pythonnoob9903/MA-project/documentation.md

# Documentation
## 30.12-5.1
1. autonomous takeoff and flying to point
2. crashing due to high HDOP value
3. crashing due to wire that came of from the previous crash
4. reviewed by multiple people and edited accordingly
5. writing in section dronekit
6. writing literature review, results, dicussion and outlook, and conclusion
7. adding title page
8. problems with takeoff even though it worked before, one parameter was changed... changing it back
9. finalising the written part
10. printing the matura paper
## 23.12-29.12
1. first autonomous takeoff
2. editing all to page 20
3. adding a flyto function, distance to target function
2. writing
3. preamble.tex instead of having it in the beginning of document.tex
## Week 16.12-22.12
1. trying different kinds of taking off methods did not work
2. programming new ideas to take off
3. writing parts of the introduction
## Week 9.12-15.12
1. writing MavProxy and parts of dronekit
2. trying different ideas for the vehicle.simple_takeoff--> did not work
3. sophisticating the log file
## Week 2.12-8.12
1. writing RaspPi and parts of MavProxy
2. some code failsafes and messages to see what failed
3. adding a log file
4. trying to get the drone to fly autonomously, but the simple_takeoff function failed?
## Week 25.11-1.12
1. meters to coordinates convertion
2. getting the VNC to work with my hotspot(I have no idea why it took so long)
3. my code needs more fault proofing before I can testfly
## Week 18.11-24.11
1. getting glossary and tcolorbox to work
2. beginning to program drone
3. getting github to work on RaspberryPi
4. adding the dronekittest.py document to github
5. adding flowchart comments to dronekittest.py

## Week 11.11-17.11
1. getting the channel value to be able to use in the dronekit script
2. beginning to write RaspberryPi Setup
## Week 4.11-10.11
1. designing RasperryPi holder(all three parts)
2. printing the parts and redesign one
3. soldering longer wires to Fc for the Pi
4. arming the motors via python script
5. connecting via serial ports

## Week 28.10-11-3
1. VNC connection
2. getting MAvProxy to work
3. getting Dronekit to work

## Week 21.10-27.10
1. small mostly grammatical changes
2. setting up raspberry pi with ssh connection
3. trying to get VNC connection
## Week 14.10-20.10
1. adding the command \comment[1]{} to latex(deleting it again and using %TODO)
2. starting software considerations chapter
3. soldering motor wire that fell off to esc again
4. getting drone to spin(not to fly because motors are wrongly configured)
5. getting drone to fly, really wobbly
6. drone flies without wobblying
7. writing at software considerations, Fc, ESC,Motor, Battery, Problems, GCS, Firmware installation, GPS connection
8. flying drone and filming it
9. writing GNSS, Radio/Transmitter, Smoke stopper, props/battery charger, reciever/transmitter, battery, motor test, compass callibration, road to first flight
10. adding the pictures

### Questions
- How to cite a picture/the source of the picture?
- What should be in the caption of the picture?
- How should the links be sorted? Because I don't think having them sorted from their dates is a good option.
## Week 7.10-13-10
1. solving the GPS issue(was really easy when I finally found the issue(took 3 hours))
2. trying to get the transmitter connection to the receiver works but not to mission planner or the Fc
3. receiver transmitter works
4. connecting battery to esc via smoke stopper works fine
5. changing parameters to see voltage and amperage on MP
6. compass calibration fail due to no GPS lock
7. compass calibration works(no idea why, probably large vehicle mag cal)
8. soldering one of the Motor cables, because it fell off
9. magfield problems
10. arming on my table after disabling arming_check

### Open Questions
- I will write a message per teams tomorrow.(14.10) with them

## Week 30.9-6.10
1. Flashing Ardupilot onto the Fc with STM32 CubeProgrammer
2. First connection Fc wih MP(Mission Planner)
3. problems with trying to get a GPS signal

### Open Questions
- no new ones
## Week 22.9-29.9

1. Adding to Ground Station and Mission Planner
2. short adding of information about preexisting flightsoftware of Kakute H7 in parts
3. downloading of STM32 CubeProgrammer and latest stable version of Ardupilot for the Kakute H7
### Open Questions
-  If there is no date when the Website was created and no author can I leave them out or should I write something like "unknown"?
[STM32CubeProgrammer](www.st.com/en/development-tools/stm32cubeprog.html)
