pythonnoob9903/MA-project/Random/tempmaturaarbeit.odt

2 Literature Review

After extensive internet research it becomes clear that only one kind of a comparable published

autonomous drone project exists, one with a flight controller (Fc) from the Pixhawk family of Fcs

in connection to a Raspberry Pi [11, 21, 59]. However, it is clear that there are many underground

drone laboratories in the Ukraine war, which do not publish their advances in drone technologies

due to the risk of being bombed by their own inventions. Additionally, there are many large firms,

like Amazon, that are trying to deliver their packages by drones [26].

4 Results

The various test flights showed promising results. The drone followed the path from the coordinates.txt file, which was the main goal of this Matura paper. The different trials showed also, how much one or two parameters already influence the capability of the drone to fly.

Another challenge was integrating the different software components, which are not transparent and sometimes outdated. The software components often conflicted during drone takeoff, with one allowing flight while another prevented it. This also shows the difficulty of software integration, which is a tedious and time expensive task.

This Matura paper also shows how important a log file is for an autonomous system, because once the system takes control, it is impossible to know what is happening and without the data provided by a log file one can also not improve the system.

5 Discussion and Outlook

It should be noted that the built drone is only a proof of concept and requires further testing and tuning to reach full maturity. Additionally, a (infrared) camera can be added to the Raspberry Pi. Due to the nature of the Raspberry Pi being a fully functioning computer, unlike an Arduino, the pictures taken by the camera could be processed directly onboard for tasks such as image recognition. This would be straight-forward, because it is already integrated into the in Raspberry Pi.

6 Conclusion

A general problem in the development process was that the development location at home lacked both a GPS connection and space to test the drone. At home, there was enough space for a soldering/work station to assemble the drone and my 3D printer was also nearby. This came in handy when I misplaced the screw holes in the first iteration of the LowerPiMount and needed to print the revised part again. However, the trips to another location for testing were time-consuming because every time the drone needed to be tested the entire setup -including the laptop- was packed into a bag, moved to the location, and reassembled.

The entire project was interesting, and I learned a lot -from sourcing parts to soldering to codingbut it was also exhausting and sometimes even nerve-racking. It was not entirely sure if the drone would even fly at some point. However, I was quite relieved when it finally did.
