pythonnoob9903/MA-project/Random/main.pdf

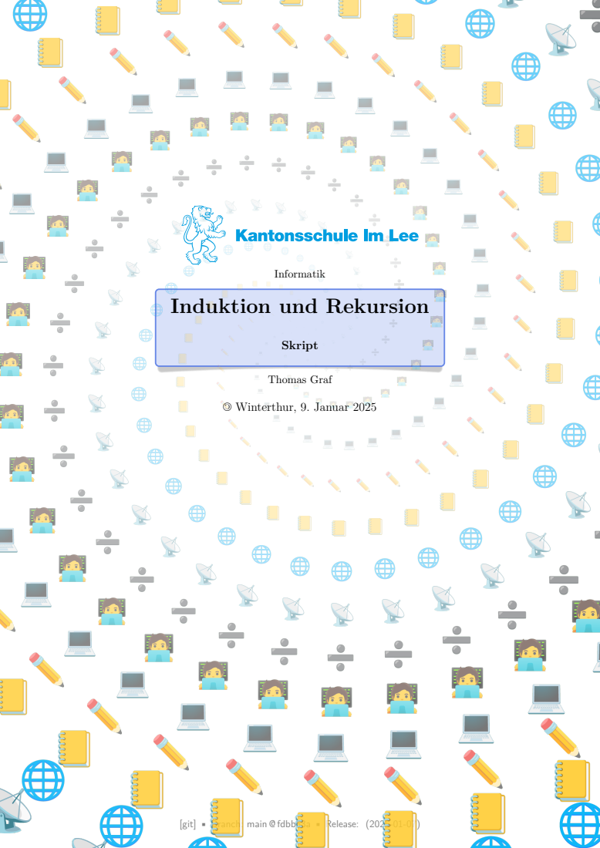
[picture p30: page 1]
Informatik; Skript; Thomas Graf; « Winterthur, 9. Januar 2025

Induktion und Rekursion

[git] • Branch: main @ fdbb53a • Release: (2025-01-07)

# Inhaltsverzeichnis

1 Vorwissen | 1
2 Die natürlichen Zahlen | 6
3 Das Induktionsprinzip | 17
4 Rekursion | 42
5 Binäre Strings ohne aufeinanderfolgende Einsen | 61

Induktion und Rekursion | « Thomas Graf, Informatik, 2025
6 Sortieren (*) | 69
7 Sudoku und Backtracking (*) | 76
Literatur | 94

# Kapitel 1

# Vorwissen

Diese Unterlagen behandeln anspruchsvolle Inhalte der Informatik und Mathematik. Um ihnen gerecht zu werden, bedarf es einer mathematisch präzisen Ausdrucksweise. Den überwiegenden Teil der benötigten mathematischen Werkzeuge werden die Lesenden typischerweise in den ersten Jahren des Gymnasiums kennengelernt haben. Einige der von uns benötigten Konzepte werden den meisten Lesenden jedoch vermutlich noch nicht bekannt sein. Diese Konzepte wollen wir in diesem Kapitel einführen. Wir werden dies in kompakter Form tun und an verschiedenen Stellen auf artifiziell wirkende (forcierte) Beispiele bewusst verzichten.

## 1.1 Mathematik

### 1.1.1 Direkter und indirekter Beweis

Seien A und C mathematische Aussagen. Wir möchten beweisen, dass die Aussage

A ⇒ C
(A impliziert C) gilt. Solch ein Beweis kann im Wesentlichen auf zwei Arten erbracht werden: entweder durch einen direkten Beweis oder einen indirekten Beweis.

### 1.1.1.1 Direkter Beweis

Der direkte Beweis macht von folgender logischen Tatsache Gebrauch: Impliziert A eine weitere Aussage B

A ⇒ B
und B impliziert wiederum C:

B ⇒ C,
dann impliziert A auch C. Zusammengefasst gilt also:
((A ⇒ B) und (B ⇒ C)) ⇒ (A ⇒ C). | (1.1)
Um die Richtigkeit der Implikation A ⇒ C zu beweisen, zerlegt man die Implikation in bereits als für richtig befundene „Teilaussagen“ A ⇒ B und B ⇒ C, also

(A ⇒ B) und (B ⇒ C).

Danach folgt die Implikation A ⇒ C aus Ausdruck 1.1. Diese Strategie kann wiederholt angewendet werden und man erhält eine „Kette“ logischer Implikationen (Schlüsse):

((A ⇒ B1) und (B1 ⇒ B2) und (B2 ⇒ B3) und . . . und (Bn ⇒ C)) ⇒ (A ⇒ C).
Dabei können die Begründungen der Implikationen A ⇒ B1, Bn ⇒ C sowie Bk ⇒ Bk+1 für jedes k ∈ {1, 2, . . . , n − 1} als logische „Zwischenschritte“ verstanden werden.

### 1.1.1.2 Indirekter Beweis

Ein indirekter Beweis (Beweis durch Widerspruch) beginnt mit der Annahme, dass die Aussage C falsch sei, dass also ¬C (nicht C) richtig ist. Nun wird einzig, unter Verwendung der Richtigkeit von A und ¬C sowie bereits als wahr erkannter mathematischer Aussagen, die Richtigkeit einer Aussage B abgeleitet, von der bereits bekannt ist, dass sie falsch ist. Dadurch haben wir einen „Widerspruch“ erhalten und können folgern, dass ¬C nicht richtig sein kann und somit C wahr sein muss. Damit ist, wie gewünscht, die Implikation A ⇒ C nachgewiesen.

### 1.1.2 Kontraposition

Seien A und B mathematische Aussagen. Logisch äquivalent zur Behauptung A ⇒ B ist die Aussage ¬B ⇒ ¬A, welche Kontraposition der Implikation A ⇒ B genannt wird. Der Beweis für A ⇒ B ist demnach auch erbracht, falls man zeigen kann, dass aus der Annahme, die Folgerungen seien nicht erfüllt, folgt, dass auch die Voraussetzungen nicht erfüllt sein können. Gelegentlich fällt es einem leichter, die Kontraposition ¬B ⇒ ¬A einer Implikation A ⇒ B zu zeigen.
Beispiel 1.1:
Sei A die Aussage „Es hat geregnet.“ und B die Aussage „Die Strasse ist nass.“. Die Implikation A ⇒ B bedeutet: „Falls es geregnet hat, ist die Strasse nass.“
Falls die Strasse nass ist, muss das umgekehrt nicht bedeuten, dass es geregnet hat. Beispielsweise könnte die Strasse auch von der Strassenreinigung nass gemacht worden sein. Was wir aber sicherlich sagen können, ist, dass falls die Strasse nicht nass ist, es auch nicht geregnet haben kann, was genau ¬B ⇒ ¬A bedeutet.

### 1.1.3 Funktionen

### 1.1.3.1 Definition einer Funktion

Definition 1.1 (Funktion als Vorschrift):
Seien X und Y Mengen. Wir sagen, dass eine Funktion auf X mit Werten in Y definiert ist, wenn aufgrund einer Vorschrift (Regel) f jedem Element x ∈ X genau ein Element y ∈ Y zugehörig ist.

Wir sagen dann, dass die Menge X die Definitionsmenge der Funktion ist.
Das Symbol x, das benutzt wird, um ein allgemeines Element dieser Menge zu beschreiben, wird Argument oder unabhängige Variable der Funktion genannt.
Das Element y0 ∈ Y , das einem Argument x0 ∈ X zugeordnet wird, wird Wert der Funktion in x0 genannt oder auch Wert der Funktion an der Stelle x = x0 und f(x0) geschrieben. Die Menge Y wird Zielmenge der Funktion genannt.
Bei Änderung der Argumente x ∈ X verändern sich im Allgemeinen die Resultate y = f(x) ∈ Y in Abhängigkeit von den Werten x. Aus diesem Grund wird die Grösse y = f(x) oft auch abhängige Variable genannt.

Definition 1.2 (Bild einer Funktion):
Die Menge
im (f) := { y ∈ Y ; es existiert ein x ∈ X mit y = f(x) } von Werten, die von einer Funktion f für alle Elemente in der Menge X angenommen werden, wird Bild (englisch: image) oder Wertemenge der Funktion f : X → Y genannt. Häufig wird im (f) alternativ als f(X) geschrieben, wobei X die Definitionsmenge von f ist.

### 1.1.3.2 Surjektion, Injektion, Bijektion

In diesen Unterlagen werden wir häufig über Funktionen sprechen. Insbesondere werden wir die folgenden drei Eigenschaften von Funktionen mehrmals verwenden.

Definition 1.3 (surjektiv, injektiv, bijektiv):
Seien X und Y Mengen und f : X → Y eine Funktion.
- f heisst surjektiv (eine Surjektion), falls im (f) = Y .
Intuitiv gesprochen, nimmt eine surjektive Funktion jeden Wert in der Zielmenge an. Zu beliebigem y ∈ Y existiert (mindestens) ein x ∈ X, sodass y = f(x).
- f heisst injektiv (eine Injektion), falls für x1, x2 ∈ X aus x1 6= x2 stets f(x1) 6= f(x2) folgt.
Zwei verschiedene Eingaben erzeugen stets verschiedene Ausgaben.
- f heisst bijektiv (eine Bijektion), falls f sowohl surjektiv als auch injektiv ist.
Da f surjektiv ist, existiert zu jedem y ∈ Y ein x ∈ X mit f(x) = y. Da f injektiv ist, kann es kein anderes x˜ ∈ X mit x˜ 6= x geben, sodass f(˜x) = y. Dadurch stellt eine Bijektion eine „Eins-zu-eins-Zuweisung“ zwischen den Elementen aus X und Y dar.

X

Y

(a) surjektiv, nicht injektiv

X

Y

(b) injektiv, nicht surjektiv

X

Y

(c) bijektiv
Abbildung 1.1: schematische Darstellung der Eigenschaften in Definition 1.3

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
(a) surjektiv, nicht injektiv

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
(b) injektiv, nicht surjektiv
X | Y
10
3
15
1 | 1
| 5
| 8
| 15
(c) bijektiv
Abbildung 1.2: Diagramm-Darstellung der Eigenschaften in Definition 1.3

Betrachten Sie Abbildung 1.1. Diese stellt die in Definition 1.3 beschriebenen Eigenschaften für eine Funktion f : X → Y schematisch dar. Abbildung 1.1a zeigt eine Funktion, die surjektiv, aber nicht injektiv ist, Abbildung 1.1b eine Funktion, die injektiv, aber nicht surjektiv ist. Schliesslich wird in Abbildung 1.1c eine bijektive Funktion dargestellt. Abbildung 1.2 illustriert Surjektivität, Injektivität und Bijektivität für einfache Funktionen auf konkreten endlichen Mengen. Surjektivität, Injektivität und Bijektivität sind Eigenschaften, welche eine gegebene Funktion entweder haben kann oder nicht.

### 1.1.3.3 Folgen

Definition 1.4 (Folge):
Ist X eine beliebige Menge und f : N → X eine Funktion, welche auf N definiert ist und Werte in X annimmt, dann wird f eine Folge (in X) genannt. Ist g : D → X eine Funktion und D ( N eine endliche Teilmenge der natürlichen Zahlen, so wird g endliche Folge in X genannt.

Häufig schreibt man (xn)n∈N,(xn) oder auch (x0, x1, x2, . . .) für die Folge f. Dabei bezeichnet xn := f(n) das n-te Glied der Folge f = (x0, x1, x2, . . .) für jedes n ∈ N.

Beispiel 1.2:
Die Funktion f : N → Z mit n 7→ 2n ist die Folge der geraden natürlichen Zahlen.

## 1.2 Programmieren in Python

Wir werden hier keine Einführung in die Python-Programmiersprache geben. Wir führen im Folgenden einige Details der Python-Sprache auf, welche wir in den Übungsaufgaben der nächsten Kapitel verwenden werden.
- Der Modulo-Operator % (Prozent-Symbol) kann in der Form a % b verwendet werden und liefert den ganzzahligen Rest bei der Division von a mit b. Beispielsweise sind die folgenden Ausdrücke wahr:
7 % 3 == 1, 5 % 8 == 5, 22 % 4 == 2, 42 % 6 == 0. Wir werden den Modulo-Operator zur Überprüfung auf Teilbarkeit verwenden. Denn b ist offensichtlich genau dann ein Teiler von a, falls a % b == 0 gilt.
- Eine Liste in Python wird durch eckige Klammern gekennzeichnet. Beispielsweise ist [3,2,2,7] eine Liste mit 4 Einträgen. Eine leere Liste (Liste ohne Einträge) wird durch „leere eckige Klammern“ [] bezeichnet. Mit dem Aufruf L.append(x) wird ein Eintrag x hinten (von rechts) in eine bereits bestehende Liste L eingefügt (angehängt). Mit L[-1] wird der letzte (am weitesten rechts stehende) Eintrag der Liste L bezeichnet. Der Ausdruck L[:-1] bezeichnet alle Einträge der Liste mit Ausnahme des letzten.
- In Python existiert die Möglichkeit, Argumenten einer Funktion ein Default-Argument zu geben.
# Default-Argument in Python

def eineFunktion(a, b = 5):
print(a + b)

eineFunktion(3,6) # gibt den Wert 9 aus
eineFunktion(3) # Aufruf mit Default-Argument b = 5: gibt den Wert 8 aus Programm 1.1: Default-Argument

Dieses Default-Argument wird genau dann verwendet, falls kein Wert für dieses Argument (explizit) angegeben wird.
- Die Operation math.ceil(x) wird Aufrundungs-Operation genannt und gibt die kleinste ganze Zahl, die grösser oder gleich x ist. Beispielsweise gelten math.ceil(3.2) = 4 und math.ceil(3) = 3. Um diese Operation verwenden zu können, muss die Bibliothek math durch den Befehl import math vor dem Gebrauch dieser Operation ins Programm eingefügt werden.
In Listing 1.2 haben wir die obigen Punkte noch einmal zusammengefasst.
1 # gibt die durch 19 teilbaren Zahlen in {0,1,2,...,99} aus:
2 for k in range(100):
3 | if (k % 19) == 0:
4 | print(k) # gibt aus: 0 19 38 57 76 95

5
6 # Listen
7 L = [3, 7, 2, 3]
8 L.append(99) # L ist nun [3, 7, 2, 3, 99]. 9 print(L[-1]) # gibt aus: 99
10 print(L[:-2]) # gibt aus: 3, 7, 2

11
12 # Default-Argument
13 def person(vorname, nachname = 'Nachname unbekannt', alter = '-'):
14 | print('Vorname: ', vorname, ', ' , 'Nachname: ', nachname, ', ', 'Alter: ',
| alter, sep='')

15
16 person('Sandra') # gibt aus: Vorname: Sandra, Nachname: Nachname unbekannt,
| Alter: -

17
18 person('Toni', 'Wildeisen') # gibt aus: Vorname: Toni, Nachname: Wildeisen,
| Alter: -

19
20 # Importieren einer Bibliothek und Verwendung der Aufrundungs-Funktion
21 import math # Einfügen der Bibliothek 'math'
22 print(math.ceil(3.00002)) # gibt aus: 4
| Programm 1.2: Vorwissen Python

# Kapitel 2

# Die natürlichen Zahlen

## 2.1 Historische Betrachtung der natürlichen Zahlen

Die natürlichen Zahlen werden so genannt, da sie auf „natürliche Weise“ beim Zählen verwendet werden. Auf dem Gebiet der heutigen Demokratischen Republik Kongo wurde im 20. Jahrhundert ein Knochen, der sogenannte Ishango-Knochen, gefunden. Dieser Knochen wird auf die Zeit vor etwa 18’000 bis 20’000 Jahren vor unserer Zeitrechnung datiert. In dem Knochen sind ganz offensichtlich von Menschen einige Kerben eingeritzt worden. Die Bedeutung dieser Kerben ist nicht klar. Es wird jedoch angenommen, dass diese Kerben eine bestimmte Anzahl festhalten.
Stellen wir uns vor, dass die Kerben die Anzahl der gefangenen Fische ( ) an einem bestimmten Tag darstellen. Gefangene Fische durch Kerben in einem Knochen zu repräsentieren, verlangt bereits einen recht hohen Grad an Abstraktion! Schliesslich haben gefangene Fische und Kerben in einem Knochen auf den ersten Blick keinen offensichtlichen Zusammenhang. Anstelle von Kerben in einem Knochen könnte die Fangmenge eines Tages auch durch die entsprechende Anzahl von Kieselsteinen oder durch (abstraktere) römische Numerale repräsentiert werden. Wichtig für uns ist, dass die konkrete Wahl der Darstellung, zumindest rein mathematisch betrachtet, unwichtig ist. Schliesslich stellen die verschiedenen Darstellungen alle dieselbe Anzahl von Fischen dar. Betrachten Sie Tabelle 2.1. Mit dem Symbol meinen wir nicht ein Fisch-Emoji, sondern den eigentlich gefangenen Fisch. Die direkte Darstellung der Anzahl der gefangenen Fische durch sich selbst ist offensichtlich am wenigsten abstrakt. Die Darstellung durch Kerben oder Kieselsteine bedarf bereits einer nicht unerheblichen Abstraktion. Dhttps://www.youtube.com/watch?v=c8l7K67idZcie Darstellungen durch das römische, dezimale und binäre Zahlensysteme sind noch eine Stufe abstrakter.
Fische | Kieselsteine | römisch binär dezimal
(keine) | (keine) nichts (nihil) | 0 | 0
- | I | 1 | 1
•• | II | 10 | 2
••• | III | 11 | 3
•••• | IV | 100 | 4
••••• | V | 101 | 5
•••••• | VI | 110 | 6
••••••• | VII | 111 | 7
•••••••• | VIII | 1000 | 8
••••••••• | IX | 1001 | 9
Tabelle 2.1: mögliche Darstellungen der Anzahl gefangener Fische

Die Zahl Null hat eine lange und kontroverse Geschichte hinter sich. Vermutlich hatten die Römer kein explizites eigenes Symbol für die Null. Wir werden jedoch die Null als die erste (kleinste) natürliche Zahl auffassen.

## 2.2 Unendlichkeit der natürlichen Zahlen und konstruktive Induktion

Bereits aufgrund der kurzen Anekdote über die gefangenen Fische und Kieselsteine in Abschnitt 2.1 kann man sich denken, dass es unendlich viele natürliche Zahlen geben muss. Wieder denken wir uns eine natürliche Zahl als genau das Symbol, welches eine bestimme Anzahl an Kieselsteinen darstellt. Dann ist klar, dass es keine grösste natürliche Zahl geben kann, denn schliesslich kann stets ein weiterer Kieselstein hinzugefügt werden, was uns eine noch grössere Zahl liefert. Zu jeder natürlichen Zahl n, angefangen mit der 0, erhalten wir (durch Hinzufügen eines Kieselsteins) eine weitere natürliche Zahl. Diese neue Zahl werden wir den Nachfolger von n nennen. Die folgenden Überlegungen dieses Kapitels formalisieren diese Vorstellungen und stellen diese mathematisch präzise dar. Doch auch ohne mathematische Formeln können wir das folgende Gedankenexperiment durchführen. Angenommen Sie sind in der Lage Folgendes zu tun:
- Sie können eine Treppe mit 0 Stufen (ohne Stufen) bauen.
- Falls Sie bereits eine Treppe mit einer beliebigen (natürlichen) Anzahl von Stufen gebaut haben, dann können Sie diese Treppe um eine Stufe erweitern (siehe Abbildung 2.1).
Dann werden Sie es für glaubhaft halten, dass Sie eine Treppe mit beliebig vielen Stufen bauen können. Wie dieses Gedankenexperiment mit der mathematischen Definition der natürlichen Zahlen zusammenhängt, werden Sie im nächsten Abschnitt sehen.

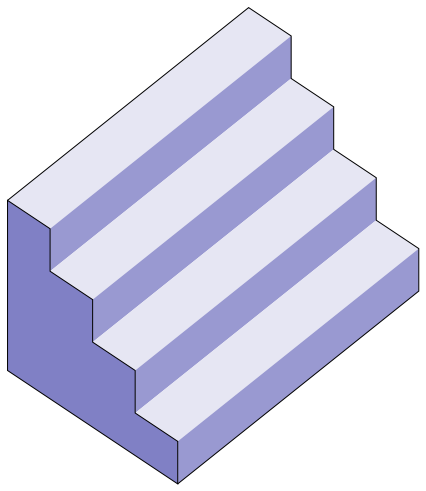
[picture p31: figure]
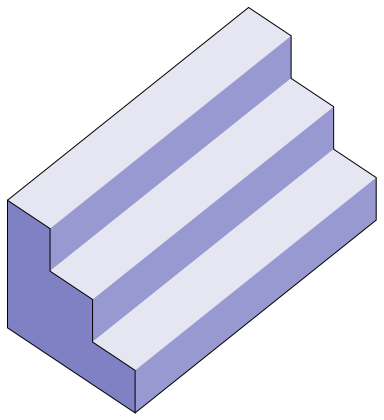
[picture p32: figure]

Abbildung 2.1: Erweiterung einer Treppe um eine weitere Stufe.

## 2.3 Die Peano-Axiome

Uns ist vollkommen bewusst, dass Sie bereits seit Ihrer Kindheit mit dem Konzept der natürlichen Zahlen vertraut sind. Sie konnten vermutlich schon als Kleinkind Gegenstände zählen und lernten spätestens in der Grundschule die Addition und Multiplikation natürlicher Zahlen kennen. Für diese einfachen Anwendungen reicht eine rein intuitive Beschreibung der natürlichen Zahlen vollkommen aus.

Sie werden jedoch festgestellt haben, dass mit fortschreitender schulischer Reife eine präzise Definition von Begriffen und Konzepten zunehmend an Bedeutung gewinnt. Auf der Stufe des Gymnasiums wird der bis dorthin rein intuitiv geprägte Begriff der natürlichen Zahlen durch das Konzept der Mengen formalisiert. Ab dann wird von der Menge der natürlichen Zahlen, bezeichnet durch das Symbol N, gesprochen.

## 2.4 Informale Definition der natürlichen Zahlen

In Lehrbüchern des Gymnasiums (siehe zum Beispiel [1]¹
) wird die Menge der natürlichen Zahlen typischerweise wie folgt definiert:

Definition 2.1 (Informale Definition der natürlichen Zahlen): Die Menge

N := {0, 1, 2, 3, 4, . . .}
wird als die Menge der natürlichen Zahlen bezeichnet.

Man beginnt also bei 0 und zählt dann unbegrenzt weit nach vorne. In einem gewissen Sinne beantwortet Definition 2.1 die Frage, was natürliche Zahlen sind: Eine natürliche Zahl ist ein Element der Menge N. Dennoch ist die Definition nicht sehr befriedigend, denn sie beantwortet nicht die Frage, was N selbst ist. [2] Wir werden nicht von dieser Definition Gebrauch machen, sondern eine nützlichere Definition entwickeln.
Der folgende Abschnitt ist teilweise inspiriert durch die entsprechenden Teile in den hervorragenden Büchern [2] und [3].
Bei näherer Betrachtung wirft die informale Definition 2.1 insbesondere die folgenden drei Fragen auf:
1. Woher wissen wir, dass wir beliebig lange weiter vorwärts zählen können, ohne schliesslich (wie bei einer Uhr) wieder bei der 0 anzukommen?
2. Wie sollen nun Operationen wie die Addition, Multiplikation und die Potenz definiert werden? Die zweite Frage wollen wir zuerst besprechen. Komplizierte Operationen können durch einfachere Operationen ausgedrückt werden. So ist Potenzieren lediglich wiederholtes Multiplizieren und Multiplizieren wiederum wiederholtes Addieren. Zum Beispiel sind 5

3 nichts weiter als drei Fünfer miteinander multipliziert und 6 · 3 lediglich sechs Dreien miteinander addiert. Wie sieht es mit der Addition aus? Die Addition kann durch wiederholtes Inkrementieren oder Vorwärtszählen realisiert werden. Bei der Addition 4 + 3 wird die Vier dreimal inkrementiert (wir zählen von der Vier aus dreimal vorwärts). Inkrementieren scheint eine fundamentale Operation zu sein, welche sich nicht auf eine noch einfachere Operation reduzieren lässt.
Eine sinnvolle Definition der natürlichen Zahlen scheint also das Inkrementieren als fundamentales Konzept zu verwenden. Für eine natürliche Zahl n werden wir im Folgenden mit ν(n) das Inkrement von n bezeichnen. Wir werden ν(n) auch den Nachfolger von n nennen. Zum Beispiel gilt 3 = ν(2), 4 = ν(3) = ν(ν(2)) und so weiter. Das Inkrementieren liefert uns also einen „Zählvorgang“, der bei 0 beginnt. Die bisherigen Überlegungen lassen vermuten, dass wir N als die Menge mit den Elementen

0, ν(0), ν(ν(0)), ν(ν(ν(0))), ν(ν(ν(ν(0)))), ν(ν(ν(ν(ν(0))))), . . .
1Dieses Buch bietet allerdings auch eine alternative Definition der natürlichen Zahlen an.

ansehen wollen. Diese Menge enthält 0 und alle Objekte, welche aus 0 durch Inkrementieren erhalten werden können. Sie wissen bereits, dass fundamentale (nicht beweisbare) Annahmen in der Mathematik als Axiome bezeichnet werden. Bislang haben wir zwei fundamentale Annahmen bezüglich der Menge N der natürlichen Zahlen getroffen. Diese fassen wir in zwei Axiomen zusammen:

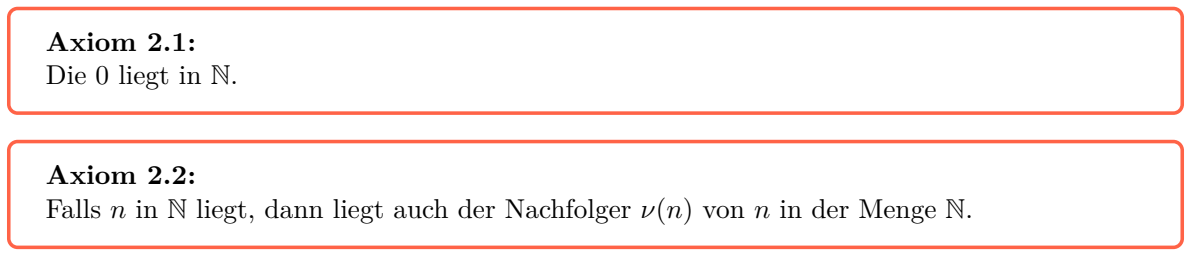
[picture p33: figure]
Axiom 2.1: Die 0 liegt in N.; Axiom 2.2:

Falls n in N liegt, dann liegt auch der Nachfolger ν(n) von n in der Menge N.

Dies sind die ersten zwei von insgesamt fünf Axiomen, welche zusammen bekannt sind als die Peano-Axiome der natürlichen Zahlen. Die Peano-Axiome sind benannt nach dem italienischen Mathematiker Giuseppe Peano, welcher diese Axiome im Jahr 1889 formulierte.

Bemerkung 2.1:

- Beachten Sie, dass Axiom 2.2 lediglich aussagt, dass der Nachfolger ν(n) einer natürlichen Zahl n wieder eine natürliche Zahl ist. Das Axiom sagt nichts darüber aus, wie dieser Nachfolger lautet.
- Manche Autorinnen und Autoren ziehen es vor, den „Zählvorgang“ nicht bei 0, sondern bei 1 zu beginnen. Dies ist mathematisch ohne Bedeutung. [3]
- Wir definieren 1 := ν(0), 2 := ν(1) = ν(ν(0)), 3 := ν(2) = ν(ν(ν(0))) und so weiter. Anstelle von

0, ν(0), ν(ν(0)), ν(ν(ν(0))), ν(ν(ν(ν(0)))), ν(ν(ν(ν(ν(0))))), . . .
schreiben wir üblicherweise 0, 1, 2, 3, 4, 5, . . .

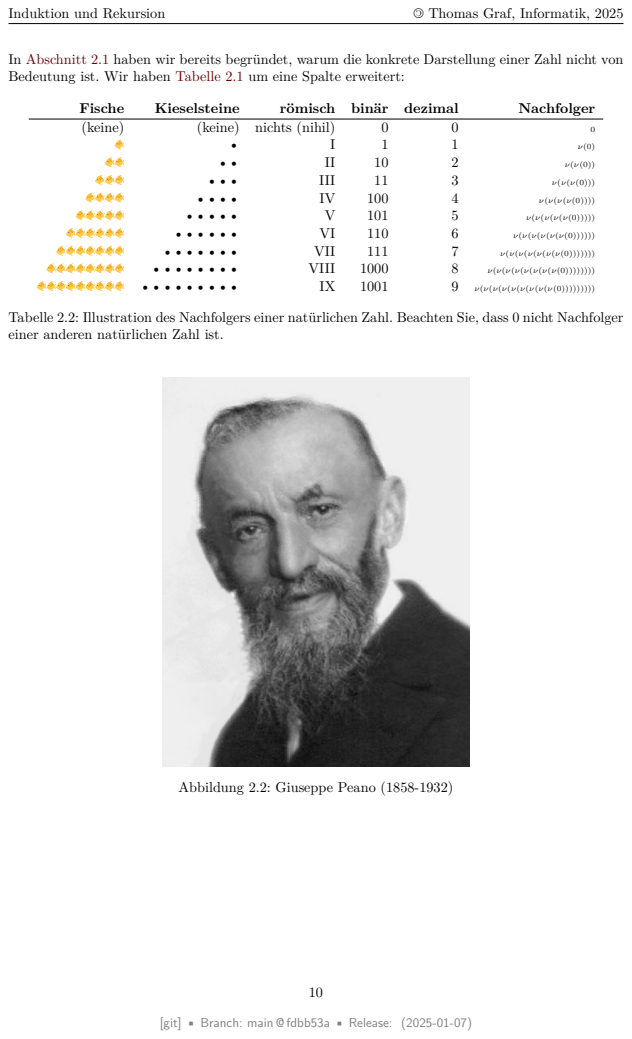
[picture p34: page 13]
Fische; Kieselsteine; römisch binär dezimal; Nachfolger; (keine); (keine) nichts (nihil); III; VII; VIII

In Abschnitt 2.1 haben wir bereits begründet, warum die konkrete Darstellung einer Zahl nicht von
Bedeutung ist. Wir haben Tabelle 2.1 um eine Spalte erweitert:

Tabelle 2.2: Illustration des Nachfolgers einer natürlichen Zahl. Beachten Sie, dass 0 nicht Nachfolger
einer anderen natürlichen Zahl ist.

Abbildung 2.2: Giuseppe Peano (1858-1932)

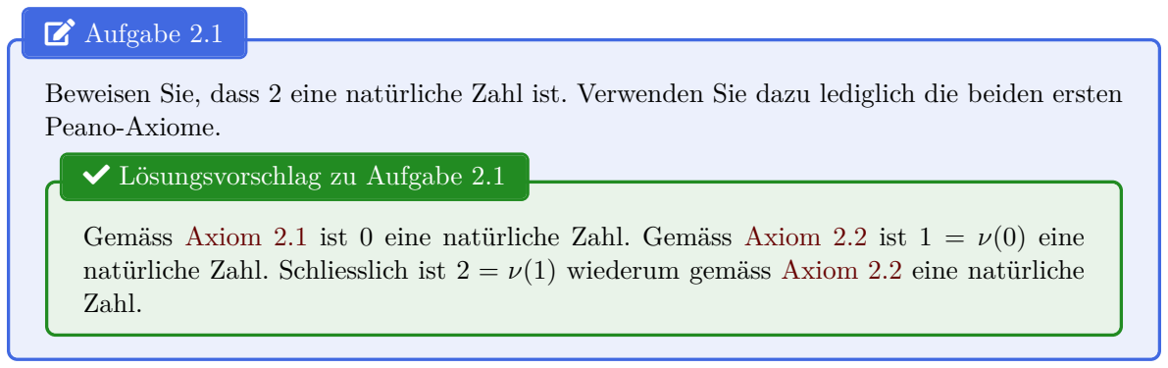
[picture p35: figure]
EDIT Aufgabe 2.1; Peano-Axiome. Check Lösungsvorschlag zu Aufgabe 2.1; Zahl.

Beweisen Sie, dass 2 eine natürliche Zahl ist. Verwenden Sie dazu lediglich die beiden ersten

Gemäss Axiom 2.1 ist 0 eine natürliche Zahl. Gemäss Axiom 2.2 ist 1 = ν(0) eine natürliche Zahl. Schliesslich ist 2 = ν(1) wiederum gemäss Axiom 2.2 eine natürliche

Bereits Giuseppe Peano stellte fest, dass diese ersten beiden Axiome nicht ausreichend sind, um unsere intuitive Vorstellung der natürlichen Zahlen einzufangen. Es könnte sein, dass wir bei dem Vorwärtszählen schliesslich wieder bei 0 ankommen. Betrachten wir dazu ein Modell der natürlichen Zahlen, welches von 3 zurück zur 0 zählt, genauer: ν(0) ist 1, ν(1) ist 2, ν(2) ist 3, aber ν(3) ist wieder 0 (und gemäss der Definition von 4 auch gleich der 4). So erfüllt also auch die Menge {0, 1, 2, 3} die ersten zwei Peano-Axiome und könnte als Menge der natürlichen Zahlen angesehen werden.

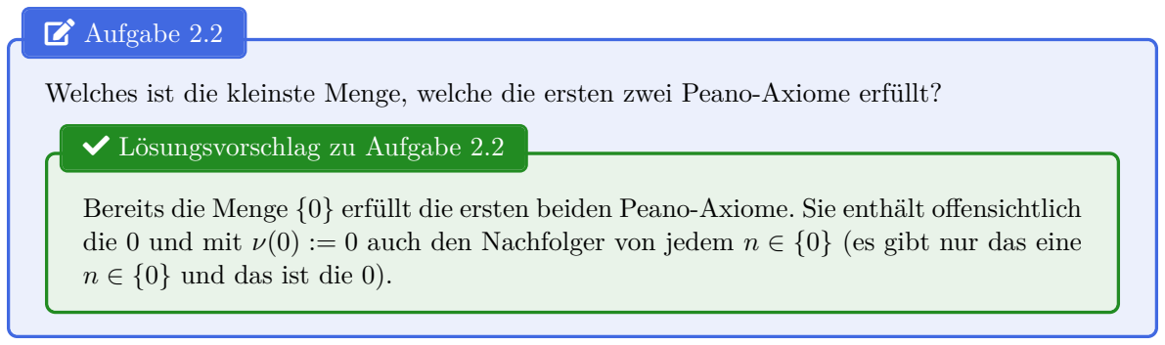
[picture p36: figure]
EDIT Aufgabe 2.2; Check Lösungsvorschlag zu Aufgabe 2.2; n ∈ {0} und das ist die 0).

Welches ist die kleinste Menge, welche die ersten zwei Peano-Axiome erfüllt?

Bereits die Menge {0} erfüllt die ersten beiden Peano-Axiome. Sie enthält offensichtlich
die 0 und mit ν(0) := 0 auch den Nachfolger von jedem n ∈ {0} (es gibt nur das eine

Die Axiome 2.1 und 2.2 erlauben also auch Mengen, welche wir sicherlich nicht als Modelle der natürlichen Zahlen anschauen möchten. Wir müssen die erlaubten Nachfolger der Elemente der Mengen weiter einschränken. Auf jeden Fall stellen wir fest, dass die 0 nicht Nachfolger einer natürlichen Zahl sein soll und fordern deshalb:

Axiom 2.3:
Die 0 selbst ist nicht Nachfolger einer natürlichen Zahl. Es gilt also ν(n) 6= 0 für jede natürliche Zahl n.

Bemerkung 2.2:
Wir bezeichnen mit N

× die Menge der natürlichen Zahlen ohne die 0. Für jede natürliche Zahl n soll der Nachfolger ν(n) von n wieder eine natürliche Zahl sein. Da gemäss Axiom 2.3 die 0 nicht Nachfolger einer natürlichen Zahl ist, können wir uns ν als Funktion

ν : N → N

×,

n 7→ ν(n)
denken. Diese erhält eine natürliche Zahl n als Eingabe und liefert die natürliche Zahl ν(n), welche nicht die 0 ist, als Ausgabe.

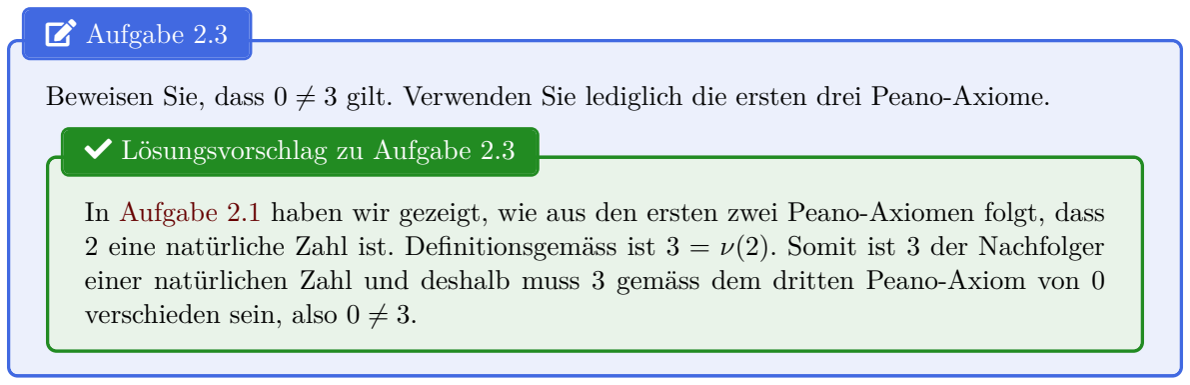
[picture p37: figure]
EDIT Aufgabe 2.3; Check Lösungsvorschlag zu Aufgabe 2.3; verschieden sein, also 0 6= 3.

Beweisen Sie, dass 0 6= 3 gilt. Verwenden Sie lediglich die ersten drei Peano-Axiome.

In Aufgabe 2.1 haben wir gezeigt, wie aus den ersten zwei Peano-Axiomen folgt, dass 2 eine natürliche Zahl ist. Definitionsgemäss ist 3 = ν(2). Somit ist 3 der Nachfolger einer natürlichen Zahl und deshalb muss 3 gemäss dem dritten Peano-Axiom von 0

Betrachten Sie ein Zahlensystem, welches 0 enthält und für das gilt: ν(0) ist 1, ν(1) ist 2, ν(2) ist 3, aber ν(3) bleibt 3 (also 4 = 3, 5 = 3, 6 = 3 und so weiter). Es ist auch ein Zahlensystem vorstellbar, welches von 3 zurück zu 1 geht, also ν(3) = 1, ν(1) = 2, ν(2) = 3, ν(3) = 1 und so weiter. Die beiden Beispiele erfüllen alle drei ersten Peano-Axiome. Das Problem ist, dass die ersten drei Peano-Axiome erlauben, dass verschiedene natürliche Zahlen gleiche Nachfolger haben können. Diese Möglichkeit wollen wir also ausschliessen. Dazu fügen wir das vierte Peano-Axiom hinzu:

Axiom 2.4:
Unterschiedliche natürliche Zahlen haben unterschiedliche Nachfolger. Sind also n, m natürliche Zahlen und n 6= m, dann gilt ν(n) 6= ν(m). Die Kontraposition dieser Aussage lautet: Gilt ν(n) = ν(m), dann folgt n = m.

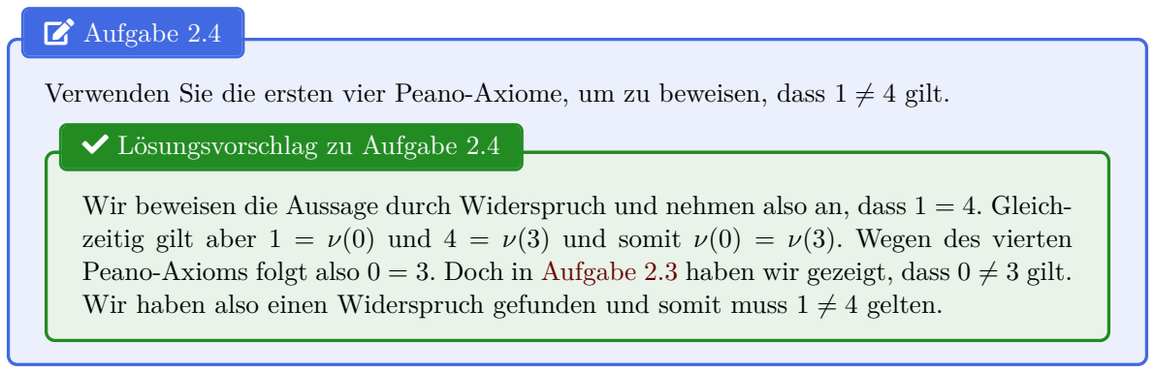
[picture p38: figure]
EDIT Aufgabe 2.4; Check Lösungsvorschlag zu Aufgabe 2.4

Verwenden Sie die ersten vier Peano-Axiome, um zu beweisen, dass 1 6= 4 gilt.

Wir beweisen die Aussage durch Widerspruch und nehmen also an, dass 1 = 4. Gleichzeitig gilt aber 1 = ν(0) und 4 = ν(3) und somit ν(0) = ν(3). Wegen des vierten Peano-Axioms folgt also 0 = 3. Doch in Aufgabe 2.3 haben wir gezeigt, dass 0 6= 3 gilt.
Wir haben also einen Widerspruch gefunden und somit muss 1 6= 4 gelten.

Wir wollen N als die Menge verstehen, welche die 0 enthält und alle Objekte, welche aus 0 durch Inkrementieren erhalten werden kann. Diese Intuition wird schliesslich auf geniale Weise durch das fünfte Peano-Axiom formalisiert. Dieses letzte Peano-Axiom formuliert auf mathematisch präzise Weise, was mit „aus 0 durch Inkrementieren erhalten werden kann“, gemeint ist:

Axiom 2.5:
Enthält eine Teilmenge N ⊆ N das Element 0 und mit jedem n ∈ N auch den Nachfolger ν(n) von n, so gilt N = N.

### 2.4.1 Kompakte Formulierung der Peano-Axiome

Unser Wissen über Funktionen und ihre Eigenschaften erlaubt uns, die fünf Axiome 2.1 bis 2.5, kompakt und sehr präzise in der folgenden Definition zusammenzufassen:

Definition 2.2 (Formale Definition der natürlichen Zahlen):
Die natürlichen Zahlen sind eine Menge N, in der ein Element 0 ∈ N ausgezeichnet ist und für die es eine Funktion ν : N → N

× (siehe Bemerkung 2.2) mit den folgenden zwei Eigenschaften gibt:
(N0) Die Funktion ν ist injektiv.
(N1) Enthält eine Teilmenge N ⊆ N das Element 0 und mit jedem n ∈ N auch den Nachfolger ν(n) von n, so gilt N = N.

Dabei bezeichnet N

× := N \ {0} die Menge der natürlichen Zahlen ohne die 0. Das Element ν(n) heisst Nachfolger von n und ν heisst Nachfolgerfunktion. Die Eigenschaft (N1) ist identisch zum Axiom 2.5 und wird auch Induktionsaxiom genannt.
EDIT Aufgabe 2.5
Weisen Sie nach, dass Definition 2.2 zu den Peano-Axiomen äquivalent ist.
Check Lösungsvorschlag zu Aufgabe 2.5
Wir zeigen zuerst, dass Definition 2.2 alle fünf Peano-Axiome „abdeckt“.
- Axiom 2.1: Dieses Axiom ist erfüllt, da in der Definition gefordert wird, dass ein Element 0 in N ausgezeichnet ist.
- Axiom 2.2: Dieses Axiom ergibt sich dadurch, dass ν : N → N

× eine Funktion
von den natürlichen Zahlen in eine Teilmenge der natürlichen Zahlen ist. Doch die Elemente einer Teilmenge der natürlichen Zahlen sind offensichtlich ebenfalls natürliche Zahlen.
- Axiom 2.3: Wegen ν : N → N

× liegt die 0 nicht im Bild der Funktion ν. Somit ist also die 0 nicht Nachfolger einer natürlichen Zahl und damit ist auch dieses Axiom erfüllt.
- Axiom 2.4: Dieses Axiom sagt genau, dass die Funktion ν injektiv ist und entspricht somit exakt der Eigenschaft (N0).
- Axiom 2.5: Dieses Axiom entspricht exakt der Eigenschaft (N1).
Da Definition 2.2 keine zusätzlichen Forderungen stellt, ist diese Definition tatsächlich äquivalent zu den Peano-Axiomen.

Erfüllt auch die Menge {0, 2, 4, 6, . . .} der geraden natürlichen Zahlen die Peano-Axiome?

Check Lösungsvorschlag zu Aufgabe 2.6
Die Frage der Aufgabenstellung geht an der eigentlichen Aussage der Peano-Axiome vorbei und ist im Grunde bedeutungslos. Die Peano-Axiome verlangen nicht, dass die natürlichen Zahlen genau die Form

{0, 1, 2, 3, 4, . . .}
haben. Die konkreten Schriftsymbole, mit denen die natürlichen Zahlen bezeichnet werden, werden von den Peano-Axiomen nicht vorgeschrieben. In der üblichen westlichen Schreibweise wird der Nachfolger der 0 mit dem Symbol 1 bezeichnet, der Nachfolger von 1 mit 2 und so weiter. Anstelle von der Konvention

1 := ν(0), 2 := ν(1) = ν(ν(0)), 3 := ν(2) = ν(ν(ν(0))), . . .
könnten wir den Nachfolger der 0 auch mit 2 bezeichnen und den Nachfolger der 2 mit 4 und so weiter. Offensichtlich ist auch das exakte Symbol der Null bedeutungslos. Anstelle von dem Symbol 0 könnten wir auch das Symbol für dieses ausgezeichnete Element verwenden. Es ist nicht einfach, sich auf diese abstrakte Ebene zu begeben. Sie müssen sich von den konkret verwendeten Schriftsymbolen lösen und sich stattdessen auf die Bedeutung der verwendeten Symbole fokussieren.

Begründen Sie, dass die Nachfolgerfunktion ν : N → N
Tipp: Verwenden Sie die beiden Eigenschaften N0 und N1 in Definition 2.2.

Check Lösungsvorschlag zu Aufgabe 2.7
Wie können wir beweisen, dass ν bijektiv ist? Wir dürfen für den Nachweis lediglich bereits bekannte Tatsachen sowie die Peano-Axiome in Definition 2.2 verwenden. Sicherlich können wir zunächst einmal feststellen, dass die Funktion ν wegen der Eigenschaft N0 als injektiv vorausgesetzt ist. Damit ist ν also injektiv. Für den Nachweis der Bijektivität von ν müssen wir nur noch seine Surjektivität zeigen.
Möchte man eine Eigenschaft nachweisen, ist es zunächst einmal sinnvoll, aufzuschreiben, was diese Eigenschaft genau bedeutet. Definitionsgemäss ist ν : N → N

× genau
dann surjektiv, wenn das Bild im (ν) der Zielmenge N

× entspricht, falls also
im (ν) = N
×
gilt. Nun haben wir Eigenschaft N0 in Definition 2.2 bereits ausgenutzt. Es ist daher naheliegend, Eigenschaft N1 zu betrachten. Da N1 eine Aussage über N und nicht etwa über N

× macht, tun wir uns selbst einen Gefallen, wenn wir anstelle von N

× die um
das Element 0 erweiterte „Hilfsmenge“

N := im (ν) ∪ {0}
betrachten. Wir zeigen nun, dass diese Hilfsmenge N eine Teilmenge von N ist, welche die Bedingungen in N1 erfüllt. Offensichtlich gelten N ⊆ N und 0 ∈ N. Für n ∈ N gilt ν(n) ∈ im (ν) ⊆ N. Somit liegt für n ∈ N auch der Nachfolger ν(n) in der Menge N und damit folgt aus N1, dass N = N gilt. Wir haben also die Gleichheit

im (ν) ∪ {0} = N
gezeigt und folgern daraus
im (ν) = N
×.

Bemerkung 2.3:

(a) Aus den grundlegenden Axiomen der Mengenlehre folgt, dass es in der Tat Systeme (N, 0, ν) gibt, welche die Peano-Axiome erfüllen. Diese Modelle der natürlichen Zahlen sind bis auf die Benennung der Elemente gleichwertig und ergeben dieselbe Mathematik. Beispielsweise könnte man anstelle der arabischen Zahlenschrift auch die römische Zahlenschrift verwenden. Die konkrete Wahl der Symbole ist mathematisch nicht von Bedeutung. Deshalb ist es sinnvoll, von den natürlichen Zahlen zu sprechen.
(b) Die aus der Schule bekannten Rechenregeln in den natürlichen Zahlen (zum Beispiel das Distributivgesetz) lassen sich allein durch logische Folgerungen aus den Peano-Axiomen beweisen. Diese Beweise werden zum Beispiel in dem Buch [4] geführt, welches im Jahr 1930 erschien. Im Vorwort dieses Buchs schreibt der Autor Edmund Landau unter anderem:
- „Ich setze nur logisches Denken und die deutsche Sprache als bekannt voraus; nichts aus der Schulmathematik oder gar der höheren Mathematik.“
- „Bitte vergiß alles, was Du auf der Schule gelernt hast; denn Du hast es nicht gelernt.“
Wir werden diese (recht umfangreichen) Beweise hier nicht führen. Besonders interessierten Lesenden empfehlen wir in diesem Zusammenhang die entsprechenden Teile in den Büchern [4, 2, 3] zu studieren.

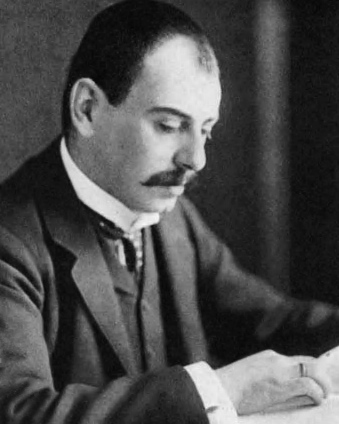
[picture p39: figure]

Abbildung 2.3: Edmund Landau (1877-1938)

# Kapitel 3

# Das Induktionsprinzip

Axiom 2.5 wird Prinzip der vollständigen Induktion genannt. Dieses Kapitel wird sich mit diesem wichtigen Prinzip befassen. Sie werden sehen, welche enorm weitreichenden Konsequenzen das Axiom 2.5 (Induktionsaxiom) der natürlichen Zahlen hat. Die Notation dieses Kapitels sowie einige Beweise stammen aus Kapitel 5 in [3].

## 3.1 Einführende Beispiele

### 3.1.1 Teilbarkeit durch 2

Ihre gute Freundin Anika behauptet, eine mathematische Entdeckung gemacht zu haben. Sie hat nämlich bemerkt, dass, wenn zu dem Quadrat n
2

einer natürlichen Zahl n die Zahl n addiert wird, die entstandene Summe stets gerade ist. Sie behauptet also, dass für jede natürliche Zahl n die Zahl

n

2 + n gerade ist.
EDIT Aufgabe 3.1
Anika hat in der Vergangenheit schon öfters mathematische Behauptungen aufgestellt. Nicht selten haben sich diese bei genauerer Untersuchung als falsch erwiesen. Bevor Sie also viel Zeit in die genauere Analyse Anikas neuer Behauptung investieren, möchten Sie eine kurze „Plausibilitätsprüfung“ durchführen. Schreiben Sie dazu ein Python-Programm, welches für die ersten 100 natürlichen Zahlen n ∈ { m ∈ N ; 0 ≤ m < 100 } überprüft, ob n

2 + n jeweils
gerade ist.

Das folgende Beispiel zeigt in aller Ausführlichkeit, wie das Prinzip der vollständigen Induktion verwendet werden kann, um eine mathematische Vermutung zu beweisen.

Beispiel 3.1:
Wir betrachten erneut die Vermutung Ihrer Freundin Anika:
Für jedes n ∈ N ist die Zahl n

2 + n gerade.
Wie lässt sich eine solche Vermutung überprüfen? Sicherlich können wir die Vermutung für einige natürliche Zahlen „von Hand“ durch simples „Nachrechnen“ überprüfen. In Aufgabe 3.1 haben Sie die Vermutung mit einem Computerprogramm für die ersten 100 natürlichen Zahlen überprüft. Das Problem ist jedoch, dass wir (selbst unter Verwendung von Supercomputern) immer nur endlich viele Zahlen überprüfen können. Wenn wir die Vermutung für 100 Milliarden Zahlen geprüft haben, bleiben immer noch unendlich viele Zahlen, die wir noch nicht betrachtet haben. Was wir benötigen, ist ein mathematisches Argument, welches grundsätzlich erklärt, warum die Vermutung stimmen muss. Ein solches mathematisches Argument liefert uns das Prinzip der vollständigen Induktion. Um dieses direkt anwenden zu können, definieren wir die „Hilfsmenge“

N :=
n ∈ N ; n

2 + n ist gerade
Die so definierte Menge N enthält genau die natürlichen Zahlen, für welche die Zahl n
2 + n
gerade ist, für welche also die Vermutung gilt. Somit ist die Vermutung bewiesen, wenn wir nachweisen können, dass alle natürlichen Zahlen in N liegen, dass also die Gleichheit N = N gilt. Es gilt somit:
(für jedes n ∈ N ist die Zahl n

2 + n gerade) ⇐⇒ (N = N).
Nun besagt das Prinzip der vollständigen Induktion (Axiom 2.5), dass für eine Teilmenge N ⊆ N tatsächlich N = N gilt, falls zwei Bedingungen erfüllt sind:
1. 0 ∈ N,
2. ist n ∈ N, dann enthält N auch den Nachfolger ν(n) = n + 1.
Wir prüfen diese beiden Bedingungen separat:
1. In der Tat gilt 0 ∈ N, denn 0

2 + 0 = 0 und 0 ist gerade. X
2. Sei n ∈ N und somit n

2 + n eine gerade Zahl. Wir müssen beweisen, dass auch ν(n) = (n+ 1) ∈ N gilt, dass also auch (n+ 1)² + (n+ 1) eine gerade Zahl ist. Dazu betrachten wir die folgende Berechnung:

(n + 1)² + (n + 1) = n

2 + 2n + 1 + (n + 1) = n | 2 + 3n + 2 =

n

2 + n + (2n + 2) = n

2 + n + 2(n + 1).
Betrachten wir den Ausdruck n

2 + n+2(n+1). Wir wissen, dass die Zahl n

2 + n gerade
ist (da n in der Menge N liegt). Die Zahl 2(n + 1) ist offensichtlich ebenfalls gerade. Somit ist (n + 1)² + (n + 1) als Summe zweier gerader Zahlen ebenfalls gerade. (Da die Zahl n

2 + n gerade ist, existiert eine natürliche Zahl k, sodass n

| 2 + n = 2k. Dann ist
die Summe (n + 1)² + (n + 1) = 2k + 2(n + 1) = 2(k + n + 1) das Doppelte der Zahl k + n + 1 und somit gerade). X
Damit sind die Bedingungen des Prinzips der vollständigen Induktion erfüllt und die Gleichheit N = N (und dadurch die ursprüngliche Vermutung Anikas) bewiesen.

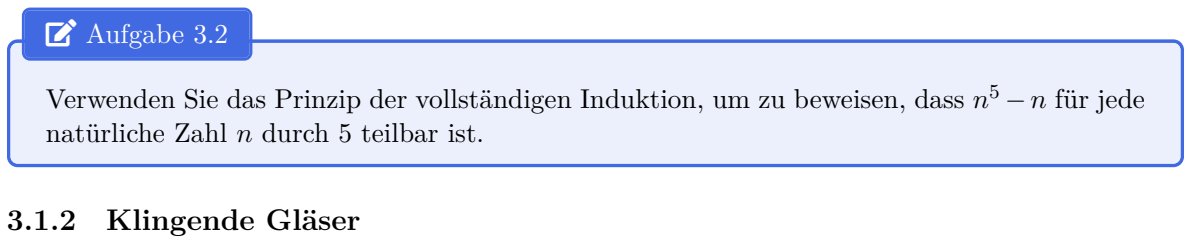
[picture p40: figure]
EDIT Aufgabe 3.2; 5 −n für jede; natürliche Zahl n durch 5 teilbar ist.; 3.1.2 Klingende Gläser

Verwenden Sie das Prinzip der vollständigen Induktion, um zu beweisen, dass n

In dem Gasthaus Inn of the Prancing Pony stossen n Gäste auf das neue Jahr an. Jede Person stösst mit jeder anderen (nicht mit sich selbst) genau einmal an. Wie viele Male klingen die Gläser (wie viele Male wird angestossen)? Die folgende elegante Überlegung gibt uns eine Formel, um die gesuchte Zahl rasch zu berechnen. Jede der n Personen stösst offensichtlich mit genau (n − 1) Personen an (mit allen anderen). Damit klingen die Gläser also n(n − 1)-mal. Die Formel ist so aber noch nicht richtig, denn wir haben jedes Klingen doppelt gezählt (anstatt nur einfach). Stösst nämlich Person A mit Person B an, dann haben wir dieses Anstossen einmal aus Sicht von A gezählt und noch einmal aus Sicht von B. Somit müssen wir die gesuchte Zahl n(n − 1) noch durch den Faktor 2 teilen. Die gesuchte Zahl ist also n(n − 1)/2.

Beispiel 3.2:
Diese Formel wollen wir nun mithilfe des Prinzips der vollständigen Induktion überprüfen. Dazu definieren wir, wie bereits in Beispiel 3.1, die Behauptung in geeigneter Form. Für jedes n ∈ N definieren wir also die Aussage A(n) als:

A(n) : ⇐⇒
Stossen n Personen (alle mit allen) an, klingen die Gläser genau n(n − 1)
2

Male.

Um das Prinzip der vollständigen Induktion direkt anwenden zu können, definieren wir erneut eine „Hilfsmenge“ N der Form

N := { n ∈ N ; A(n) ist wahr } .
Somit ist die Vermutung bewiesen, wenn wir nachweisen können, dass alle natürlichen Zahlen in N liegen, dass also die Gleichheit N = N gilt. Erneut prüfen wir die beiden Bedingungen des Induktionsaxioms separat:
1. Die behauptete Formel besagt, dass n = 0 Personen genau 0·(0−1) = 0-mal anstossen. Diese ist offensichtlich korrekt und somit haben wir 0 ∈ N begründet. X
2. Sei n ∈ N und somit A(n) wahr. Wir müssen beweisen, dass auch ν(n) = (n + 1) ∈ N gilt, dass also bei (n + 1) Personen genau (n + 1)n/2 Male die Gläser klingen.
Dazu stellen wir uns vor, dass erst n Personen im Restaurant sind und diese bereits alle miteinander angestossen haben. Da A(n) wahr ist, wissen wir also, dass die Gläser bereits genau n(n − 1)/2 Male klangen. Nun kommt eine weitere Person hinzu. Diese Person stösst mit allen n bereits Anwesenden an. Damit klingen die Gläser genau n weitere Male und insgesamt also

n(n − 1)
2

+ n =

n(n − 1) + 2n
2

=

n(n − 1 + 2)
2

=

(n + 1)n
2
Male. X
Somit ist die intuitiv gefundene Formel formal mithilfe des Prinzips der vollständigen Induktion nachgewiesen.

## 3.2 Erklimmen einer Leiter

In Beispiel 3.1 und dem Beweis von Theorem 3.1 haben wir das Prinzip der vollständigen Induktion als Beweistechnik verwendet. Dabei haben wir jeweils auf geschickte Weise eine „Hilfsmenge“ N definiert und gezeigt, dass N die Menge aller natürlichen Zahlen N ist. Nun möchten wir aber mathematische Aussagen beweisen und nicht unbedingt über Mengen sprechen. Deshalb ist es intuitiv einfacher, im Beweisverfahren der vollständigen Induktion den Begriff der Menge durch den Begriff der Aussage zu ersetzen. Um dies konkreter zu machen, betrachten wir nochmals Beispiel 3.1. In dem Beispiel kann man für jedes n ∈ N die Aussage A(n) definieren als
A(n) : ⇐⇒ Die Zahl n

2 + n ist gerade.
In der Sprache der Aussagen erhalten wir das folgende rezeptartige Beweisverfahren:

Zusammenfassung 3.1 (Beweis durch vollständige Induktion):
Für jedes n ∈ N sei A(n) eine Aussage. Wir wollen beweisen, dass A(n) für jedes n ∈ N richtig ist. Der Beweis kann mithilfe des Prinzips der vollständigen Induktion erbracht werden, indem wie folgt vorgegangen wird:
(a) Induktionsanfang: Es wird gezeigt, dass A(0) richtig ist.
(b) Induktionsschluss: Dieser besteht aus zwei Teilen:
(i) Induktionsvoraussetzung: Es sei n eine natürliche Zahl und A(n) sei richtig. (ii) Induktionsschritt (n → n + 1): Man zeigt, dass aus der Induktionsvoraussetzung (i), logischen Schlüssen und bereits als wahr erkannten Aussagen die Richtigkeit von A(n + 1) abgeleitet werden kann.
Damit ist die Richtigkeit von A(n) für alle n ∈ N gezeigt.

Beachten Sie, dass das Prinzip der vollständigen Induktion dem Axiom 2.5 entspricht und als solches nicht bewiesen werden kann. Was wir aber anbieten können, ist eine Metapher, welche das Prinzip veranschaulicht:

Bemerkung 3.1 (Metapher der Leiter):
Die vollständige Induktion beweist, dass wir auf einer Leiter beliebig weit hochsteigen können, indem sie beweist, dass wir den untersten Tritt (Induktionsanfang) erreichen können und, dass wir von jedem Tritt den nächsthöheren Tritt erreichen können (Induktionsschluss).

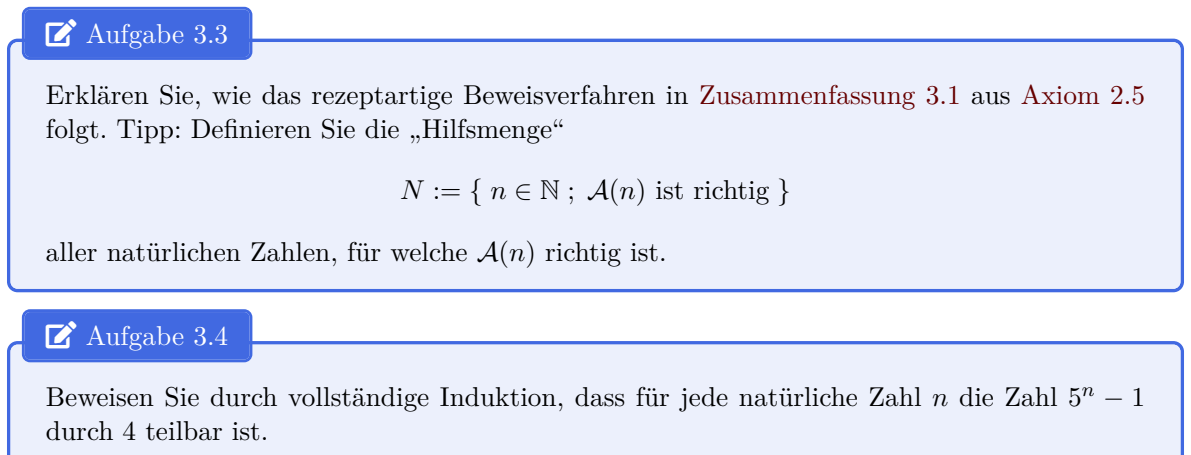
[picture p41: figure]
EDIT Aufgabe 3.3; N := { n ∈ N ; A(n) ist richtig }; EDIT Aufgabe 3.4; durch 4 teilbar ist.

Erklären Sie, wie das rezeptartige Beweisverfahren in Zusammenfassung 3.1 aus Axiom 2.5 folgt. Tipp: Definieren Sie die „Hilfsmenge“

aller natürlichen Zahlen, für welche A(n) richtig ist.

Beweisen Sie durch vollständige Induktion, dass für jede natürliche Zahl n die Zahl 5

## 3.3 Zwei bedeutende Sätze über natürliche Zahlen

Das Prinzip der vollständigen Induktion ist in der Mathematik und Informatik von enormer Bedeutung. Wir wollen in diesem anspruchsvollen Abschnitt noch mehr verdeutlichen, wie weitreichend die Beweiskraft dieses Prinzips ist. Dazu möchten wir zwei bedeutende Sätze der Mathematik besprechen und zeigen, wie diese aus dem Prinzip der vollständigen Induktion folgen.

### 3.3.1 Wohlordnungsprinzip

Beachten Sie, dass die Menge der ganzen Zahlen Z kein Minimum (kleinstes Element) besitzt. Zu jeder ganzen Zahl m ist offensichtlich m − 1 ebenfalls eine ganze Zahl, die (noch) kleiner ist als m. Die Teilmenge {−3, −1, 0, 7} von Z hingegen besitzt −3 als Minimum.

Definition 3.1 (Minimum):
Es sei A eine nichtleere Menge, in der sich Elemente durch die Relation ≤ vergleichen lassen.

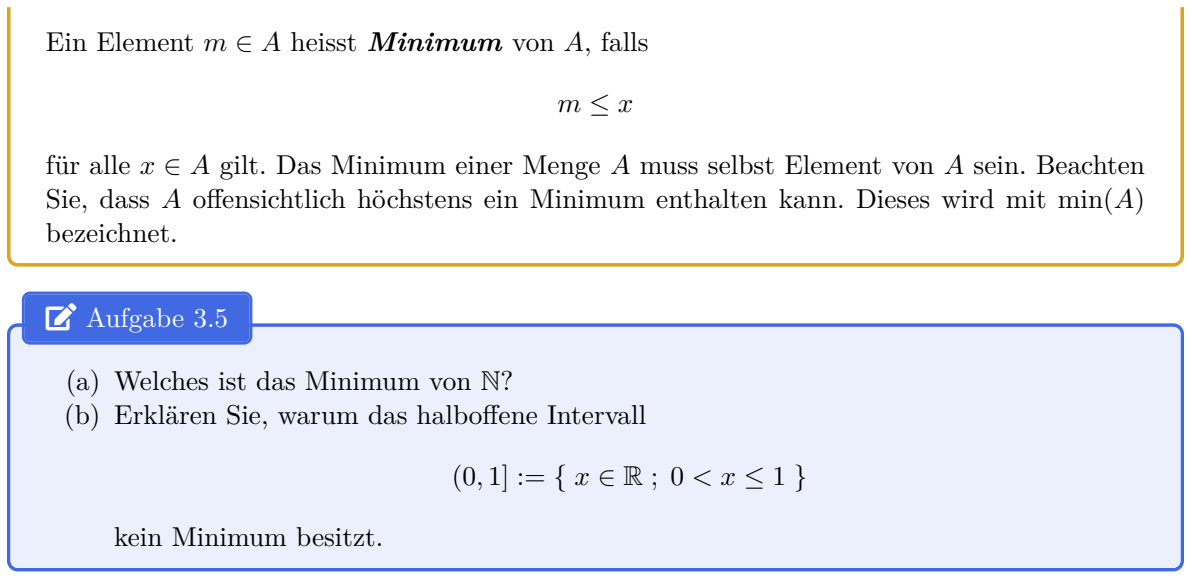
[picture p42: figure]
bezeichnet.; EDIT Aufgabe 3.5; (a) Welches ist das Minimum von N?; kein Minimum besitzt.

Ein Element m ∈ A heisst Minimum von A, falls

für alle x ∈ A gilt. Das Minimum einer Menge A muss selbst Element von A sein. Beachten Sie, dass A offensichtlich höchstens ein Minimum enthalten kann. Dieses wird mit min(A)

(b) Erklären Sie, warum das halboffene Intervall

Wir haben gesehen, dass durchaus nicht jede Menge ein Minimum besitzt. Das sogenannte Wohlordnungsprinzip der natürlichen Zahlen garantiert uns aber, dass jede Teilmenge von N, welche nicht die leere Menge ist, ein Minimum besitzt. Die leere Menge besitzt keine Elemente und somit offensichtlich auch kein minimales Element. Weshalb ist das Wohlordnungsprinzip für uns interessant? Dieses Prinzip kommt in den Beweisen einiger wichtiger mathematischer Behauptungen zum Einsatz, so zum Beispiel in unserem Beweis des berühmten Fundamentalsatzes der Arithmetik, den wir in Unterabschnitt 3.3.2 besprechen.

Definition 3.2 (untere Schranke):
Seien D eine Menge und A ⊆ D eine nichtleere Teilmenge von D. Jedes Element s ∈ D, welches s ≤ a für alle a ∈ A erfüllt, heisst untere Schranke von A. Eine untere Schranke von A muss selbst nicht ein Element von A sein.

Wir erkennen nun: Ein Element m ∈ R heisst Minimum von A ∈ R, falls m eine untere Schranke von A ist und zusätzlich m ∈ A gilt.

Beispiel 3.3: (a) Die Zahlen −5, 0, 3, 4 sind Beispiele von unteren Schranken der Menge
A := {4, 7, 9, 18}. Da 4 ∈ A und 4 eine untere Schranke von A ist, gilt
min(A) = 4.
(b) Die Menge Z der ganzen Zahlen besitzt keine untere Schranke.

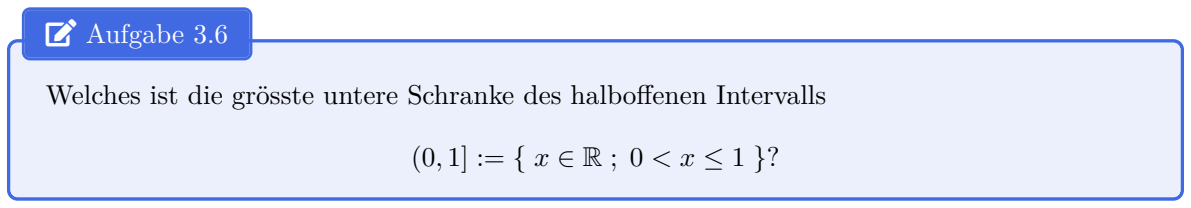
[picture p43: figure]
EDIT Aufgabe 3.6

Welches ist die grösste untere Schranke des halboffenen Intervalls

EDIT Aufgabe 3.7
(a) Sei A ⊆ N eine Teilmenge der natürlichen Zahlen. Angenommen n ∈ N sei eine untere Schranke von A, wobei aber n selbst nicht Element der Menge A ist (n ist also nicht das Minimum von A). Begründen Sie, warum auch der Nachfolger n + 1 eine untere Schranke von A ist.
(b) Sei A ⊆ N eine Teilmenge der natürlichen Zahlen mit der Eigenschaft, dass jede natürliche Zahl eine untere Schranke von A ist. Beweisen Sie, dass A die leere Menge ist. Tipp: Nehmen Sie an, A sei nichtleer. Dann enthält A also (zumindest) ein Element m ∈ A. Betrachten Sie nun die natürliche Zahl m + 1.
Wir verwenden nun das Prinzip der vollständigen Induktion, um das Wohlordnungsprinzip zu beweisen. Wir haben den Beweis dieses Satzes inzwischen recht gut vorbereitet. Dennoch ist der Beweis recht anspruchsvoll! Nehmen Sie sich Zeit, um die einzelnen Schritte zu studieren.

Theorem 3.1 (Wohlordnungsprinzip):
Jede nichtleere Teilmenge der natürlichen Zahlen besitzt ein Minimum.

Beweis 3.1:
Wir beweisen den Satz durch Widerspruch. Angenommen eine Teilmenge A ⊆ N sei nichtleer und besitze kein Minimum. Dann definieren wir zu A die „Hilfsmenge“
N := { n ∈ N ; n ist untere Schranke von A } aller unteren Schranken von A. Mit dem Prinzip der vollständigen Induktion beweisen wir, dass jede natürliche Zahl eine untere Schranke von A ist, dass also N = N gilt. In Aufgabe 3.6 haben Sie bereits bewiesen, dass dies nur möglich ist, falls A die leere Menge ist. Um N = N durch die vollständige Induktion zu beweisen, müssen wir, wie immer, zwei Bedingungen prüfen:
1. 0 ∈ N,
2. Ist n ∈ N, dann enthält N auch den Nachfolger ν(n) = n + 1 von n. (Ist n eine untere Schranke von A, dann ist auch n + 1 eine untere Schranke von A.)
Wir prüfen diese beiden Bedingungen separat:
1. 0 ist die kleinste Zahl in N und somit gilt 0 ≤ a für jedes Element a ∈ A. Damit ist 0 eine untere Schranke von A und wir haben 0 ∈ N gezeigt. X
2. Es sei n ∈ N und somit n eine untere Schranke von A. Beachten Sie, dass n nicht in A liegt, denn sonst würde die Menge A die Zahl n als ihr Minimum besitzen (doch A besitzt gemäss Annahme kein Minimum). Damit ist n ∈ N eine untere Schranke von A, wobei aber n selbst nicht Element der Menge A ist. In Aufgabe 3.7 haben Sie gezeigt, dass dann auch n + 1 eine untere Schranke von A und somit ein Element von N ist. X
Aus dem Prinzip der vollständigen Induktion folgt nun, dass N = N gilt. Also ist jede natürliche Zahl eine untere Schranke von A. Somit ist A ⊆ N eine Teilmenge der natürlichen Zahlen mit der Eigenschaft, dass jede natürliche Zahl eine untere Schranke von A ist. In Aufgabe 3.7 haben Sie gezeigt, dass A somit die leere Menge ist. Damit haben wir den gewünschten Widerspruch A 6= ∅ und A = ∅ gefunden. Somit besitzt jede nichtleere Teilmenge von N ein Minimum.

### 3.3.2 Fundamentalsatz der Arithmetik

Die Tatsache, dass jede Teilmenge der natürlichen Zahlen ein Minimum besitzt, erlaubt uns, den berühmten Fundamentalsatz der Arithmetik zu beweisen.

Theorem 3.2:
Fundamentalsatz der Arithmetik (Primfaktorzerlegung) Ausser 0 und 1 kann jede natürliche Zahl als Produkt endlich vieler Primzahlen dargestellt werden. Diese Darstellung ist bis auf die Reihenfolge der Faktoren eindeutig und wird Primfaktorzerlegung genannt. Erlaubt sind auch Produkte, die nur aus einem Faktor bestehen.

Beispiel 3.4: (a) Die Zahl 63 besitzt die Primfaktorzerlegung 63 = 3 · 3 · 7 und die Zahl 286 die Darstellung 286 = 2 · 11 · 13.
(b) Die Primfaktorzerlegung der Primzahl 19 ist 19 selbst. Sie besteht also aus dem Produkt mit nur dem einen Faktor 19. Jede Primzahl p ist also bereits in Primfaktoren zerlegt.

Beweis 3.2:
Wir wollen nun den Fundamentalsatz (Theorem 3.2) beweisen. Dies tun wir unter der Verwendung des Wohlordnungsprinzips. Allerdings zeigen wir nur, dass immer eine Zerlegung in Primfaktoren existiert. Auf den Beweis der Eindeutigkeit verzichten wir an dieser Stelle. Angenommen die Behauptung sei falsch. Dann gibt es eine natürliche Zahl ≥ 2, welche keine Primfaktorzerlegung besitzt. Mit anderen Worten: Die Menge
A := { n ∈ N ; n ≥ 2 und n besitzt keine Primfaktorzerlegung } ist nichtleer. Dann liegt in A aber gemäss Theorem 3.1 eine kleinste Zahl n0 ≥ 2, welche nicht in Primfaktoren zerlegt werden kann. Insbesondere ist n0 keine Primzahl. Da n0 keine Primzahl ist, existieren natürliche Zahlen n und m, sodass n0 = n · m und n, m > 1. Es ist klar, dass die Faktoren n und m jeweils kleiner als das Produkt n0 sind. Da aber n0 die kleinste natürliche Zahl ist, welche keine Primfaktorzerlegung besitzt, können sowohl n als auch m jeweils als Produkt endlich vieler Primzahlen geschrieben werden. Dann ist aber auch n0 als Produkt von n und m ein Produkt endlich vieler Primzahlen. Dieses Produkt wäre dann aber eine Primfaktorzerlegung von n0. Das ist ein Widerspruch.

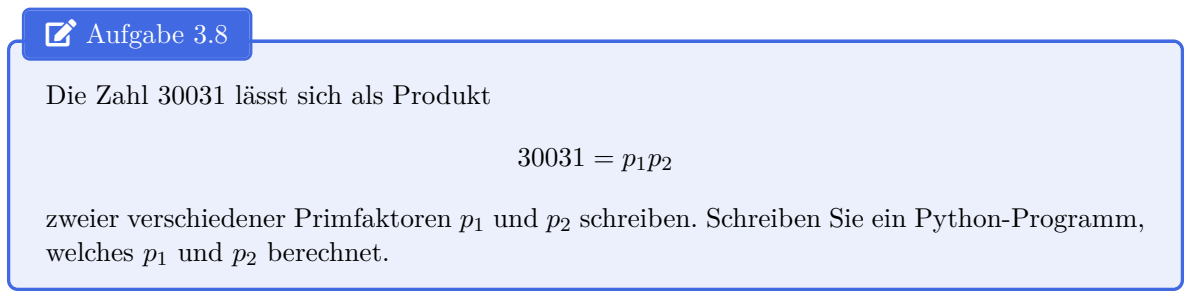
[picture p44: figure]
EDIT Aufgabe 3.8; Die Zahl 30031 lässt sich als Produkt; welches p1 und p2 berechnet.

zweier verschiedener Primfaktoren p1 und p2 schreiben. Schreiben Sie ein Python-Programm,

EDIT Aufgabe 3.9
Der griechische Mathematiker Euklid von Alexandria bewies bereits im 3. Jahrhundert v. Chr., dass unendlich viele Primzahlen existieren. Dazu nahm er (indirekter Beweis) an, die Menge P aller Primzahlen sei endlich. Wir können P also schreiben als

P = {p1, p2, p3, . . . , pn} .
Nun betrachtete Euklid das Produkt dieser n Primzahlen und addierte dazu 1:

m := p1 · p2 · p3 · . . . · pn + 1.
Betrachten Sie die so entstandene Zahl m. Welche Eigenschaften hat m gemäss unseren Annahmen? Vervollständigen Sie den Beweis.

Bemerkung 3.2:
Beachten Sie, dass das Vorgehen in Aufgabe 3.9 in keinster Weise ein Rezept zur Konstruktion von Primzahlen liefert. Beispielsweise gilt

2 · 3 · 5 · 7 · 11 · 13 + 1 = 30031,
doch Sie haben in Aufgabe 3.8 bereits gezeigt, dass 30031 keine Primzahl ist.

## 3.4 Leicht verallgemeinertes Induktionsprinzip

Wie Sie sofort nachprüfen können, ist die mathematische Aussage n

2−2n−1 > 0 für die natürlichen Zahlen n = 0, 1, 2 falsch. Nun möchten Sie aber beweisen, dass die Aussage für alle n ∈ N mit n ≥ 3 gilt. Unser Beweisverfahren in Zusammenfassung 3.1 muss also dahingehend angepasst werden, dass es uns auch erlaubt, den Induktionsanfang bei einer beliebigen Zahl n0 ∈ N anzusetzen, wobei n0 auch grösser als 0 sein darf. Diese sehr geringfügige (aber wichtige) Verallgemeinerung fassen wir in dem folgenden Satz zusammen:

Theorem 3.3 ((leicht verallgemeinertes) Induktionsprinzip):
Sei n0 ∈ N und für jedes n ∈ N mit n ≥ n0 sei A(n) eine Aussage. Zudem gelte:
(i) A (n0) ist richtig.
(ii) Für jede Zahl n ∈ N mit n ≥ n0 folgt aus der Richtigkeit von A(n) die Richtigkeit von
A(n + 1).
Dann ist A(n) für jedes n ≥ n0 richtig.

Beweis 3.3:
Der Beweis ist fast komplett analog zu der Begründung in Aufgabe 3.3. Der einzige Unterschied besteht darin, dass wir einen Index „verschieben“ müssen. Intuitiv gesprochen, möchten wir, dass wir immer noch bei 0 beginnen, anstelle von A(0) aber bereits A (n0) betrachten. Wir definieren also die Menge N der um „n0 verschobenen Aussagen“
N := { n ∈ N ; A (n + n0) ist richtig } . Beachten Sie, dass für n = 0 dadurch bereits die Aussage A (0 + n0) = A (n0) gemeint ist. Mit dem Induktionsaxiom 2.5 folgt sofort N = N und somit ist A(n) für jedes n ≥ n0 richtig.

Bemerkung 3.3:
Wir werden das leicht verallgemeinerte Induktionsprinzip von Theorem 3.3 ebenfalls einfach nur Induktionsprinzip nennen.

## 3.5 Übungsaufgaben zum Induktionsprinzip

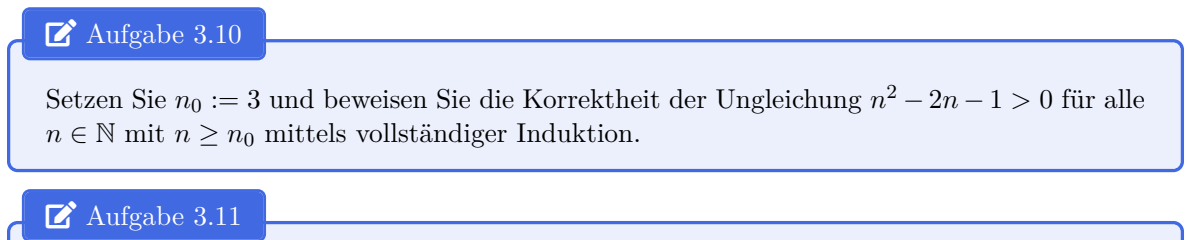
[picture p45: figure]
EDIT Aufgabe 3.10; 2 − 2n − 1 > 0 für alle; EDIT Aufgabe 3.11

Setzen Sie n0 := 3 und beweisen Sie die Korrektheit der Ungleichung n n ∈ N mit n ≥ n0 mittels vollständiger Induktion.

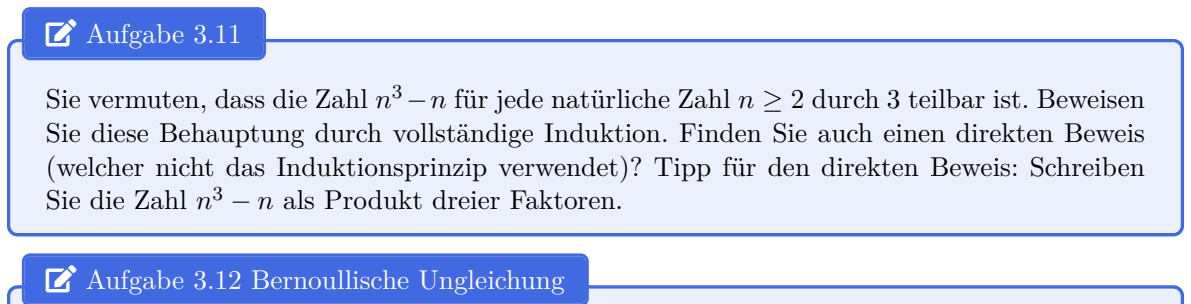
[picture p46: figure]
Sie vermuten, dass die Zahl n; Sie die Zahl n; 3 − n als Produkt dreier Faktoren.; EDIT Aufgabe 3.12 Bernoullische Ungleichung

3−n für jede natürliche Zahl n ≥ 2 durch 3 teilbar ist. Beweisen Sie diese Behauptung durch vollständige Induktion. Finden Sie auch einen direkten Beweis (welcher nicht das Induktionsprinzip verwendet)? Tipp für den direkten Beweis: Schreiben

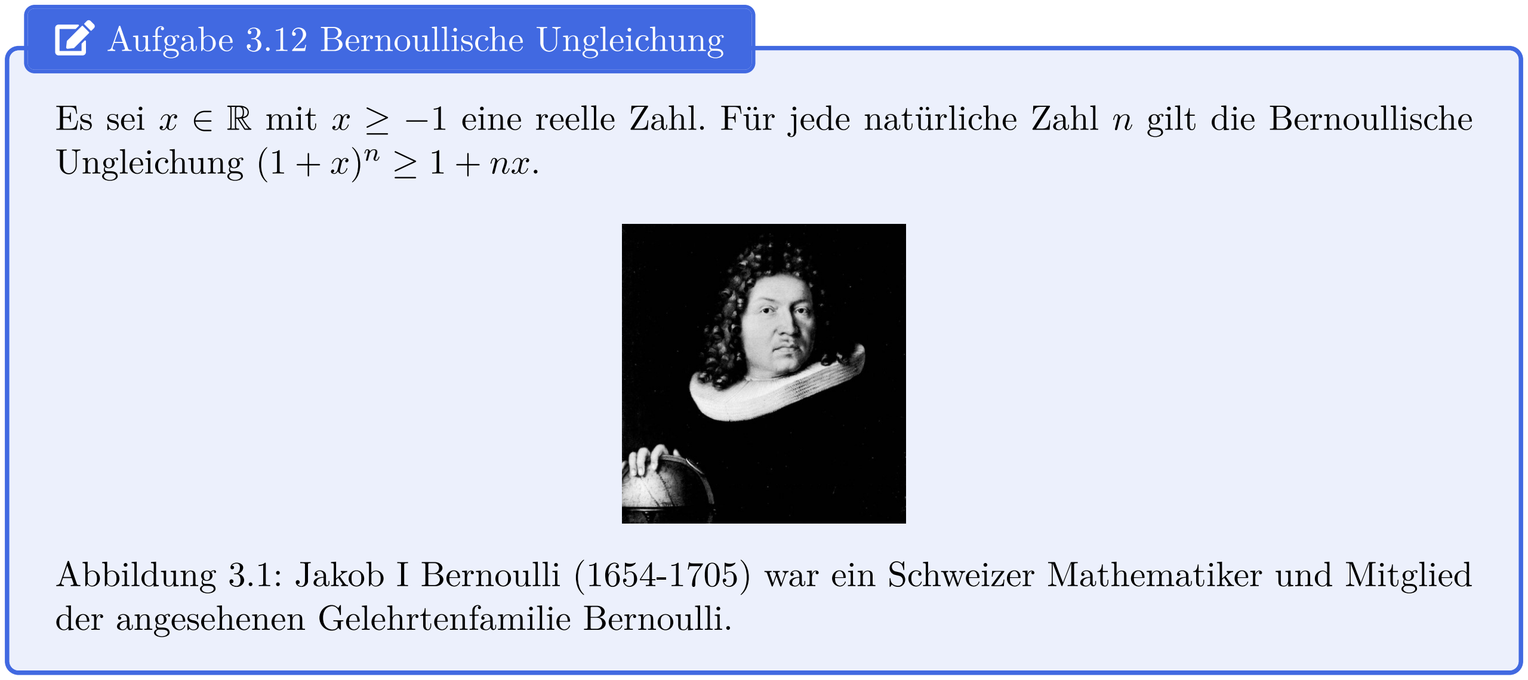
[picture p47: figure]
Ungleichung (1 + x); der angesehenen Gelehrtenfamilie Bernoulli.

Es sei x ∈ R mit x ≥ −1 eine reelle Zahl. Für jede natürliche Zahl n gilt die Bernoullische

Abbildung 3.1: Jakob I Bernoulli (1654-1705) war ein Schweizer Mathematiker und Mitglied

EDIT Aufgabe 3.13
In die Ebene wurden n ∈ N verschiedene Geraden gelegt. Die Geraden teilen die Ebene in verschiedene Bereiche. Wir sagen, dass zwei Bereiche benachbart sind, falls sie sich eine (möglicherweise unendlich lange) Grenzlinie teilen. Falls zwei Bereiche lediglich einen Grenzpunkt teilen (keine Grenzlinie), sind sie nicht benachbart.
Wir haben zwei Farben zur Verfügung und müssen jeden Bereich mit genau einer dieser Farben einfärben. Eine Färbung wird zulässig genannt, falls zusätzlich keine zwei benachbarten Bereiche mit derselben Farbe gefärbt wurden. In Abbildung 3.2 ist eine mögliche zulässige Färbung für zwei Geraden (n = 2) gezeigt.
Skizzieren Sie eine zulässige Färbung für n = 3 für den Fall, dass sich alle drei Geraden jeweils gegenseitig schneiden. Beweisen Sie anschliessend durch vollständige Induktion, dass es immer möglich ist, die verschiedenen Bereiche mit nur zwei Farben so zu färben, dass keine zwei benachbarten Bereiche von derselben Farbe sind.

g1

g2

(a) zwei sich schneidende Geraden

g1

g2

(b) zulässige Färbung für n = 2 Abbildung 3.2: Beispiel einer zulässigen Färbung für n = 2. Beachten Sie, dass die beiden goldenen Bereiche sich nur einen Grenzpunkt (keine Grenzlinie) teilen und somit nicht benachbart sind. Das Gleiche gilt für die beiden blauen Bereiche. Zwei sich schneidende Geraden teilen die Ebene in vier Bereiche ein. Zwei parallele Geraden teilen die Ebene in drei Bereiche ein.

EDIT Aufgabe 3.14
Die Idee für das folgende scheinbare Paradoxon wird häufig dem ungarischen Mathematiker George Pólya zugeschrieben. Pólya war von 1914 bis 1940 Professor der Mathematik an der ETH Zürich. Das scheinbare Paradoxon besteht darin, dass vermeintlich korrekt bewiesen wird, dass alle Pferde dieselbe Farbe haben (alle Zahlen sind gleich / alle Mädchen haben dieselbe Augenfarbe).
Erklären Sie ganz präzise, an welcher Stelle / welchen Stellen die folgende Argumentation fehlerhaft ist.
Behauptung:
Wir verwenden Theorem 3.3 um zu beweisen, dass alle Pferde dieselbe Farbe haben. Dazu definieren wir für jedes n ∈ N

× die Aussage A(n) als
A(n) : ⇐⇒ In einer Menge von n Pferden haben alle dieselbe Farbe. Wir behaupten die Richtigkeit von A(n) für alle n ∈ N

×.
Beweis 3.4: (a) Induktionsanfang: A(1) ist richtig, denn in einer Menge mit nur einem Pferd haben offensichtlich alle Pferde dieselbe Farbe. Somit stimmt die Aussage für
n = 1.
(b) Induktionsschluss:
(i) Induktionsvoraussetzung: Es sei n ≥ 1 eine natürliche Zahl und A(n) sei richtig. Das heisst, in einer Menge von n Pferden haben alle dieselbe Farbe.
(ii) Induktionsschritt (n → n+1): Durch Hinzufügen eines weiteren (neuen) Pferdes

p

0

zu einer Menge von n Pferden erhalten wir eine Menge von n + 1 Pferden. Nun nehmen wir ein Pferd p˜, welches aber nicht p
0

ist (p˜ 6= p
0

), aus der Menge
heraus und erhalten dadurch wieder eine Menge von n Pferden. In dieser neuen Menge, die p
0

enthält, haben gemäss Induktionsvoraussetzung alle Pferde dieselbe Farbe. Damit hat aber das neue Pferd p

0 dieselbe Farbe wie die n anderen. Nun fügen wir das entfernte Pferd p˜ wieder zur Menge hinzu und erhalten eine Menge mit n + 1 Pferden, welche alle dieselbe Farbe haben. Dies zeigt den Induktionsschritt.
Damit ist die Richtigkeit von A(n) für alle n ∈ N

× gezeigt. Somit sind in jeder (beliebigen) endlichen Menge von Pferden nur Pferde derselben Farbe enthalten. Das geht aber nur, wenn tatsächlich alle Pferde dieselbe Farbe haben.

## 3.6 Starke Induktion

Das Induktionsprinzip (Theorem 3.3) verlangt, dass zum Nachweis der Richtigkeit von A(n + 1), nebst bereits bekanntem Wissen, lediglich die Richtigkeit von A(n) verwendet werden darf. Manchmal wäre es aber sehr nützlich, zum Nachweis von A(n+1) nebst A(n) zusätzlich noch die Aussagen A(k) mit k < n annehmen zu dürfen. Durch diese zusätzlichen Annahmen wird der Nachweis der Korrektheit von A(n + 1) entweder erleichtert oder bleibt genauso schwierig wie im bisherigen Induktionsschritt. Sicherlich wird der Nachweis dadurch nicht schwieriger. Man sagt dann, dass wir stärkere Annahmen treffen.

Theorem 3.4 (starke Induktion):
Sei n0 ∈ N und für jedes n ∈ N mit n ≥ n0 sei A(n) eine Aussage. Zudem gelte:
(i) A (n0) ist richtig.
(ii) Für jede Zahl n ∈ N mit n ≥ n0 gilt:
Aus der Richtigkeit der Aussagen A(k) für n0 ≤ k ≤ n folgt die Richtigkeit von A(n+1). Dann ist A(n) für jedes n ≥ n0 richtig.

Bemerkung 3.4:
Die starke Induktion besagt im Grunde, dass wir uns den Nachweis des Induktionsschritts (im Vergleich zu Theorem 3.3) durch zusätzliche (stärkere) Annahmen vereinfachen dürfen und trotzdem die komplette Aussagekraft von Theorem 3.3 behalten.

Beispiel 3.5:
Auf einer Auslandsreise sprechen wir mit anderen Touristen über Währungen verschiedener Länder. Der US-Amerikaner Doug kennt sich gut mit der Geschichte seines Landes aus und erzählt uns, dass für eine gewisse Zeit in den noch jungen vereinigten Staaten 4-Dollarmünzen und 5-Dollarmünzen geprägt wurden. Diese kunstvollen Münzen sind in Abbildung 3.3 gezeigt.

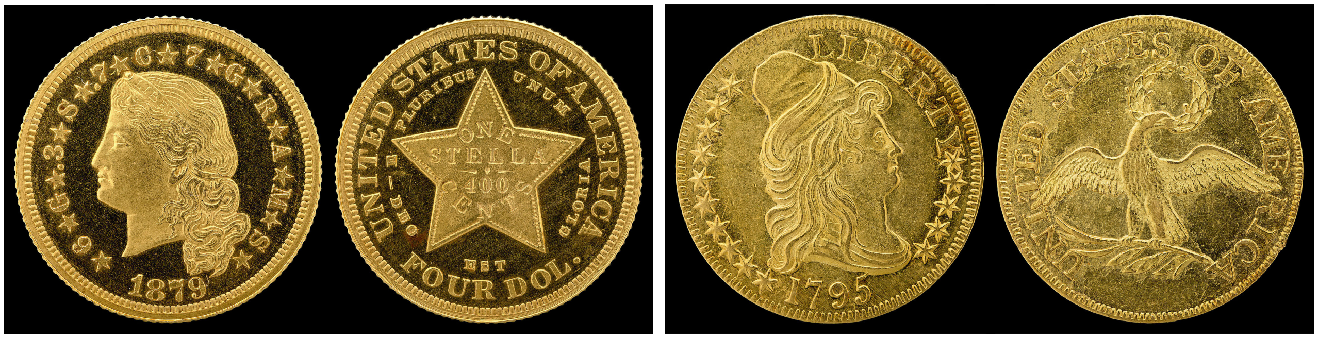
[picture p48: figure]

(a) 4-Dollarmünze „Stella“ | (b) 5-Dollarmünze „Half Eagle“
Abbildung 3.3: US-amerikanische 4-Dollar- und 5-Dollarmünze

Doug findet es schade, dass diese Münzen nicht mehr geprägt werden. Schliesslich liesse sich jeder ganzzahlige Dollar-Betrag, der grösser als 11 Dollar ist, alleine durch eine Kombination dieser beiden Münzen auszahle — dies natürlich nur unter der Annahme, dass beliebig viele Exemplare von beiden Münzen zur Verfügung stehen.
Als kritische Menschen sind wir nicht bereit, Doug einfach so zu glauben. Um Dougs Behauptung zu überprüfen, verwenden wir die starke Induktion (Theorem 3.4). Wir definieren für jedes n ∈ N die Aussage A(n) als

A(n) : ⇐⇒ „Der Dollar-Betrag n kann durch eine Kombination aus 4-Dollarmünzen und 5-Dollarmünzen ausbezahlt werden.“ Dougs Behauptung besagt also, dass A(n) für jedes n ∈ N mit n ≥ 12 gilt.
Der Betrag n0 = 12 kann wegen 12 = 3 · 4 + 0 · 5 durch drei 4er und null 5er ausbezahlt werden. Somit stimmt A(n0) = A(12). Zum Nachweis von A(n0 + 1) = A(13) dürften wir A(12) verwenden. Zum Nachweis von A(14) dürften wir A(12) und A(13) verwenden und zum Nachweis von A(15) gar A(12), A(13) und A(14). Wir sehen jedoch sofort, dass
13 = 2 · 4 + 1 · 5, | 14 = 1 · 4 + 2 · 5, | 15 = 0 · 4 + 3 · 5,
und somit sind nebst A(12) auch A(13), A(14) und A(15) nachgewiesen.
Sei nun n ∈ N mit n ≥ 15. Wir beweisen, dass aus der Richtigkeit von A(k) für 12 ≤ k ≤ n die Richtigkeit von A(n+ 1) folgt. Wir betrachten den Dollar-Betrag n+ 1−4. Offensichtlich gilt 12 ≤ n+ 1−4 ≤ n. Gemäss (starker) Induktionsannahme kann der Betrag n+ 1−4 aber durch eine Kombination aus 4-Dollarmünzen und 5-Dollarmünzen ausbezahlt werden. Dies ist die Aussage A(n+ 1−4) = A(n−3). Durch das Hinzufügen einer einzigen 4-Dollarmünze zu dieser Kombination erhalten wir eine gewünschte Auszahlung des Dollar-Betrags n + 1.

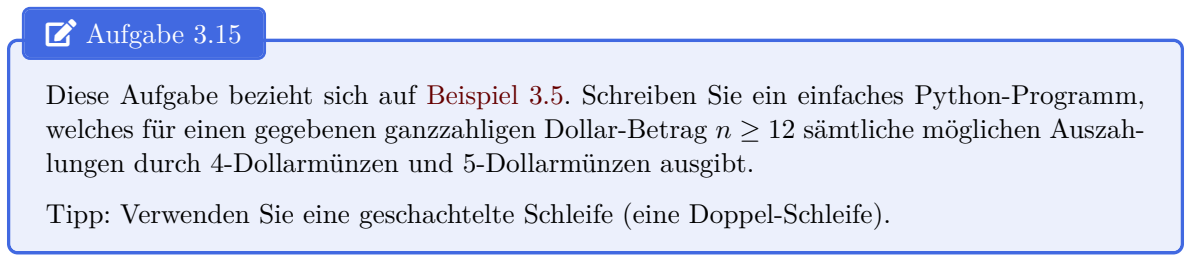
[picture p49: figure]
EDIT Aufgabe 3.15

Diese Aufgabe bezieht sich auf Beispiel 3.5. Schreiben Sie ein einfaches Python-Programm, welches für einen gegebenen ganzzahligen Dollar-Betrag n ≥ 12 sämtliche möglichen Auszahlungen durch 4-Dollarmünzen und 5-Dollarmünzen ausgibt.
Tipp: Verwenden Sie eine geschachtelte Schleife (eine Doppel-Schleife).

Wir sind noch einen Beweis von Theorem 3.4 schuldig:
Beweis 3.5:
Wir beweisen Theorem 3.4. Angenommen der Satz sei falsch und somit A(n) nicht jedes n ≥ n0 richtig. Dann ist die Menge
N := { n ∈ N ; n ≥ n0 und A(n) ist falsch } nichtleer. Gemäss Theorem 3.1 besitzt die Menge N ein minimales Element m. Da A(n0) wegen Bedingung (i) richtig ist, muss m > n0 gelten. Es existiert eine eindeutige natürliche Zahl n mit n + 1 = m. Aufgrund der Definition von m gilt, dass die Aussagen A(k) für alle natürlichen Zahlen k mit n0 ≤ k ≤ n richtig sind. Dann garantiert Bedingung (ii) aber die Richtigkeit von A(n + 1) = A(m). Doch dies ist nach der Definition von m unmöglich und wir haben einen Widerspruch gefunden.

EDIT Aufgabe 3.16
Der junge Tim besitzt beliebig viele Holzklötze der Länge 7 und beliebig viele der Länge 8. Klötze anderer Längen hat er keine.
(a) Tim weiss, dass sein Plüschkrokodil die Länge 38 hat. Nun möchte er mit seinen Klötzen eine Strecke derselben Länge bauen. Doch bislang blieben alle seine Versuche erfolglos. Helfen Sie Tim, indem Sie ein Python-Programm schreiben, welches Ihnen angibt, wie viele Klötze der Länge 7 und wie viele der Länge 8 benötigt werden, um die Strecke zu bauen.
(b) Weisen Sie nach, dass es mit Tims Klötzen nicht möglich ist, eine Strecke der Länge 41 zu bauen. Schreiben Sie dazu ein Python-Programm, welches alle denkbaren Möglichkeiten ausprobiert.
(c) Beweisen Sie mithilfe von Theorem 3.4 zur starken Induktion, dass jede Strecke der Länge n ∈ N mit n ≥ 42 mit Tims Klötzen gebaut werden kann.

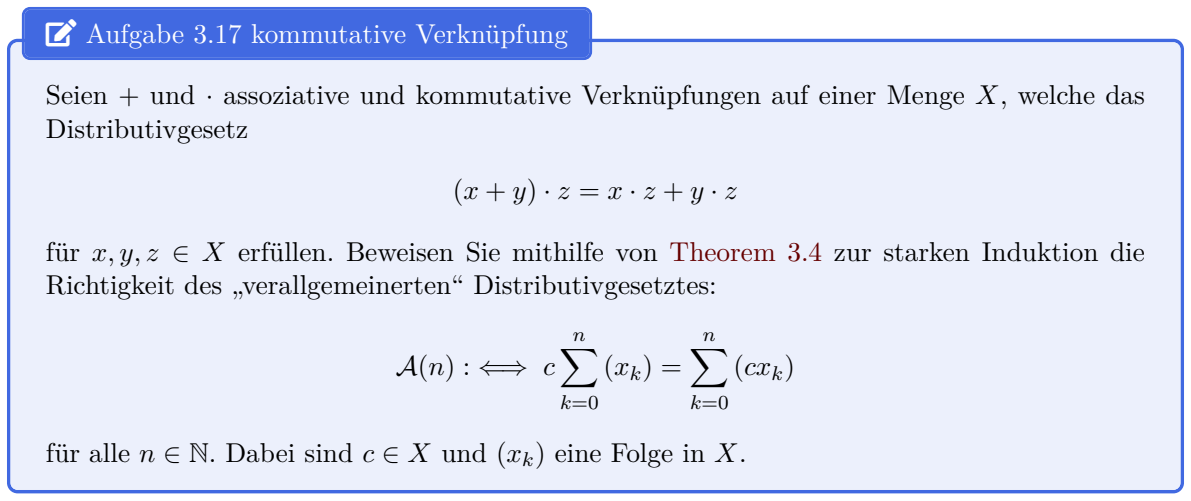
[picture p50: figure]
EDIT Aufgabe 3.17 kommutative Verknüpfung; Distributivgesetz; Richtigkeit des „verallgemeinerten“ Distributivgesetztes:; (cxk)

Seien + und · assoziative und kommutative Verknüpfungen auf einer Menge X, welche das

für x, y, z ∈ X erfüllen. Beweisen Sie mithilfe von Theorem 3.4 zur starken Induktion die

für alle n ∈ N. Dabei sind c ∈ X und (xk) eine Folge in X.

## 3.7 Lösungen der Aufgaben

Lösungsvorschlag zu Aufgabe 3.1 1 def vermutung(m):
2 | for n in range(m):
3 | if (n * n + n) % 2 != 0:
4 | return False
5 | return True

6
7 m = 100
8 print(vermutung(m))
| Programm 3.1: Vermutung überprüfen
| Lösungsvorschlag zu Aufgabe 3.2
Wir definieren die „Hilfsmenge“
| N := n ∈ N ; n

5 − n ist durch 5 teilbar
Die Behauptung der Aufgabe ist bewiesen, wenn wir nachweisen können, dass alle natürlichen Zahlen in N liegen, dass also die Gleichheit N = N gilt. Das Prinzip der vollständigen Induktion (Axiom 2.5) besagt, dass für eine Teilmenge N ⊆ N tatsächlich N = N gilt, falls zwei Bedingungen erfüllt sind:
1. 0 ∈ N,
2. ist n ∈ N, dann enthält N auch den Nachfolger ν(n) = n + 1.
Wir prüfen nun diese beiden Bedingungen.
1. In der Tat gilt 0 ∈ N, denn 0
| 5 − 0 = 0 ist durch 5 teilbar. X
2. Sei n ∈ N und somit n
| 5 − n durch 5 teilbar. Wir müssen beweisen, dass auch ν(n) = (n+ 1) ∈
| N gilt, dass also auch (n + 1)⁵ − (n + 1) durch 5 teilbar ist. Dazu betrachten wir die folgende
| Berechnung:
| (n + 1)⁵ − (n + 1) = n

5 + 5n

4 + 10n

3 + 10n

2 + 5n + 1 − n − 1 =
| n 5 − n

+ 5
n

4 + 2n

3 + 2n

2 + n
| Da n in der Menge N liegt, ist die Zahl n

5 − n durch 5 teilbar. Somit ist (n + 1)⁵ − (n + 1)
| als Summe zweier durch 5 teilbarer Zahlen ebenfalls durch 5 teilbar. X
| Lösungsvorschlag zu Aufgabe 3.3
Im Induktionsanfang (a) wird gezeigt, dass 0 ∈ N gilt. Der Induktionsschluss liefert schliesslich, dass für n ∈ N auch (n + 1) ∈ N gilt. Gemäss Axiom 2.5 gilt somit N = N. Dies bedeutet aber, dass A(n) in der Tat für alle n ∈ N gilt.

Lösungsvorschlag zu Aufgabe 3.4 Für jedes n ∈ N definieren wir die Aussage A(n) als
A(n) : ⇐⇒ Die Zahl 5

n − 1 durch 4 teilbar.
(a) Induktionsanfang: Wir zeigen, dass A(0) richtig ist. Dies ist aber klar, denn 5

0 − 1 = 0 und 0
ist durch 4 teilbar.
(b) Induktionsschluss:
(i) Induktionsvoraussetzung: Es sei n eine natürliche Zahl und A(n) sei richtig. Sei also 5
n−1
durch 4 teilbar.
(ii) Induktionsschritt (n → n + 1): Wir zeigen, dass aus der Induktionsvoraussetzung (i), logischen Schlüssen und bereits als wahr erkannten Aussagen die Richtigkeit von A(n+1) abgeleitet werden kann. Die Aussage A(n + 1) lautet: 5

n+1 − 1 ist durch 4 teilbar. Wir berechnen:

5

n+1 − 1 = 5 · 5

n − 1 = (4 + 1) · 5

n − 1 = 4 · 5

n + 5

n − 1.
Die Zahl 4 · 5
n

ist als Vielfaches von 4 offensichtlich durch 4 teilbar und 5

n − 1 ist gemäss
Induktionsvoraussetzung durch 4 teilbar. Somit haben wir gezeigt, dass 5

n+1 − 1 eine
Summe von Termen ist, welche jeweils durch 4 teilbar sind. Damit ist aber auch 5
n+1 −1
durch 4 teilbar und der Induktionsschritt ist bewiesen.
Aus dem Induktionsprinzip folgt somit, dass A(n) für jedes n ∈ N korrekt ist.
Lösungsvorschlag zu Aufgabe 3.5
(a) Die Zahl 0 ist das Minimum von N, da 0 ∈ N und 0 ≤ x für alle x ∈ N.
(b) Für jedes Element m ∈ (0, 1] ist auch die Hälfte m/2 von m Element des Intervalls. Dann gilt aber auch (m/2) ∈ (0, 1]. Anders gesagt: Angenommen m ∈ (0, 1] sei das Minimum des Intervalls. Dann gilt aber auch (m/2) ∈ (0, 1]. Wegen m/2 < m ist dies aber ein Widerspruch zur Minimalität von m.

Lösungsvorschlag zu Aufgabe 3.6 Das halboffene Intervall (0, 1] := { x ∈ R ; 0 < x ≤ 1 } besitzt die grösste untere Schranke 0, aber kein Minimum.
Lösungsvorschlag zu Aufgabe 3.7
(a) Da n eine untere Schranke von A ist, gilt n ≤ a für alle a ∈ A. Da aber n ∈/ A, ist klar, dass tatsächlich sogar n < a (echt kleiner) für alle a ∈ A gilt. Der Nachfolger (die nächstgrössere natürliche Zahl) von n ist n + 1. Damit ist klar, dass n + 1 höchstens so gross wie jedes der Elemente in A ist, dass also n + 1 ≤ a für alle a ∈ A gilt.
(b) Angenommen A wäre nichtleer. Dann enthält A mindestens ein Element m ∈ A. Die natürliche Zahl m + 1 ist grösser als m ∈ A und somit keine untere Schranke von A. Doch A besitzt die Eigenschaft, dass jede natürliche Zahl eine untere Schranke von A ist. Dies ist ein Widerspruch und somit muss A die leere Menge sein.
Lösungsvorschlag zu Aufgabe 3.8 1 n = 30031
2 for k in range(2,n):
3 | if (n % k == 0):
4 | p1 = k
5 | break
6 p2 = int(n / p1)
7 print(n,'=', p1, '*',p2)
Lösungsvorschlag zu Aufgabe 3.9 Da m ≥ 2 ist, lässt sich m gemäss Theorem 3.2 als Produkt von Primzahlen schreiben. Für jeden Primteiler p von m gilt p 6= pi für alle i = 1, 2, . . . , n. Es gibt also eine weitere Primzahl p ∈/ P. Dies ist ein Widerspruch zur Annahme, dass P alle Primzahlen enthält.

Lösungsvorschlag zu Aufgabe 3.9 Für jedes n ∈ N mit n ≥ n0 definieren wir die Aussage A(n) als

A(n) : ⇐⇒ n

2 − 2n − 1 > 0.
(a) Induktionsanfang: Wir zeigen, dass A(n0) richtig ist. Für n = 3 ist

n

2 − 2n − 1 = 9 − 6 − 1 = 2 > 0.
Somit stimmt die Aussage für n = 3.
(b) Induktionsschluss:
(i) Induktionsvoraussetzung: Es sei n ≥ n0 eine natürliche Zahl und A(n) sei richtig. Sei also

n

2 − 2n − 1 > 0.
(ii) Induktionsschritt (n → n + 1): Wir formulieren die Aussage A(n + 1) explizit:

(n + 1)² − 2(n + 1) − 1 > 0.
Beweis des Induktionsschritts:

(n + 1)² − 2(n + 1) − 1 = n

2 + 2n + 1 − 2n − 2 − 1 =

n

2 − 2n − 1 + 2n + 1 − 2 = n

2 − 2n − 1 + 2n − 1

Induktionsvoraussetzung
>
2n − 1 > 0.
Beachten Sie, dass für n ≥ 0 der Term 2n − 1 grösser als 0 ist. Mit Theorem 3.3 folgt, dass A(n) für jedes n ∈ N mit n ≥ 3 korrekt ist.

Lösungsvorschlag zu Aufgabe 3.11 Die Behauptung lässt sich sehr elegant direkt beweisen, wenn man die Zahl n

3 − n als das Produkt

n

3 − n = (n − 1)n(n + 1)
von drei Faktoren schreibt. Da die drei Zahlen (n−1), n und (n+ 1) direkt aufeinander folgen, muss genau eine von ihnen durch 3 teilbar sein. Damit besitzt aber mindestens ein Faktor den Teiler 3. Somit ist das Produkt (n − 1)n(n + 1) und dadurch auch n

3 − n durch 3 teilbar. Dies stellt einen direkten Beweis der Aussage dar.
Nun beweisen wir die Aussage auch durch vollständige Induktion. Für jedes n ∈ N mit n ≥ 2 definieren wir die Aussage A(n) als
A(n) : ⇐⇒ Die Zahl n

3 − n ist durch 3 teilbar.
(a) Induktionsanfang: Wir zeigen, dass A(2) richtig ist. Für n = 2 ist

n

3 − n = 2³ − 2 = 6
und 6 ist durch 3 teilbar. Somit stimmt die Aussage für n = 2.
(b) Induktionsschluss:
(i) Induktionsvoraussetzung: Es sei n ≥ n0 eine natürliche Zahl und A(n) sei richtig. Sei also

n

3 − n durch 3 teilbar.
(ii) Induktionsschritt (n → n + 1):

(n + 1)³ − (n + 1) =

n

3 + 3n

2 + 3n + 1 − (n + 1) =

n

3 + 3n

2 + 2n =

n

3 − n + 3n

2 + 3n =

n

3 − n
| {z }
Induktionsvoraussetzung
+ | 3(n

2 + n)
| | {z | }
ganzzahliges Vielfaches von 3
Der erste Summand ist nach Induktionsvoraussetzung durch 3 teilbar. Der zweite Summand ist als ganzzahliges Vielfaches von 3 ebenfalls durch 3 teilbar. Damit ist die Aussage auch für n + 1 erfüllt.
Mit Theorem 3.3 folgt, dass A(n) für jedes n ∈ N mit n ≥ 2 korrekt ist.

Lösungsvorschlag zu Aufgabe 3.12 Es sei x ∈ R mit x ≥ −1 eine reelle Zahl. Für jedes n ∈ N definieren wir die Aussage A(n) als

A(n) : ⇐⇒ (1 + x)

n ≥ 1 + nx.
(a) Induktionsanfang: Wir zeigen, dass A(0) richtig ist. Für n = 0 ist

(1 + x)

0 = 1 ≥ 1 + 0 · x = 1.
Somit stimmt die Aussage für n = 0.
(b) Induktionsschluss:
(i) Induktionsvoraussetzung: Es sei n ≥ n0 eine natürliche Zahl und A(n) sei richtig. Sei also

(1 + x)

n ≥ 1 + nx.
(ii) Induktionsschritt (n → n + 1): Wir formulieren die Aussage A(n + 1) explizit:

(1 + x)

n+1 ≥ 1 + (n + 1)x.
Beweis des Induktionsschritts:

(1 + x)

n+1 = (1 + x)

n
(1 + x)

Induktionsvoraussetzung und (1+x)≥0 ≥

(1 + nx)(1 + x) = 1 + x + nx + nx² = 1 + (n + 1)x + nx²

(nx²
)≥0
≥
1 + (n + 1)x.
Doch dies ist genau die Behauptung A(n + 1). Aus dem Induktionsprinzip folgt somit, dass A(n) für jedes n ∈ N korrekt ist.

Lösungsvorschlag zu Aufgabe 3.13 In Abbildung 3.4 ist eine zulässige Färbung für drei Geraden skizziert.

g1

g2

g3

(a) Drei verschiedene Geraden g1, g2 und g3 teilen die Ebene in sieben Bereiche ein.

g1

g2

g3

(b) zulässige Färbung für n = 3 Abbildung 3.4: zulässige Färbung für drei Geraden

Für jedes n ∈ N definieren wir die Aussage A(n) als
A(n) : ⇐⇒ Die Bereiche, welche durch n verschiedene Geraden in der Ebene geformt werden, besitzen eine zulässige Färbung.
(a) Induktionsanfang: Wir zeigen, dass A(0) richtig ist. Für n = 0 haben wir gar keine Gerade und nur einen einzigen Bereich (nämlich die gesamte Ebene). Dieser Bereich kann entweder golden oder blau gefärbt werden, um eine zulässige Färbung zu erhalten.
(b) Induktionsschluss:
(i) Induktionsvoraussetzung: Es sei n eine natürliche Zahl und A(n) sei richtig.
(ii) Induktionsschritt (n → n + 1):
1. Es liegen n + 1 verschiedene Geraden in der Ebene. Wählen Sie eine beliebige dieser Geraden und nennen Sie diese g. Entfernen Sie nun g aus der Ebene.
2. Gemäss Induktionsvoraussetzung besitzen die Bereiche, welche durch die n verbleibenden Geraden geformt werden, eine zulässige Färbung. Wir nennen diese zulässige Färbung die ursprüngliche Färbung.
3. Legen Sie die entfernte Gerade g wieder zurück an ihre ursprüngliche Position. Die Gerade g teilt die Ebene in zwei Hälften auf.
4. Wählen Sie eine der beiden Hälften und drehen Sie alle Farben in dieser Hälfte um: Bereiche, die zuvor golden waren, sind nun blau und umgekehrt. In der anderen Hälfte wird keine Anpassung vorgenommen. Wir beweisen nun, dass die so erhaltene neue Färbung zulässig ist.
5. Wählen Sie zwei beliebige benachbarte Bereiche A und B in der neuen Färbung. Fall 1: Falls sich A und B die Gerade g nicht als Grenzlinie teilen, dann liegen sie auf derselben Seite von g (in derselben Hälfte). Dann waren A und B bereits in der ursprünglichen Färbung verschieden gefärbt. Entweder wurden beide Farben umgekehrt oder beide wurden nicht umgekehrt. Die Färbungen bleiben trotzdem unterschiedlich.
Fall 2: Die Bereiche A und B teilen sich die Gerade g als Grenzlinie. Dann liegen A und B auf unterschiedlichen Seiten von g (in unterschiedlichen Hälften) und hatten dieselbe Farbe in der ursprünglichen Färbung. Bei dem Umkehren der Farben wurde die Farbe von genau einem der Bereiche A oder B geändert. Damit besitzen A und B in der neuen Färbung verschiedene Farben.

Wir haben dadurch bewiesen, dass A(n) für jedes n ∈ N korrekt ist.
Lösungsvorschlag zu Aufgabe 3.14 Der Nachweis der Induktionsvoraussetzung für n = 1 ist vollkommen korrekt. Die Argumentation im Induktionsschritt enthält aber einen entscheidenden Fehler. Der Fehler der Argumentation liegt darin, dass sie unerlaubterweise davon ausgeht, dass die Menge der n + 1 Pferde mindestens 3 Elemente enthält.
Zum Nachweis von A(n) für alle n ∈ N

× muss gemäss Theorem 3.3 (ii) für jede natürliche Zahl n ≥ 1 aus der Richtigkeit von A(n) die Richtigkeit von A(n + 1) folgen. Insbesondere muss also aus der Richtigkeit von A(1) die Richtigkeit von A(2) folgen. Betrachten wir also eine Menge mit nur einem Pferd und sei dieses Pferd schwarz. Wir fügen ein weiteres, diesmal ein weisses Pferd, hinzu und entfernen das schwarze Pferd. Wir haben also wieder eine Menge mit nur einem Pferd, diesmal einem weissen. Jede der beiden einelementigen Mengen enthält jeweils tatsächlich nur Pferde derselben Farbe. Fügen wir das schwarze Pferd wieder zur Menge mit dem weissen Pferd hinzu, erhalten wir eine Menge mit zwei Pferden, welche aber nicht alle von derselben Farbe sind. Was der Induktionsschritt der Aufgabenstellung also tatsächlich (und zwar korrekt) beweist, ist die Richtigkeit von A(n) für alle n ∈ N mit n ≥ 2 und nicht für alle natürlichen n ≥ 1. Dann müsste der Induktionsanfang allerdings A(2) nachweisen. Dies wird aber nicht gelingen, da es ja tatsächlich zwei Pferde mit unterschiedlichen Farben gibt. [5]
Lösungsvorschlag zu Aufgabe 3.15 1 import math

2
3 def pay(n):
4 | combs = []
5 | amax = int(math.ceil(n / 4)) + 1
6 | bmax = int(math.ceil(n / 5)) + 1
7 | for a in range(amax):
8 | for b in range(bmax):
9 | if (4*a + 5*b) == n:
10 | combs.append((a,b))
11 | return combs
| Programm 3.2: Dollar-Betrag auszahlen

Lösungsvorschlag zu Aufgabe 3.16
(a) Das entsprechende Programm ist in Listing 3.3 gegeben. 1 import math

2
3 def klotz(n):
4 | combs = []
5 | amax = int(math.ceil(n / 7)) + 1
6 | bmax = int(math.ceil(n / 8)) + 1
7 | for a in range(amax):
8 | for b in range(bmax):
9 | if (7*a + 8*b) == n:
10 | combs.append((a,b))
11 | return combs

12
13 print(klotz(38))
14 print(klotz(41))
Programm 3.3: Bauklötze
(b) siehe Teil (a)
(c) Wir definieren für jedes n ∈ N die Aussage A(n) als
A(n) : ⇐⇒ „Die Strecke der Länge n kann durch eine Kombination aus Klötzen der Längen 7 und 8 gebaut werden.“
Die Strecke n0 = 42 kann wegen 42 = 6·7+ 0·8 gebaut werden. Somit stimmt A(n0) = A(42). Zum Nachweis von A(n0+1) = A(43) dürften wir A(42) verwenden. Zum Nachweis von A(44) dürften wir A(42) und A(43) verwenden und zum Nachweis von A(45) gar A(42), A(43) und A(44) und so weiter. Wir sehen jedoch sofort, dass
43 = 5 · 7 + 1 · 8, | 44 = 4 · 7 + 2 · 8, | 45 = 3 · 7 + 3 · 8
46 = 2 · 7 + 4 · 8, | 47 = 1 · 7 + 5 · 8, | 48 = 0 · 7 + 6 · 8,
und somit sind nebst A(42) auch A(s) für s ∈ {43, 44, 45, 46, 47, 48} nachgewiesen.
Sei nun n ∈ N mit n ≥ 48. Wir beweisen, dass aus der Richtigkeit von A(k) für 42 ≤ k ≤ n die Richtigkeit von A(n + 1) folgt. Wir betrachten die Strecke der Länge n + 1 − 7. Offensichtlich gilt 42 ≤ n + 1 − 7 ≤ n. Gemäss (starker) Induktionsannahme kann die Strecke der Länge n + 1 − 7 aber durch eine Kombination aus Klötzen der Längen 7 und 8 gebaut werden. Dies ist Aussage A(n + 1 − 7) = A(n − 6). Durch das Ansetzen eines Klotzes der Länge 7 zu dieser Kombination erhalten wir eine Strecke der Länge n + 1.

Lösungsvorschlag zu Aufgabe 3.17 Aussage A(0) ist offensichtlich richtig.
Wir zeigen nun, dass aus der Richtigkeit von A(k) für 0 ≤ k ≤ n die Richtigkeit von A(n + 1) folgt. Dazu betrachten wir:

c

nX

+1

k=0

(xk) =

c

xn+1 +

Xn

k=0

(xk)

!
Distributivgesetz
=

cxn+1 + c

Xn

k=0

(xk)

Induktionsvoraussetzung
=

cxn+1 +

Xn

k=0

(cxk) =

nX

+1

k=0

(cxk).

Mit dem Prinzip der starken Induktion folgt somit die Richtigkeit der Aussage A(n) für alle n ∈ N.

# Kapitel 4

# Rekursion

## 4.1 Fakultät

Drei (unterscheidbare) Personen A, B und C stellen sich in der Mensa in einer Warteschlange an. Wie viele verschiedene Warteschlangen sind möglich? In der vordersten Position der Warteschlange platzieren wir eine der drei Personen A, B oder C. Für die vorderste Position haben wir also drei Wahlmöglichkeiten. In der mittleren Position muss genau eine der verbleibenden zwei Personen positioniert werden (zwei Wahlmöglichkeiten). Die hinterste Position muss schliesslich von der noch verbleibenden Person besetzt werden (eine Möglichkeit). Insgesamt gibt es also (gemäss den Rechengesetzen der Kombinatorik)

3 · 2 · 1 = 6
verschiedene Möglichkeiten, drei Personen in einer Reihe anzuordnen. Analog sieht man ein, dass es

n · (n − 1) · . . . · 3 · 2 · 1
Möglichkeiten gibt, n ∈ N Personen in einer Warteschlange anzuordnen. Es gibt eine Möglichkeit, 0 Personen anzuordnen, nämlich in der „leeren Warteschlange“.

Beispiel 4.1:
Es gibt 5 · 4 · 3 · 2 · 1 = 120 Möglichkeiten, fünf Personen in einer Reihe anzuordnen.

Da das Produkt n ·(n − 1)· . . . · 3 · 2 · 1 häufig in Erscheinung tritt, besitzt es einen eigenen Namen: Die Fakultät von n und wird n! oder f ak(n) geschrieben. So ist zum Beispiel 5! = 5 · 4 · 3 · 2 · 1 = 120.

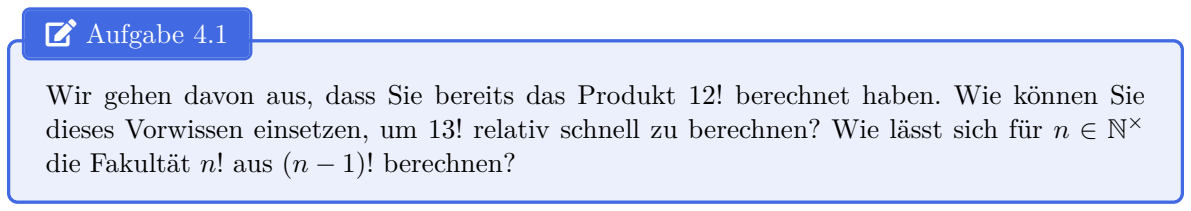
[picture p51: figure]
EDIT Aufgabe 4.1; die Fakultät n! aus (n − 1)! berechnen?

Wir gehen davon aus, dass Sie bereits das Produkt 12! berechnet haben. Wie können Sie dieses Vorwissen einsetzen, um 13! relativ schnell zu berechnen? Wie lässt sich für n ∈ N

Die in Aufgabe 4.1 gemachte Beobachtung ist zwar einfach, hat aber dennoch bedeutende Implikationen. Um 5! zu berechnen, müssen wir lediglich multiplizieren können und wissen, wie 4! berechnet wird. Das Problem der Berechnung von 5! lässt sich also auf eine Multiplikation und die Berechnung von 4! reduzieren. Doch genau gleich verhält es sich mit dem Problem der Berechnung von 4!. Diese Reduktion auf immer kleinere, aber gleichartige Probleme kann so lange fortgeführt werden, bis wir bei 0! ankommen. Betrachten Sie die folgende Berechnung:

5! = 5 · 4 · 3 · 2 · 1
| | {z | }
| 4!
4! = 4 · 3 · 2 · 1
| {z }
| 3!
3! = 3 · 2 · 1
|{z}
2!
2! = 2 · 1
|{z}
1!
1! = 1 · 0!
|{z}
1
| = 1

Durch „Rückwärtseinsetzen“ erhalten wir nun den Wert für 5!:

1! = 1 · 0! = 1
2! = 2 · 1! = 2 · 1 = 2
3! = 3 · 2! = 3 · 2 = 6
4! = 4 · 3! = 4 · 6 = 24
5! = 5 · 4! = 5 · 24 = 120.
Nach diesen Betrachtungen ist plausibel, dass Folgendes eine sinnvolle Definition der Fakultät ist:

Definition 4.1 (Fakultät):
Es sei n eine natürliche Zahl. Dann definieren wir die Fakultät n! von n durch:

n! := (

1, | falls n = 0, (Rekursionsanfang)
n(n − 1)!, falls n ≥ 1. (Rekursionsschritt)

(4.1)

Beachten Sie, dass Definition 4.1 der Fakultät selbst die Fakultät verwendet! Eine auf diese Weise definierte Funktion wird rekursiv genannt.

## 4.2 Finde den Star! (konstruktive Induktion)

Das folgende Beispiel stammt aus [6].

Definition 4.2 (finde den Star):
In einem Raum befinden sich n ∈ N Personen mit n ≥ 2 ist. Wir wollen den Star unter diesen n Personen finden. Ein Star ist definiert als eine Person, welche niemanden anderen kennt, jedoch von allen gekannt wird. Die einzige erlaubte Operation, um einen Star zu identifizieren, ist, eine Person A zu fragen:
„Kennst Du Person B?“,
wobei A 6= B gilt. Das Problem finde den Star besteht nun darin, den Star unter den n Personen in dem Raum zu identifizieren oder herauszufinden, dass es gar keinen Star unter diesen n Personen gibt.

Begründen Sie, warum es unter n Personen in einem Raum nicht zwei verschiedene Stars

Wir wollen das Problem finde den Star mit möglichst wenigen Fragen (Operationen) finden. Eine naive Lösung besteht darin, jede Person über jede andere zu befragen („alle mit allen“) . Für n = 4 könnte ein Resultat einer solchen Befragung wie folgt aussehen:
- | 1 | 2 | 3 | 4
1 | - | Ja Nein Nein
2 | Nein - Nein Nein
3 Ja Ja | - | Nein
4 Ja Ja Ja | -

Dabei bedeutet der Eintrag Nein, dass Person 2 die Person 4 nicht kennt und somit die Frage „Kennst Du Person 4?“ mit „Nein“ beantwortet. Hier ist Person 2 der Star. Bei n Personen werden bei diesem Vorgehen offensichtlich genau n(n−1) Fragen gestellt (jede der n Personen wird zu allen n − 1 anderen befragt).
Wir wollen versuchen, die Anzahl der Fragen zu reduzieren. Dazu wenden wir ein Vorgehen an, welches manchmal konstruktive Induktion genannt wird. Wir zerlegen das Problem, den Star unter n Personen zu finden, in kleinere Probleme:
- Für n = 2 genügen zwei Fragen.
- Sei n > 2: Schicke eine Person A weg. Finde nun den Star unter n − 1 Personen (kleineres Problem). Überprüfe danach A mit 2(n − 1) Fragen.
Doch dieses Vorgehen können wir weiter fortsetzen und dieselbe Strategie auf das Problem mit n − 1 Personen (das kleinere Problem) anwenden. Schliesslich gelangen wir zu dem Problem mit 2 Personen, für welches zwei Fragen genügen. Insgesamt stellen wir also fest:

F(n) =
2(n − 1) + F(n − 1) =
2(n − 1) + 2(n − 2) + F(n − 2) =
2(n − 1) + 2(n − 2) + 2(n − 3) + F(n − 3) =

2(n − 1) + 2(n − 2) + 2(n − 3) + 2(n − 4) + . . . + 2 = 2(1 + 2 + 3 + . . . + (n − 2) + (n − 1)) kleiner Gauss =

2

n(n − 1)
2
| =

n(n − 1).
Somit haben wir gegenüber der ursprünglichen naiven Lösung (befrage alle zu allen) nichts gewonnen. Zum Glück ist es aber kein grosser Aufwand unseren Ansatz der konstruktiven Induktion stark zu verbessern und somit zu retten. Die Idee der Verbesserung besteht darin, sicherzustellen, dass die Person, welche wir aus dem Raum schicken, kein Star ist.

Erklären Sie, warum eine einzige Frage an eine beliebige Person im Raum stets genügt, um eine Person zu identifizieren, welche sicherlich kein Star ist.

Zum Schluss bleiben zwei Personen, von denen möglicherweise eine Person X der Star ist. Wir überprüfen mit jeder Person, die draussen ist, ob X ein Star sein kann. Mit dieser Verbesserung erhalten wir F(2) = 2 und F(n) = 1 + F(n − 1) + 2 für n ≥ 3, also insgesamt:

F(n) = (

2, | falls n = 2,
1 + F(n − 1) + 2, falls n ≥ 3.

(4.2)

Ähnlich wie bei unserer Betrachtung der Fakultät, sehen wir auch hier, dass sich die Bestimmung der Anzahl benötigter Fragen F(n) bei n Personen auf die Bestimmung des kleineren (aber analogen) Problems F(n − 1) reduzieren lässt.
EDIT Aufgabe 4.4
Wir haben für die benötigten Fragen F(n) für einen Raum mit n Personen die Beziehung in Gleichung (4.2) gefunden. Wir vermuten, dass wir den Wert für F(n) durch wiederholte Reduktion auf kleinere Probleme wie folgt „entpacken“ können:

F(n) = 3 + F(n − 1) = 2 · 3 + F(n − 2) = . . . = 3 · (n − 2) + 2 = 3n − 4.
Beweisen Sie durch vollständige Induktion, dass F(n) := 3n − 4 tatsächlich Gleichung (4.2) erfüllt. Berechnen Sie schliesslich, wie viele Fragen wir mit diesem Verfahren bei n = 1000 Personen benötigen.

## 4.3 Rekursion in Algorithmen

In diesem Abschnitt wollen wir beginnen zu verstehen, wie Probleme rekursiv mithilfe von Programmen gelöst werden können. Zum Einstieg betrachten wir nochmals die (rekursive) Definition der Fakultät in Gleichung (4.1). Lassen Sie uns an dieser Stelle wagemutig sein! Wir „übersetzen“ die Definition direkt in die Python-Programmiersprache und lassen uns von dem Ergebnis überraschen: 1 def factorial(n):
if n == 0:
return 1 # Rekursionsanfang
else:
return n * factorial(n-1) # Rekursionsschritt Programm 4.1: rekursive Fakultäts-Funktion

Wir haben Definition 4.1 praktisch eins zu eins „abgetippt“. Beachten Sie, dass in der Definition der Funktion factorial die Funktion factorial selbst verwendet wird. Wie und warum funktioniert dieses Vorgehen? Listing 4.2 zeigt schematisch auf, wie der Funktionsaufruf factorial(3) abgearbeitet wird. Beachten Sie die Ähnlichkeit zu unserer Diskussion in Abschnitt 4.1.

1 ## anfängliche Aufrufe ##

3 # Aufruf 0:
4 factorial(3)
5 return 3 * factorial(2) # Rekursionsschritt (Zeile 5)
v
# Aufruf 1:

factorial(2)
return 2 * factorial(1) # Rekursionsschritt (Zeile 5)
v
# Aufruf 2:

factorial(1)
return 1 * factorial(0) # Rekursionsschritt (Zeile 5)
v
# Aufruf 3:

factorial(0)
return 1 # Rekursionsanfang (Zeile 2)

25 ## Rückwärtseinsetzen ##
26 factorial(1) = 1 * factorial(0) = 1 * 1 = 1 27 factorial(2) = 2 * factorial(1) = 2 * 1 = 2
28 factorial(3) = 3 * factorial(2) = 3 * 2 = 6
Programm 4.2: rekursive Berechnung der Fakultät

Der anfängliche Aufruf factorial(3) löst (rekursiv) in seinem return auf (seiner) Zeile 5 den Aufruf factorial(2) aus. Dieser löst rekursiv einen weiteren Funktionsaufruf aus. Dies geht so lange weiter, bis zum ersten Mal ein Aufruf den Rekursionsanfang (Zeile 2) erreicht. Danach können die noch ausstehenden return-Statements endlich komplettiert werden (Rückwärtseinsetzen).

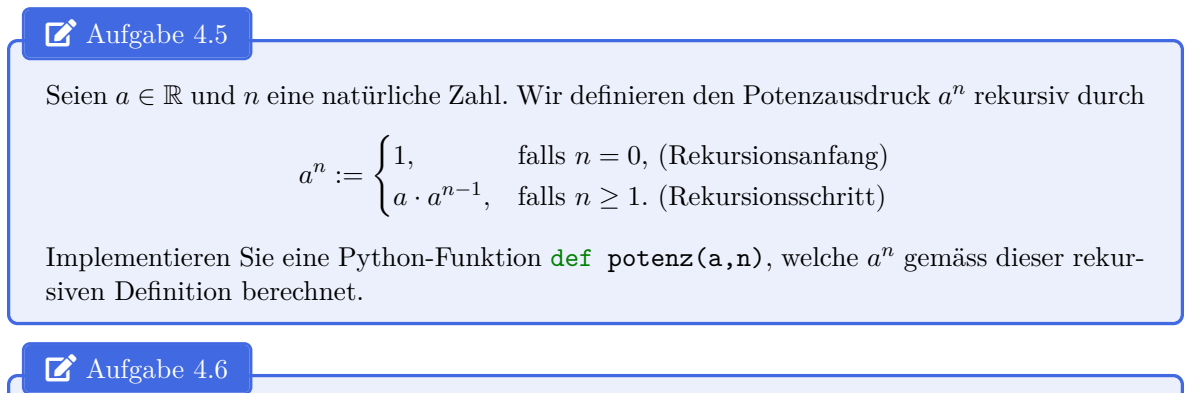
[picture p52: figure]
EDIT Aufgabe 4.5; rekursiv durch; falls n = 0, (Rekursionsanfang); , falls n ≥ 1. (Rekursionsschritt); n gemäss dieser rekur-; siven Definition berechnet.; EDIT Aufgabe 4.6

Seien a ∈ R und n eine natürliche Zahl. Wir definieren den Potenzausdruck a

Implementieren Sie eine Python-Funktion def potenz(a,n), welche a

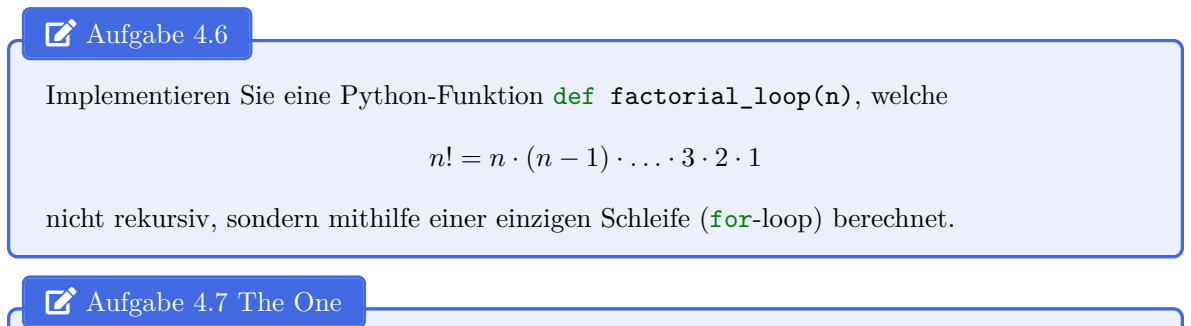
[picture p53: figure]
EDIT Aufgabe 4.7 The One

Implementieren Sie eine Python-Funktion def factorial_loop(n), welche

nicht rekursiv, sondern mithilfe einer einzigen Schleife (for-loop) berechnet.

Sie arbeiten für eine respektable Softwareentwicklungsfirma. Ihr Arbeitskollege Thomas A. Anderson hat folgende Python-Funktion zu Ihrem Softwareprojekt hinzugefügt:

1 # m und n sind natürliche Zahlen.
2 def unbekannt(m,n):
3 | if m == 0:
4 | return 0
5 | else:
6 | return unbekannt(m-1,n) + n
(a) Handelt es sich bei unbekannt um eine rekursiv oder nicht rekursiv definierte Funktion? Begründen Sie Ihre Antwort.
(b) Thomas A. Anderson hat sich schon einige Tage nicht in der Firma blicken lassen und Sie können ihn telefonisch nicht erreichen. Abgesehen von dem Kommentar in Zeile 1 hat er die Funktion unbekannt nicht dokumentiert und der Name der Funktion hilft uns nicht weiter. Erklären Sie genau, was die Funktion tut und geben Sie ihr einen treffenden Namen.
Tipp: Berechnen Sie die Werte
- unbekannt(0,4),
- unbekannt(1,4),
- unbekannt(2,4),
- und unbekannt(3,4)
„von Hand“ und leiten Sie daraus ab, was die Funktion tut.
(c) Was ist der Rückgabewert von unbekannt(100,50)?

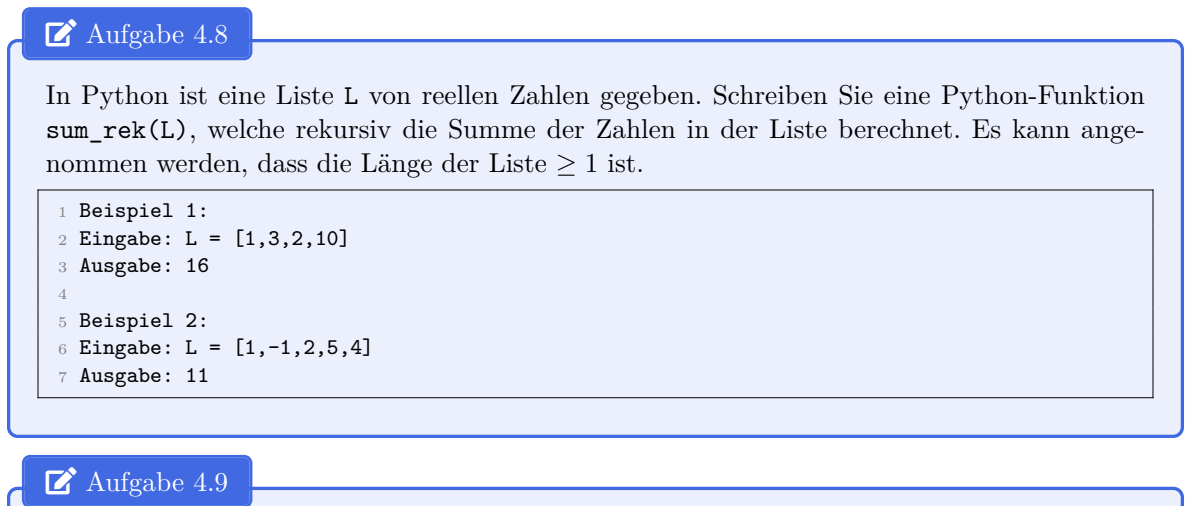
[picture p54: figure]
EDIT Aufgabe 4.8; 1 Beispiel 1: 2 Eingabe: L = [1,3,2,10] 3 Ausgabe: 16; 4 5 Beispiel 2: 6 Eingabe: L = [1,-1,2,5,4] 7 Ausgabe: 11; EDIT Aufgabe 4.9

In Python ist eine Liste L von reellen Zahlen gegeben. Schreiben Sie eine Python-Funktion sum_rek(L), welche rekursiv die Summe der Zahlen in der Liste berechnet. Es kann angenommen werden, dass die Länge der Liste ≥ 1 ist.

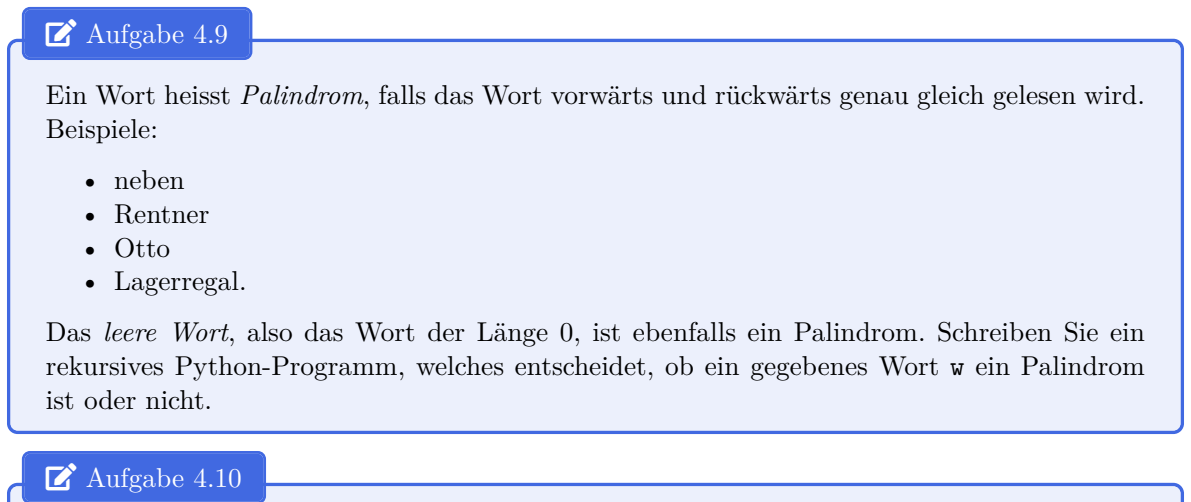
[picture p55: figure]
Beispiele: • neben • Rentner • Otto • Lagerregal.; ist oder nicht.; EDIT Aufgabe 4.10

Ein Wort heisst Palindrom, falls das Wort vorwärts und rückwärts genau gleich gelesen wird.

Das leere Wort, also das Wort der Länge 0, ist ebenfalls ein Palindrom. Schreiben Sie ein rekursives Python-Programm, welches entscheidet, ob ein gegebenes Wort w ein Palindrom

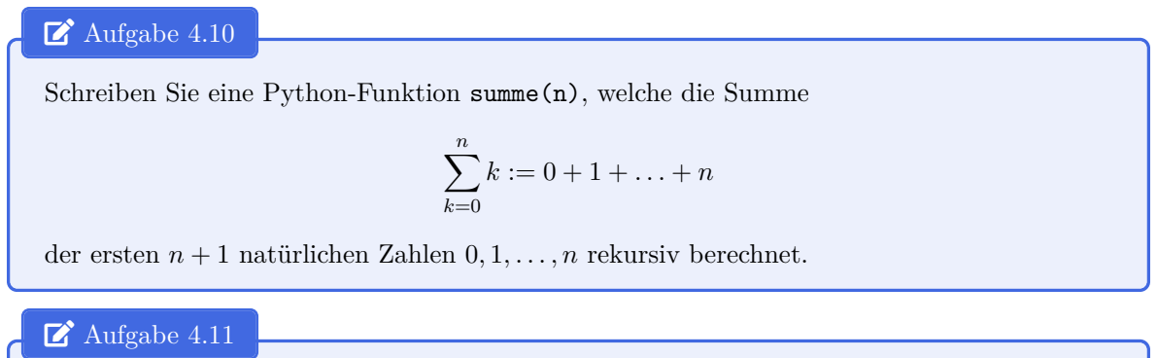
[picture p56: figure]
EDIT Aufgabe 4.11

Schreiben Sie eine Python-Funktion summe(n), welche die Summe

der ersten n + 1 natürlichen Zahlen 0, 1, . . . , n rekursiv berechnet.

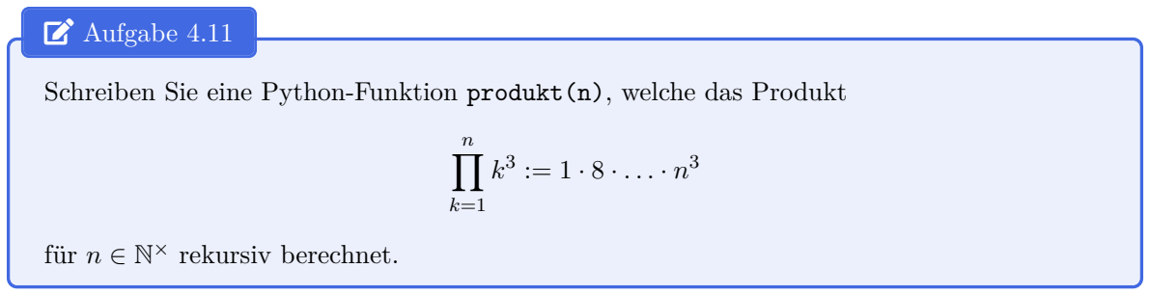
[picture p57: figure]
für n ∈ N; × rekursiv berechnet.

Schreiben Sie eine Python-Funktion produkt(n), welche das Produkt

## 4.4 Fibonacci-Folge

In der zweiten Fassung des Buches Liber abbaci („Buch der Rechenkunst“) beschrieb der italienische Mathematiker Leonardo da Pisa, bekannt als Fibonacci, das Wachstum einer Kaninchenpopulation.
- Jedes geschlechtsreife Paar Kaninchen wirft pro Monat genau ein Paar Kaninchen (ein Weibchen und ein Männchen). Die Austragungszeit (Dauer der Schwangerschaft) dauert bei Kaninchen also immer genau einen Monat. Jeden Monat kommt also eine neue Generation von Kaninchen zur Welt.
- Ein neugeborenes Paar von Kaninchen wird erst am Ende seines ersten Lebensmonats geschlechtsreif und wirft entsprechend erst Ende seines zweiten Lebensmonats sein erstes Paar Kaninchen.
- Kein Kaninchen stirbt, kein Kanninchen verlässt das betrachtete System und kein Kanninchen wird, ausser durch Geburt, in das System hineingebracht.
Sei Gn die Anzahl der geschlechtsreifen Kaninchenpaare und gn die Anzahl der nicht geschlechtsreifen Kaninchenpaare der Generation n für n ∈ N. Beachten Sie, dass die gesamte Anzahl der Kaninchenpaare der Generation n damit der Summe Fn := Gn + gn entspricht. Betrachten wir nun die obigen Regeln für das Wachstum einer Kaninchenpopulation für alle n ∈ N. Es gilt
Gn+2 = Gn+1 + gn+1, | (4.3)
da die geschlechtsreifen Kaninchen Gn+1 der Generation n + 1 auch einen Monat später noch geschlechtsreif sein werden und die nicht geschlechtsreifen Kaninchen gn+1 der Generation n+ 1 einen Monat später geschlechtsreif sein werden. Völlig analog begründet man die Gleichung
Gn+1 = Gn + gn. | (4.4)
Des Weiteren gilt offensichtlich
gn+2 = Gn+1. | (4.5)
Wir haben also drei Gleichungen für die Population:
Gn+2 = Gn+1 + gn+1 | (4.6)
Gn+1 = Gn + gn | (4.7)
gn+2 = Gn+1 | (4.8)

Das Einsetzen von Gleichung 4.7 in Gleichung 4.6 liefert:

Gn+2 = Gn + gn + gn+1
⇐⇒

Gn+2 + gn+2
| | {z | }
Fn+2

= Gn+1 + gn+1
| | {z | }
Fn+1

+ Gn + gn
| {z }
Fn

Für die Gesamtzahl der Population der Kaninchenpaare gilt also

Fn+2 = Fn+1 + Fn
für alle n ∈ N. Für Generation n = 0 definieren wir G0 := 0 und g0 := 0. Zu Beginn, also in der Generation n = 1, wird ein erstes Paar von Kaninchen in das System eingeführt. Dieses erste Paar wird erst nach einem Monat geschlechtsreif. Es gilt also G1 = 0 und g1 = 1. Somit besteht die Generation n = 2 immer noch aus nur einem Paar Kaninchen: G2 = 1 und g2 = 0. Die Generation n = 3 aus zwei Paaren: G3 = 1 und g3 = 1. Logisch fortgeführt findet man die sogenannte Fibonacci-Folge:

F0 = 0, F1 = 1, F2 = 1, F3 = 2, F4 = 3, F5 = 5, F6 = 8, F7 = 13, F8 = 21, F9 = 34, F10 = 55, F11 = 89, . . .
Beginnend mit den „Startwerten“ F0 := 0 und F1 := 1 ergibt sich Fn+2 also für jedes n ∈ N aus der Summe der beiden unmittelbaren Vorgänger Fn+1 und Fn, also

Fn+2 = Fn+1 + Fn.

Definition 4.3 (Fibonacci-Folge):
Die Fibonacci-Folge ist rekursiv definiert durch

Fn :=

0, | falls n = 0, (Rekursionsanfang)
1, | falls n = 1, (Rekursionsanfang)
Fn−1 + Fn−2, falls n ≥ 2. (Rekursionsschritt)

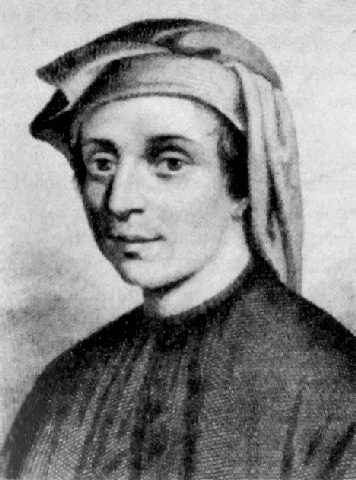
[picture p58: figure]

Abbildung 4.1: Leonardo da Pisa (1170-1240), auch Fibonacci genannt

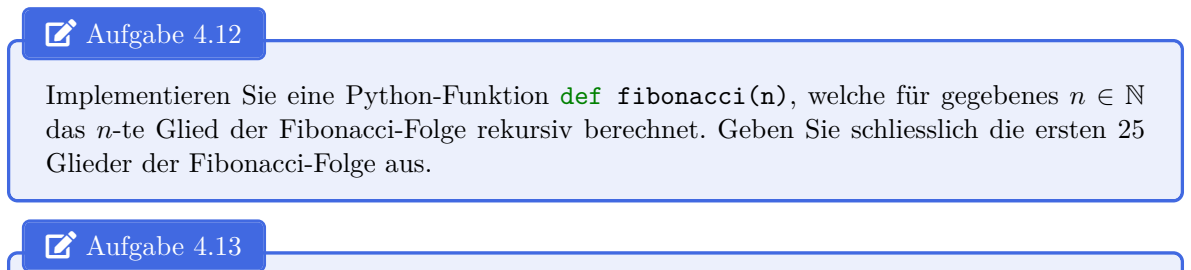
[picture p59: figure]
EDIT Aufgabe 4.12; Glieder der Fibonacci-Folge aus.; EDIT Aufgabe 4.13

Implementieren Sie eine Python-Funktion def fibonacci(n), welche für gegebenes n ∈ N das n-te Glied der Fibonacci-Folge rekursiv berechnet. Geben Sie schliesslich die ersten 25

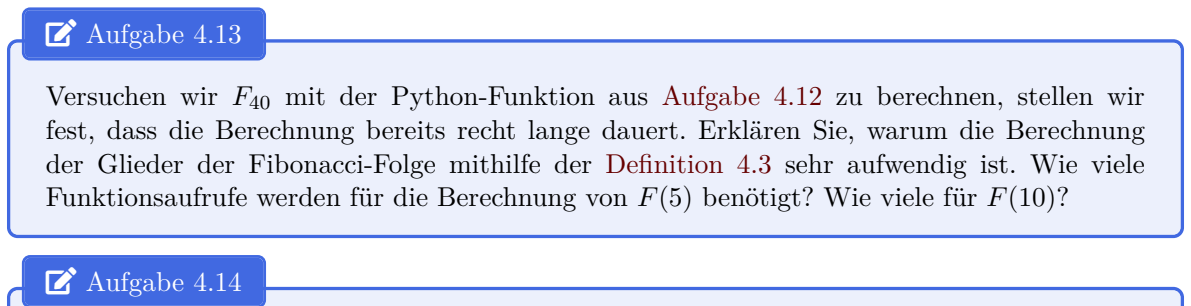
[picture p60: figure]
EDIT Aufgabe 4.14

Versuchen wir F40 mit der Python-Funktion aus Aufgabe 4.12 zu berechnen, stellen wir fest, dass die Berechnung bereits recht lange dauert. Erklären Sie, warum die Berechnung der Glieder der Fibonacci-Folge mithilfe der Definition 4.3 sehr aufwendig ist. Wie viele Funktionsaufrufe werden für die Berechnung von F(5) benötigt? Wie viele für F(10)?

Überlegen Sie sich, wie Sie die ersten 30 Glieder der Fibonacci-Folge „von Hand“ berechnen würden. Verwenden Sie diese Intuition um eine Python-Funktion
def fibonacci_fast(n)
zu schreiben, welche für gegebenes n ∈ N das n-te Glied der Fibonacci-Folge deutlich schneller und auf nicht rekursive Weise berechnet. Berechnen Sie mithilfe dieser Funktion das Folgeglied

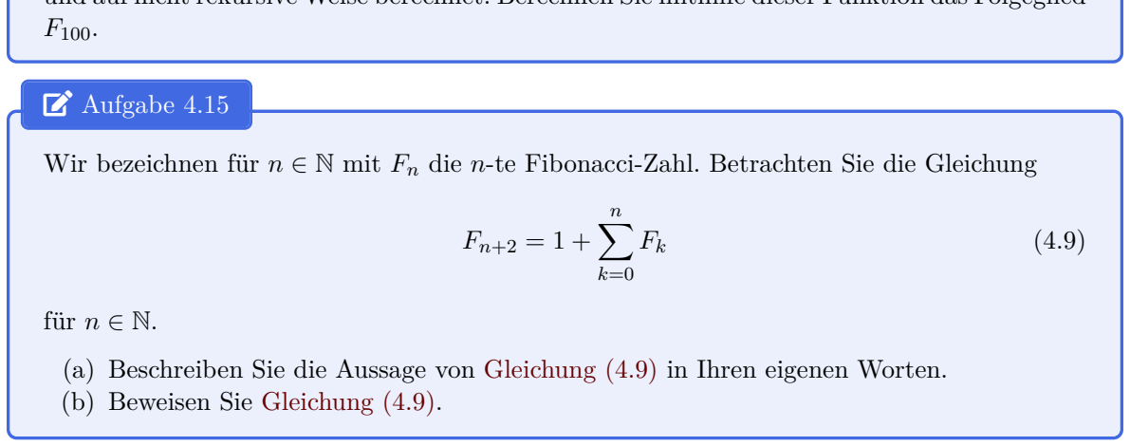
[picture p61: figure]
EDIT Aufgabe 4.15; für n ∈ N.; (b) Beweisen Sie Gleichung (4.9).

Wir bezeichnen für n ∈ N mit Fn die n-te Fibonacci-Zahl. Betrachten Sie die Gleichung

(a) Beschreiben Sie die Aussage von Gleichung (4.9) in Ihren eigenen Worten.

## 4.5 Technische Umsetzung rekursiver Programme

In diesem Abschnitt werden wir den Übergang von der rein mathematischen Betrachtung rekursiver Algorithmen zu deren technischer Umsetzung vollziehen. Dazu betrachten wir ein Beispiel eines eleganten rekursiven Algorithmus, welcher für eine gegebene natürliche Zahl n sämtliche binären Strings der Länge n ausgibt. Insbesondere sollte der Algorithmus für die gegebenen Eingaben in den folgenden Testfällen die angegebenen Ausgaben erzeugen:

TESTFALL 0
Eingabe: n = 0
Ausgaben:

(Es wird eine leere Zeile (leerer String) ausgegeben.) TESTFALL 1
Eingabe: n = 1
Ausgaben:
0
1
TESTFALL 2
Eingabe: n = 2
Ausgaben:
00
01
10
11
TESTFALL 3
Eingabe: n = 3
Ausgaben:
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
Programm 4.3: binäre Strings rekursiv ausgeben

Sie sind gerne eingeladen, an dieser Stelle vorerst nicht weiterzulesen und den Algorithmus selbst zu schreiben.
Unser Vorschlag für einen entsprechenden rekursiven Algorithmus ist in Listing 4.4 gegeben.

1 def binaryStrings(n, w = ''):
2 | if n == 0:
3 | print(w)
4 | return
5 | binaryStrings(n-1, w + '0')
6 | binaryStrings(n-1, w + '1')
7 | #return # optional
Programm 4.4: binaryStrings

Zur Vereinfachung und Konkretisierung der Beschreibung der technischen Realisation rekursiver Algorithmen werden wir sämtliche Betrachtungen dieses Abschnitts auf den Algorithmus in Listing 4.4 beziehen. Der Algorithmus beginnt mit dem leeren String und baut alle gesuchten Strings durch systematisches „Anhängen“ von Nullen und Einsen auf. Zur Abkürzung schreiben wir anstelle von binaryString(...) im Folgenden f(...).

Betrachten wir den Aufruf f(2,''), um alle Strings der Länge 2 auszugeben. Die Arbeitsschritte, welche der Funktionsaufruf f(2,'') einleitet, sind in Abbildung 4.2 dargestellt. Die grünen Knoten stellen Funktionsaufrufe (Aufrufe von f) dar. Die goldenen Knoten stellen Aufrufe der Python-Funktion print dar. Beim Schritt mit Nummer 0 erfolgt der anfängliche Aufruf f(2,''). In diesem Aufruf wird in Programmzeile 5 der Funktionsaufruf f(1,'0') ausgelöst (Schritt 1). Beachten Sie, dass der ursprüngliche Aufruf f(2,'') seine Arbeit noch nicht abgeschlossen hat! In Programmzeile 5 des Funktionsaufrufs f(1,'0') wird nun der Aufruf f(0,'00') ausgelöst. In diesem Aufruf ist die if-Bedingung auf Programmzeile 2 erfüllt, sodass die Ausgabe print('00') erfolgt (Schritt
3) und der return-Aufruf auf Programmzeile 4 erfolgt. Der Aufruf f(0,'00') ist beendet und er springt zurück zum Aufruf f(1,'0') (Schritt 4). Der Funktionsaufruf f(1,'0') kann nun (endlich) zu Programmzeile 6 gelangen und den Aufruf f(0,'01') auslösen (Schritt 5).

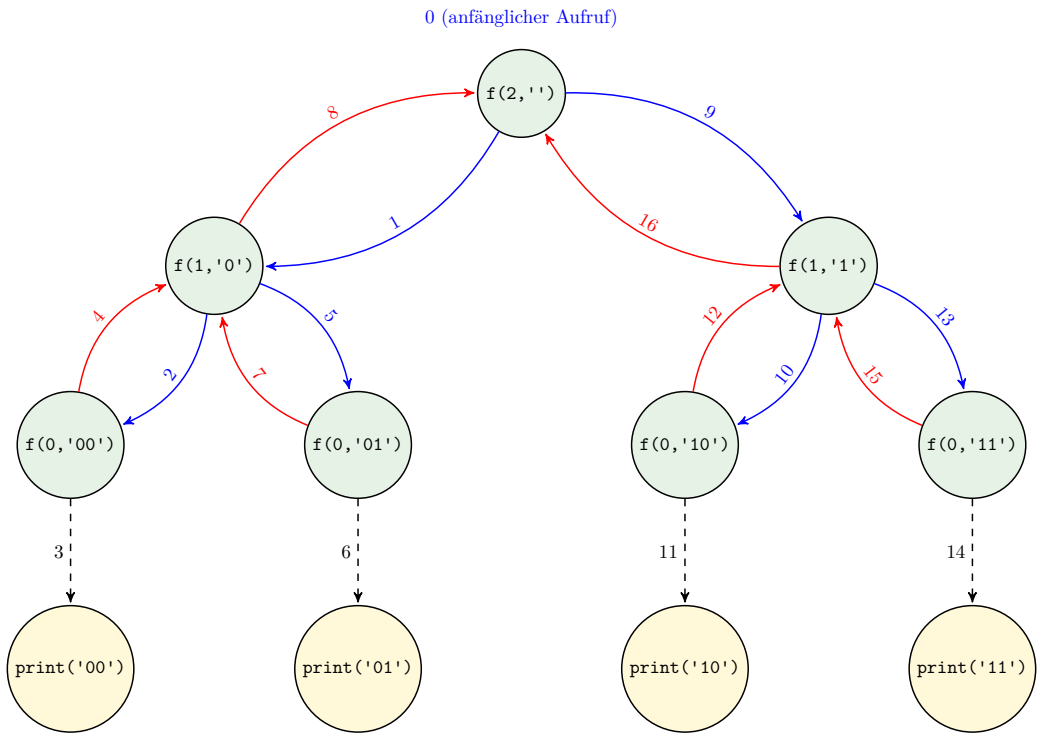
[picture p62: figure]
print('00'); print('01'); print('10'); print('11'); 0 (anfänglicher Aufruf)

Abbildung 4.2: schematische Darstellung der Arbeitsschritte zur rekursiven Ausgabe aller binären Strings der Länge 2

Erst nachdem auch f(0,'01') seine Arbeit beendet hat (Schritte 6 und 7), erreicht der Aufruf f(1,'0') seine Programmzeile 7 und springt zurück zum ursprünglichen Aufruf f(2,'') (Schritt 7). Dieser erreicht nun Programmzeile 6 und ruft f(1,'1') auf (Schritt 9). Die Schritte in dieser „rechten“ Hälfte von Abbildung 4.2 lassen sich nun analog beschreiben. Erst nach der Rückgabe des Aufrufs f(1,'1') in Schritt 16 kann schliesslich der ursprüngliche Aufruf f(2,'') seine Arbeit beenden.

Zusammenfassung 4.1:
Wie werden rekursive Programme in Computern realisiert? In Computern wird für jeden Funktionsaufruf (Prozedur) ein Abschnitt im Speicher angelegt. Dieser Speicherabschnitt wird Stack-Frame genannt. Darin darf die Funktion Speicherplatz zum Beispiel für lokale Variablen belegen. Deshalb benötigen rekursive Programme mit zahlreichen rekursiven Aufrufen viel Platz im Speicher.
Ruft eine Prozedur A eine andere Prozedur B auf, so wird im Stack-Frame von Prozedur B eine sogenannte Rücksprung-Adresse gespeichert. Diese Adresse gibt an, wo im Speicher die Prozedur A beginnt. Dadurch wird ermöglicht, dass Prozedur B zu Prozedur A „zurückspringen“ kann (jump and link). Mehr Details bezüglich der Funktionsweise von Computern und rekursiven Programmen finden Sie in den hervorragenden Texten [7] und [8].

## 4.6 Lösungen der Aufgaben

Lösungsvorschlag zu Aufgabe 4.1 Wir beobachten, dass 13! = 13 · 12! gilt. Somit müssen wir 12! lediglich mit 13 multiplizieren um 13! zu erhalten. Für n ∈ N

× gilt allgemein

n! = n · (n − 1)!.

Lösungsvorschlag zu Aufgabe 4.2 Angenommen es gäbe zwei Stars S1 und S2 in dem Raum. Da S2 ein Star ist, wird S2 von allen anderen gekannt. Insbesondere kennt S1 die Person S2. Damit kann aber S1 selbst kein Star sein. Dies ist ein Widerspruch zu unserer Annahme, dass sowohl S1 als auch S2 Stars sind. Lösungsvorschlag zu Aufgabe 4.3 Frage eine beliebige Person A im Raum, ob sie eine andere beliebige Person B kennt.
- Falls A die Person B kennt ⇒ A ist kein Star.
- Falls A die Person B nicht kennt ⇒ B ist kein Star.
In jedem der Fälle haben wir mit einer einzigen Frage eine Person identifiziert, welche sicherlich kein Star ist.
Lösungsvorschlag zu Aufgabe 4.4
Der Induktionsanfang ist klar, denn für n = 2 benötigen wir genau zwei Fragen. Sei nun die Behauptung für ein n ∈ N mit n ≥ 2 wahr. Dann gilt

F(n + 1) = F(n) + 3 = 3n − 4 + 3 = 3n − 1,
doch dies ist genau die Behauptung, denn 3(n + 1) − 4 = 3n + 3 − 4 = 3n − 1.
Gemäss der soeben bewiesenen Formel sind mit unserem Vorgehen genau F(1000) = 3 · 1000 − 4 = 2996 Fragen notwendig. Beachten Sie, dass wir in keinster Weise behaupten, dass dieses Vorgehen optimal ist.

Lösungsvorschlag zu Aufgabe 4.5

1 def potenz(a,n):
2 | if n == 0:
3 | return 1
4 | else:
5 | return a * potenz(a,n-1)
Programm 4.5: rekursive Potenz-Funktion

Lösungsvorschlag zu Aufgabe 4.6

1 def factorial_loop(n):
2 | factorial = 1
3 | if n == 0:
4 | return factorial
5 | else:
6 | for k in range(1,n+1):
7 | factorial *= k
8 | return factorial
Programm 4.6: rekursive Potenz-Funktion

Lösungsvorschlag zu Aufgabe 4.7
(a) Die Python-Funktion ist rekursiv definiert, da sie sich selbst aufruft.
(b) Die unbekannte Funktion multipliziert die Zahlen m und n, realisiert also die Operation m·n. In der Tat sieht man, dass die Funktion so lange n addiert, bis m = 0 ist. Ein treffender Name für die Funktion wäre zum Beispiel mult(m,n).
(c) Der Rückgabewert ist 100 · 50 = 5000.
Lösungsvorschlag zu Aufgabe 4.8

1 def sum_rek(L):
2 | if len(L) == 1:
3 | return L[0]
4 | else:
5 | return sum_rek(L[:-1]) + L[-1]
Lösungsvorschlag zu Aufgabe 4.9

1 def check_palindrom(w):
2 | w = w.upper()
3 | if len(wort) <= 1:
4 | return True
5 | elif w[0] != w[-1]:
6 | return False
7 | return check_palindrom(w[1:-1])
oder noch kürzer:

1 def check_palindrom(w):
2 | return (True if len(w) <= 1 else (check_palindrom(w[1:-1]) if w[0].lower() == w[-1].lower()
| else False))
Lösungsvorschlag zu Aufgabe 4.10

1 def summe(n):
2 | if n == 0:
3 | return 0
4 | else:
5 | return n + summe(n-1)
Programm 4.7: rekursive Berechnung einer Summe

Lösungsvorschlag zu Aufgabe 4.11

1 def produkt(n):
2 | if n == 1:
3 | return 1
4 | else:
5 | return n**3 * produkt(n-1)
Programm 4.8: rekursive Berechnung eines Produkts

Lösungsvorschlag zu Aufgabe 4.12

1 def fibonacci(n):
2 | if n <= 1:
3 | return n
4 | else:
5 | return fibonacci(n-1) + fibonacci(n-2)
Programm 4.9: rekursive Berechnung der Fibonacci-Folge

Die ersten 25 Glieder der Fibonacci-Folge lauten:

1 0
2 1
3 1
4 2
5 3
6 5
7 8
8 13
9 21
10 34
11 55
12 89
13 144
14 233
15 377
16 610
17 987
18 1597
19 2584
20 4181
21 6765
22 10946
23 17711
24 28657
25 46368
Programm 4.10: die ersten 25 Glieder der Fibonacci-Folge

Lösungsvorschlag zu Aufgabe 4.13 Die rekursiv definierte Python-Funktion aus Aufgabe 4.12 berechnet viele Folgeglieder mehrfach und arbeitet somit sehr „verschwenderisch“. Beispielsweise werden bei der Berechnung von F40 die Berechnungen von F39 und F38 aufgerufen. Doch zur Berechnung von F39 muss nochmals F38 berechnet werden und so weiter. In Abbildung 4.3 wird gezeigt, welche Funktionsaufrufe für die rekursive Berechnung von F(5) benötigt werden. Beachten Sie, dass beispielsweise der Wert fib(2) dreimal berechnet wird. Es ist klar, dass die Anzahl der benötigten Funktionsaufrufe (und somit sicherlich auch die benötigten Rechenoperationen) zur Berechnung von F(n) mit wachsendem n stark ansteigt. Jede Fibonacci-Zahl, ausser F(1) und F(2), löst jeweils zwei Funktionsaufrufe aus. Die genaue Anzahl A(n) der benötigten Funktionsaufrufe (dies ist nicht offensichtlich) ist gegeben durch

A(n) = 2F(n + 1) − 1.
In Kapitel 5 werden Sie sehen, dass die Fibonacci-Folge exponentiell wächst.
fib(5)

fib(4)

fib(3)

fib(2)

fib(1) fib(0)

fib(1)

fib(2)

fib(1) fib(0)

fib(3)

fib(2)

fib(1) fib(0)

fib(1)

Abbildung 4.3: Die Anzahl Funktionsaufrufe für F(5) ist 15.

Lösungsvorschlag zu Aufgabe 4.14 Die folgende Python-Funktion startet zur Berechnung von Fn bei den Startwerten F0 und F1 und berechnet „von unten her“ nacheinander (man spricht in diesem Zusammenhang von iterativer Berechnung) die Nachfolger. Dabei werden keine Berechnungen „verschwendet“.

1 def fibonacci_fast(n):
# Startwerte

f0 = 0
f1 = 1
if n == 0:
return f0
elif n == 1:
return f1

for k in range(n-1):
f2 = f1 + f0
# Update

f0 = f1
f1 = f2
return f2
Programm 4.11: iterative Berechnung der Fibonacci-Folge

Mithilfe dieser Funktion berechnen wir (in sehr kurzer Zeit)

F100 = 354224848179261915075.

Lösungsvorschlag zu Aufgabe 4.15
(a) Die (n+ 2)-te Fibonacci-Zahl ist um 1 grösser als die Summe der Fibonacci-Zahlen F0, . . . , Fn.
(b) Wir beweisen die Behauptung durch vollständige Induktion. Für n = 0 haben wir

1 +X

0

k=0

Fk = 1 + F0 = 1 + 0 = 1 = F2.

Wir gehen nun von der Induktionsvoraussetzung

Fn+1 = 1 +

nX⁻¹

k=0

Fk

aus und finden

Fn+2 =
Fn + Fn+1 =

Fn +

1 +

nX⁻¹

k=0

Fk

!
=

1 +Xn

k=0

Fk.

# Kapitel 5

# Binäre Strings ohne aufeinanderfolgende Einsen

In Listing 4.4 haben wir bereits eine Python-Funktion geschrieben, welche rekursiv alle binären Strings einer gegebenen Länge n ausgibt. Es wird sich ein interessanter und überraschender Zusammenhang zur Fibonacci-Folge ergeben, wenn wir nicht alle binären Strings der Länge n ausgeben, sondern nur die binären Strings der Länge n, welche nicht das Muster 11 (Eins-Eins) enthalten. Wir interessieren uns also nur für die binären Strings, welche nicht zwei aufeinanderfolgende Einsen

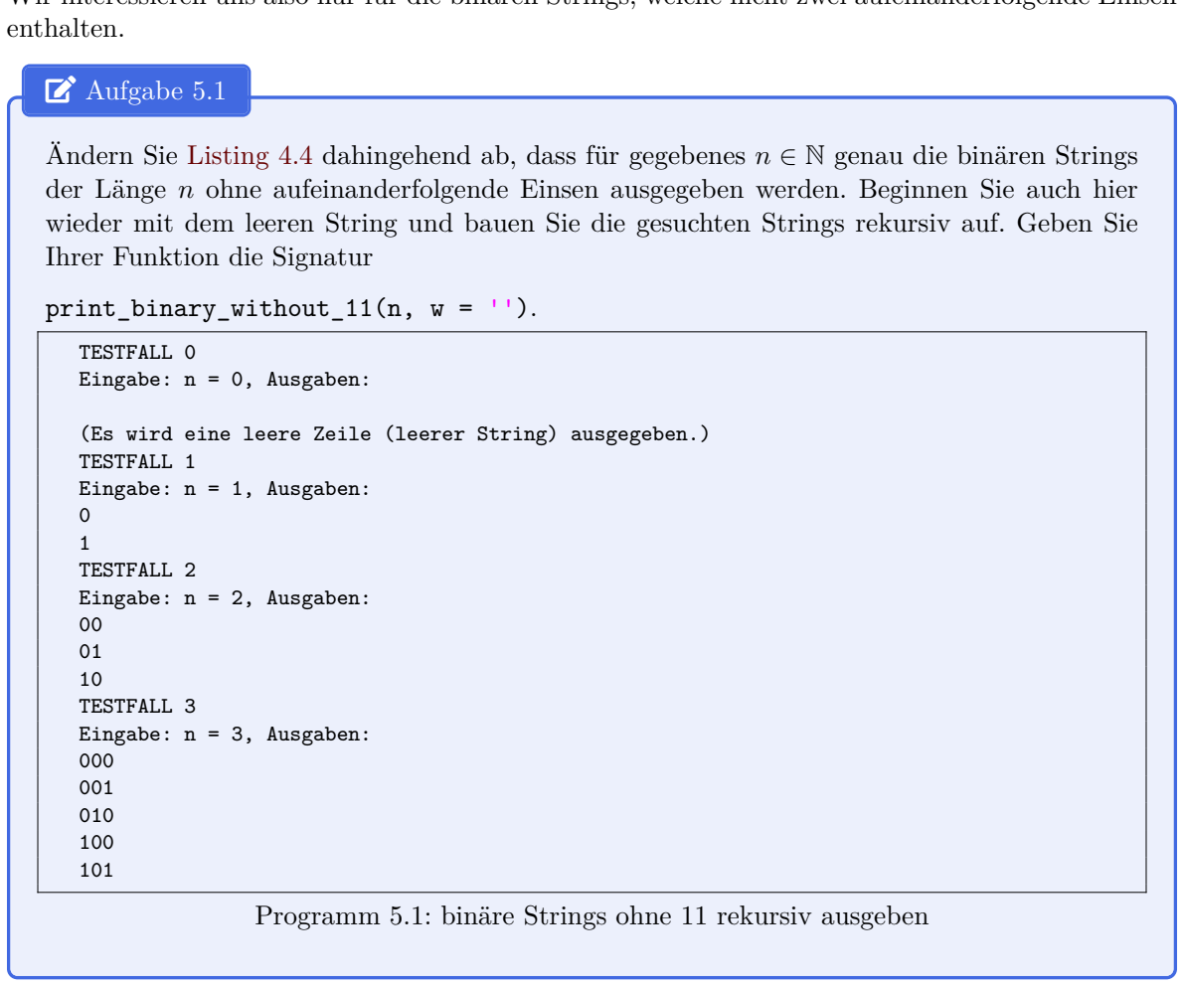
[picture p63: figure]
enthalten.; EDIT Aufgabe 5.1; Ihrer Funktion die Signatur print_binary_without_11(n, w = '').; TESTFALL 0 Eingabe: n = 0, Ausgaben:; TESTFALL 1 Eingabe: n = 1, Ausgaben: 0 1 TESTFALL 2 Eingabe: n = 2, Ausgaben: 00 01 10 TESTFALL 3 Eingabe: n = 3, Ausgaben: 000 001 010 100 101

Ändern Sie Listing 4.4 dahingehend ab, dass für gegebenes n ∈ N genau die binären Strings der Länge n ohne aufeinanderfolgende Einsen ausgegeben werden. Beginnen Sie auch hier wieder mit dem leeren String und bauen Sie die gesuchten Strings rekursiv auf. Geben Sie

(Es wird eine leere Zeile (leerer String) ausgegeben.)

Programm 5.1: binäre Strings ohne 11 rekursiv ausgeben

## 5.1 Anzahl der binären Strings ohne 11

Sei n eine natürliche Zahl. Wir bezeichnen mit Ln die Menge aller binären Strings der Länge n, die nicht den Teilstring 11 enthalten, und setzen N(n) = |Ln|. Wir wollen N(n), also die Anzahl der Elemente in Ln, rekursiv bestimmen. Offensichtlich gilt N(0) = 1, denn nur der leere String hat die Länge 0 und dieser enthält nicht den Teilstring 11. Des Weiteren gilt N(1) = 2, da die Strings 0 und 1 beide nicht den Teilstring 11 enthalten.
EDIT Aufgabe 5.2
Vervollständigen Sie Tabelle 5.1.
n | N(n)
0 | 1
1 | 2
2 | 3
3 | 5
4
5
Tabelle 5.1: Tabelle für N(n)

Betrachten wir nun einen binären String w der Länge n + 1 mit n ≥ 1. Angenommen w liegt in Ln+1, dann enthält offensichtlich auch keiner der Teilstrings von w das Muster 11. Dann können wir w ∈ Ln+1 schreiben als

w = xab,
wobei x ∈ Ln−1 und a, b ∈ {0, 1}.
EDIT Aufgabe 5.3
Wir nehmen an, dass die Anzahlen N(n) und N(n − 1) für ein n mit n ≥ 1 bereits bekannt sind. Wir haben soeben begründet, dass wir w in Ln+1 schreiben können als

w = xab,
wobei x ∈ Ln−1 und a, b ∈ {0, 1}. Unterscheiden Sie zwei Fälle b = 0 und b = 1 für das Symbol b. Drücken Sie N(n + 1) durch N(n) und N(n − 1) aus.

## 5.2 Explizite und rekursive Darstellungen von Folgen

Wir betrachten die rekursiv definierte Folge

a0 = −1,

an+1 = an + 4.
Ein Folgenglied mit grösserem Index, wie zum Beispiel a5000, zu berechnen, ist recht mühsam. In dieser rekursiven Darstellung müssten für die Berechnung von a5000 nämlich alle Glieder a1, a2, . . . , a4999 zuerst bestimmt werden. Wie können wir späte Folgenglieder (mit hohen Indizes) effizienter berechnen? Die folgende Aufgabe 5.4 wird sich mit dieser Frage beschäftigen.

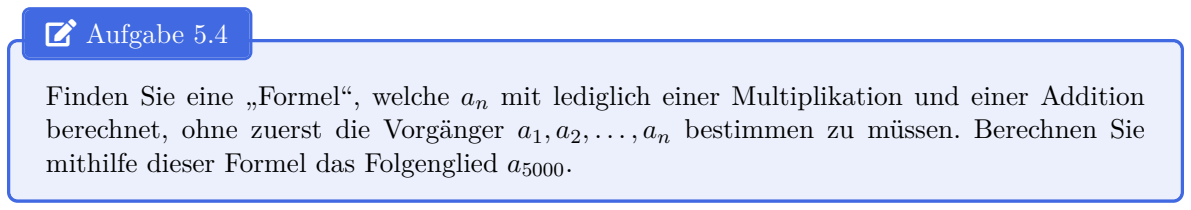
[picture p64: figure]
EDIT Aufgabe 5.4

Finden Sie eine „Formel“, welche an mit lediglich einer Multiplikation und einer Addition berechnet, ohne zuerst die Vorgänger a1, a2, . . . , an bestimmen zu müssen. Berechnen Sie mithilfe dieser Formel das Folgenglied a5000.

Die in Aufgabe 5.4 gefundene (nicht rekursive) Darstellung von an wird explizite Darstellung

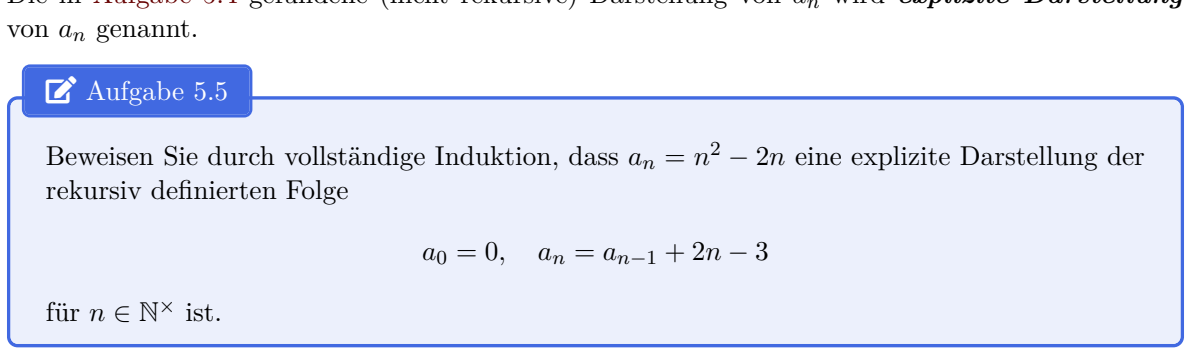
[picture p65: figure]
von an genannt.; EDIT Aufgabe 5.5; 2 − 2n eine explizite Darstellung der; rekursiv definierten Folge; für n ∈ N; × ist.

Beweisen Sie durch vollständige Induktion, dass an = n

Die rekursive Darstellung Gleichung (5.3) ist nicht geeignet, um N(n) für grosse Werte von n zu berechnen. Die Fibonacci-Folge wurde bereits im Jahr 1202 von Leonardo da Pisa verwendet, um das Wachstum einer Kaninchenpopulation zu beschreiben. Dennoch gelang es (höchstwahrscheinlich) erst in der ersten Hälfte des 18. Jahrhunderts, eine explizite Darstellung dieser wichtigen Folge zu finden. Diese Darstellung zu finden ist also alles andere als einfach. Diese explizite Darstellung ist als Formel von Moivre-Binet bekannt und besagt

F(n) = ϕ

n − (1 − ϕ)

n
√
5
, | (5.1)

wobei ϕ := 1+√
5
2
Gleichung (5.1) enthält die irrationale Zahl √
5. Ist es nicht erstaunlich, dass F(n) für alle n ∈ N eine natürliche Zahl ist? In der anspruchsvollen Aufgabe 5.7 haben Sie die Gelegenheit zu beweisen, dass die Formel von Moivre-Binet tatsächlich die Fibonacci-Zahlen berechnet (und somit ausschliesslich

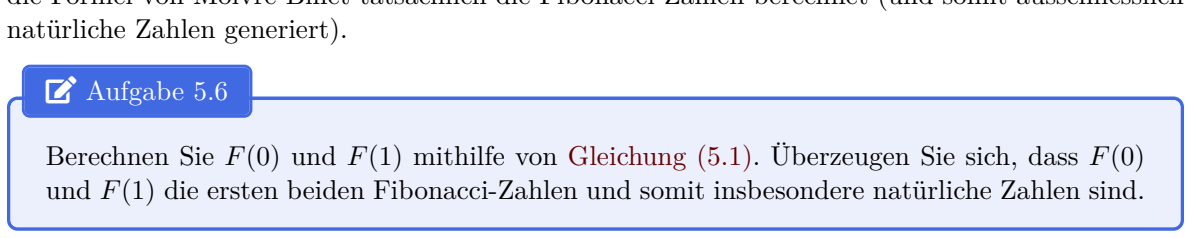
[picture p66: figure]
natürliche Zahlen generiert).; EDIT Aufgabe 5.6

Berechnen Sie F(0) und F(1) mithilfe von Gleichung (5.1). Überzeugen Sie sich, dass F(0) und F(1) die ersten beiden Fibonacci-Zahlen und somit insbesondere natürliche Zahlen sind.

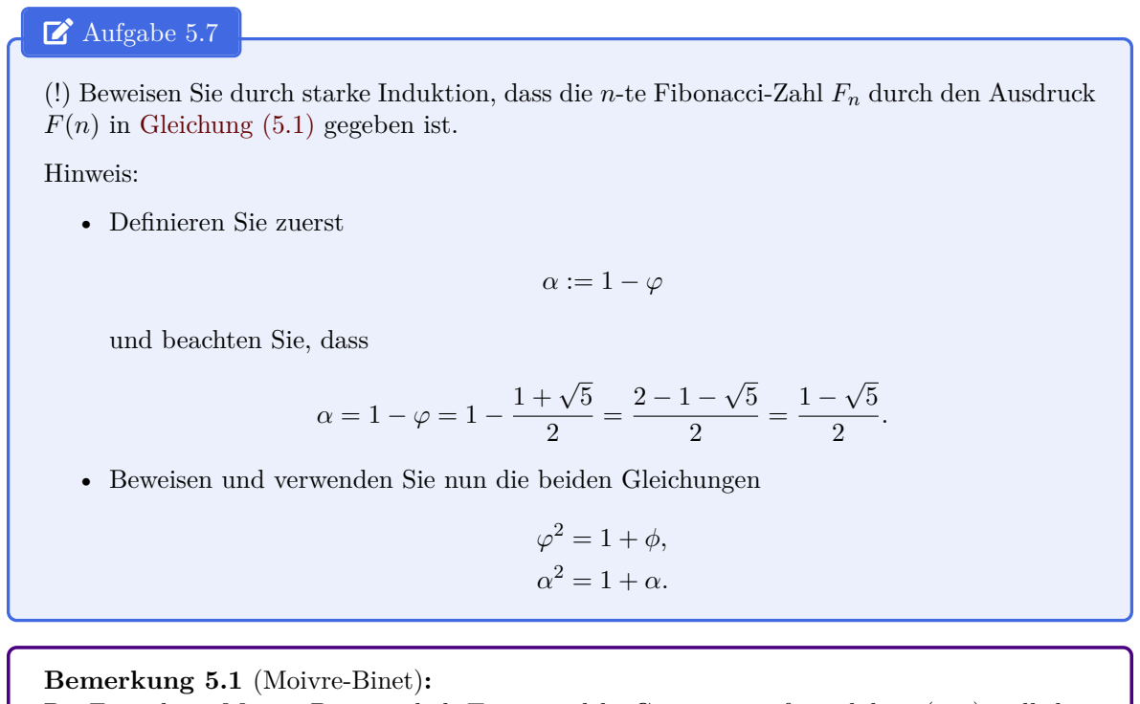
[picture p67: figure]
EDIT Aufgabe 5.7; F(n) in Gleichung (5.1) gegeben ist. Hinweis: • Definieren Sie zuerst; und beachten Sie, dass; Bemerkung 5.1 (Moivre-Binet):

(!) Beweisen Sie durch starke Induktion, dass die n-te Fibonacci-Zahl Fn durch den Ausdruck

- Beweisen und verwenden Sie nun die beiden Gleichungen

Die Formel von Moivre-Binet enthält Terme, welche Computer aufgrund ihrer (nur) endlichen Arithmetik nicht exakt darstellen können. Eine einfache Beobachtung macht die Formel aber auch für die Berechnung in endlicher Arithmetik gut zugänglich. Wir schreiben zuerst

F(n) = ϕ

n − (1 − ϕ)

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
(1 − ϕ)

n
√
5
Die Fibonacci-Zahl Fn unterscheidet sich von der Zahl ϕ
n
√
5

also lediglich um den Term (1−ϕ)

n
√
5
Doch wie gross ist dieser Term? Für den Exponenten n = 0 reduziert er sich auf

1
√
5

<

1
2
Für den Exponenten n = 1 reduziert sich der Term auf

1 − ϕ
√
5
Wegen |1 − ϕ| < 1 gilt

1 − ϕ
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
Was ändert sich aber, wenn wir allgemeine Exponenten n ∈ N zulassen? Tatsächlich gilt: Je grösser der Exponent ist, desto kleiner ist der Term! Aufgrund der Abschätzung |1 − ϕ| < 1 wissen wir nämlich, dass die geometrische Folge

(1 − ϕ)

n
√
5

=

1
√
5

|(1 − ϕ)

n
| =

1
√
5

|1 − ϕ|

n
strikt monoton fallend ist. Damit gilt also für alle natürlichen Exponenten n ∈ N

(1 − ϕ)

n
√
5

<

1
2

Wir haben somit nachgewiesen, dass

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
(1 − ϕ)

n
√
5
| | {z | }
| Fn

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
< Fn −

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
oder anders geschrieben:

Fn −

ϕ

n
√
5

<

1
2

Der Abstand von ϕ
n/

√
5 zu der ganzen Zahl Fn ist also kleiner als 1/2. Es liegt damit keine ganze Zahl so nahe bei ϕ
n/

√
5 wie Fn. Die n-te Fibonacci-Zahl Fn entspricht somit ϕ
n/

√
5,
gerundet auf die nächste ganze Zahl:

Fn =

ϕ

n
√
5
für alle n ∈ N. | (5.2)

Damit ist nun auch klar ersichtlich, dass die Fibonacci-Folge exponentiell wächst!

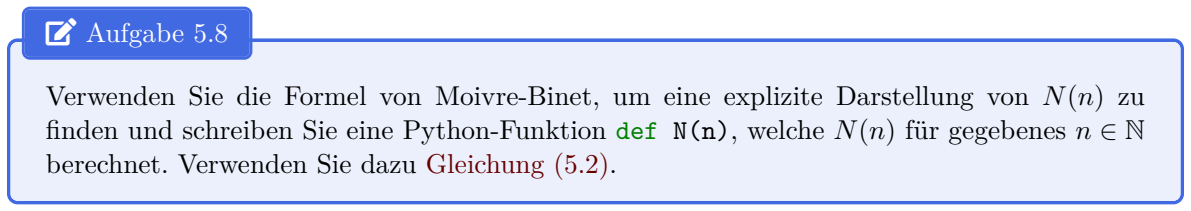
[picture p68: figure]
EDIT Aufgabe 5.8

Verwenden Sie die Formel von Moivre-Binet, um eine explizite Darstellung von N(n) zu finden und schreiben Sie eine Python-Funktion def N(n), welche N(n) für gegebenes n ∈ N berechnet. Verwenden Sie dazu Gleichung (5.2).

## 5.3 Lösungen der Aufgaben

Lösungsvorschlag zu Aufgabe 5.1
1 def print_binary_without_11(n, w = ''):
2 | if n == 0:
3 | print(w)
4 | return
5
6 | if len(w) == 0 or w[-1] != '1':
7 | print_binary_without_11(n-1, w + '0')
8 | print_binary_without_11(n-1, w + '1')
9 | else:
10 | print_binary_without_11(n-1, w + '0')
Programm 5.2: binäre Strings ohne 11 Lösungsvorschlag zu Aufgabe 5.2
n | N(n)
0 | 1
1 | 2
2 | 3
3 | 5
4 | 8
5 | 13
6 | 21
7 | 34
8 | 55
Tabelle 5.2: ausgefüllte Tabelle für N(n)

Lösungsvorschlag zu Aufgabe 5.3 Wir unterscheiden zwei mögliche Fälle für das Symbol b.
- Falls b = 0, dann hat w die Form w = xab = xa0. Da b = 0 ist, kann a sowohl 0 als auch 1 sein (es gibt keine Einschränkung für a). Dann hat also w die Form

w = xa
|{z}
=:y

0 = y0,

wobei y ein beliebiger String aus Ln sein darf, und Ln enthält N(n) Elemente.
- Falls b = 1, dann muss a = 0 gelten. Für x ist dann aber ein beliebiger String aus Ln−1 möglich und Ln−1 enthält N(n − 1) Elemente.
Da für b genau zwei Fälle möglich sind und diese Fälle keine „Überlappung“ aufweisen, können wir die jeweiligen Anzahlen addieren und erhalten die Gleichung
N(n + 1) = N(n) + N(n − 1). | (5.3)
Dies sieht aber genauso aus wie die rekursive Definition der Fibonacci-Folge! Aufgrund der bereits gefundenen Anfangsbedingungen N(0) = 1 und N(1) = 2 muss die gewöhnliche Fibonacci-Folge „verschoben“ werden und wir sehen

N(n) = F(n + 2).

Lösungsvorschlag zu Aufgabe 5.4 Wir bemerken, dass das nachfolgende Folgenglied um 4 grösser ist als sein Vorgänger. Damit ist an genau 4n grösser als a0 und wir erhalten

an = a0 + 4n = 4n − 1.

Nun finden wir a5000 = 4 · 5000 − 1 = 19999.
Lösungsvorschlag zu Aufgabe 5.5 Wegen a0 = 0² − 2 · 0 = 0 ist der Induktionsanfang gezeigt. Angenommen die Aussage gilt für n. Wir zeigen, dass sie auch für n + 1 gilt, dass also an+1 = (n + 1)² − 2(n + 1) = n

2 − 1. In der Tat ist

an+1 = an + 2(n + 1) − 3 = n

2 − 2n + 2(n + 1) − 3 = n

2 − 1.

Lösungsvorschlag zu Aufgabe 5.6 Wir berechnen

F(0) = ϕ

0 − α

0
√
5

= 0 = F0,

F(1) = ϕ

1 − α

1
√
5

=

ϕ − (1 − ϕ)
√
5

=

2ϕ − 1
√
5

=

1 + √
5 − 1
√
5

= 1 = F1.

Lösungsvorschlag zu Aufgabe 5.7 Wir beweisen zuerst die Gleichungen aus dem Hinweis:

ϕ

2 =

1 + √
5
2

!2
=

6 + 2√
5
4

= 1 +

1 + √
5
2

= 1 + ϕ,

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
6 − 2

√
5
4

= 1 +

1 −

√
5
2

= 1 + α.

In Aufgabe 5.6 haben wir bereits die Korrektheit der Aussage für n = 0 und n = 1 gezeigt. Sei nun die Aussage für ein n ∈ N

× wahr.

Fn+1

Definition von Fn+1 = | Fn + Fn−1 =

ϕ

n − α

n
√
5

+

ϕ

| n−1 − α n−1
√
| 5 =

ϕ

n + ϕ

n−1 −
α
| n + α n−1
√
5
| =

(ϕ + 1) ϕ

n−1 −
| (α + 1) α n−1
√
5

=

ϕ

2ϕ

n−1 − α
2α
| n−1
√
5
| =

ϕ

n+1 − α

n+1
√
5

=

| ϕ n+1 − (1 − ϕ)

n+1
√
| 5

= F(n + 1)

Lösungsvorschlag zu Aufgabe 5.8

Wir haben bereits festgestellt, dass

N(n) = F(n + 2) = ϕ

n+2 − (1 − ϕ)

n+2
√
5
mit ϕ := 1+√
5
2

gilt. Das entsprechende Programm lautet:

1 import math
2
3 def N(n):
4 | sqrt5 = math.sqrt(5)
5 | phi = (1 + sqrt5)/2
6 | return int(round(phi**(n+2)/sqrt5))

# Kapitel 6

# Sortieren (*)

Eines der häufigsten algorithmischen Probleme ist das Sortieren.

Definition 6.1 (Sortierproblem):
mydefinition:Sortierproblem Sei S eine Menge, deren Elemente durch die Relation ≤ verglichen werden können (≤ heisst dann totale Ordnung auf S). Das Sortierproblem lautet dann:
Eingabe: Eine endliche Folge von n ∈ N
× Elementen a1, a2, . . . , an aus S. Ausgabe: Eine Umordnung a
0/1, a⁰
2

, . . . , a⁰

n der Eingabe, sodass a
0
1 ≤ a

0
2 ≤ . . . ≤ a

0
n

(die
Elemente der Eingabe sind nun aufsteigend sortiert).

Abbildungen 6.1 und 6.2 zeigen zwei einfache Beispiele von Eingaben und entsprechenden Ausgaben des Sortierproblems.

3
2
0
3
9
8
1

Eingabe

0
1
2
3
3
8
9

Ausgabe

Abbildung 6.1: Eingabe und Ausgabe eines kleinen Sortierproblems mit ganzen Zahlen

r
e
a
o
n

Eingabe

a
e
n
o
r

Ausgabe

Abbildung 6.2: Eingabe und Ausgabe eines kleinen Sortierproblems mit Kleinbuchstaben des lateinischen Alphabets. Dabei wurde die übliche alphabetische Ordnung a ≤ b ≤ . . . ≤ z verwendet.

## 6.1 Sortieren mit dem merge sort Algorithmus

Natürlich ist das Bedürfnis nach schnellen Algorithmen besonders gross, falls diese Probleme lösen, die zeitkritisch sind und häufig auftreten. Mittlerweile sind viele Sortieralgorithmen bekannt. Ein berühmter Vertreter dieser Algorithmen ist merge sort. Der Algorithmus merge sort arbeitet rekursiv. Dabei macht er insbesondere von der Tatsache Gebrauch, dass sich zwei sortierte Listen recht effizient zu einer ebenfalls sortierten Liste zusammenfügen lassen. Es seien also zwei jeweils bereits sortierte Listen L und R gegeben. Diese Listen besitzen die Längen (Anzahl von Elementen) len
(L) und len(R). Es ist nun nicht besonders aufwändig, die beiden Listen L und R zu einer neuen sortierten Liste M der Länge len(L) + len(R) zu vereinen (englisch: to merge).
EDIT Aufgabe 6.1
Angenommen wir haben zwei jeweils bereits sortierte Listen L und R gegeben. Schreiben Sie eine Python-Funktion merge(L, R), welche L und R zu einer einzigen sortierten Liste vereint. Ihre Funktion soll unbedingt Gebrauch von der Tatsache machen, dass L und R bereits sortiert sind.

Testfall 0
Eingabe: L = [8, 12, 17], R = []
Ausgabe: [8, 12, 17]

Testfall 1
Eingabe: L = [2, 5, 13], R = [1, 2, 3, 7, 15, 20] Ausgabe: [1, 2, 2, 3, 5, 7, 13, 15, 20]

Testfall 2
Eingabe: L = [1,10,100,1000], R = [0,5,50]
Ausgabe: [0, 1, 5, 10, 50, 100, 1000]
Programm 6.1: Testfälle für die Funktion merge

Ihre Funktion braucht nicht zu überprüfen, ob L und R tatsächlich sortiert sind.

Analysieren Sie den Algorithmus, welchen Sie in Aufgabe 6.1 geschrieben haben. Welche Laufzeit hat dieser Algorithmus in Abhängigkeit von n = len(L) + len(R)?

Der merge sort Algorithmus teilt eine zu sortierende Liste rekursiv so lange in zwei Teile, bis nur noch Listen der Länge 1 vorliegen. Offensichtlich ist jede Liste der Länge 1 bereits sortiert. Schliesslich werden bereits sortierte Listen mithilfe des merge Algorithmus zu der gesuchten sortierten Liste zusammengefügt. Mithilfe der bereits in Aufgabe 6.1 erstellten Routine merge lässt sich der berühmte merge sort Algorithmus in nur wenigen Zeilen in Python beschreiben. Eine mögliche Implementation ist in Listing 6.2 gegeben.
1 def merge_sort(A):
# sortiert die Liste A

if len(A) == 1: # Rekursionsanfang
return A # Listen der Länge 1 sind schon sortiert.

# teile A in linke Hälfte und rechte Teile

if len(A) % 2 == 0: # falls len(A) gerade ist
middle = len(A) // 2
else: # falls len(A) ungerade ist
middle = (len(A) // 2) + 1
L = merge_sort(A[:middle])
R = merge_sort(A[middle:])
return merge(L, R)
Programm 6.2: Implementation der Funktion merge_sort

Den merge sort Algorithmus zu verstehen ist nicht einfach! Erfahrungsgemäss ist es sehr hilfreich, die einzelnen Schritte dieses Sortieralgorithmus für ein kleines Beispiel durchzugehen. Dazu haben wir die Schritte von merge sort (ms) beim Sortieren der Liste [3,2,1] in Abbildung 6.3 schematisch dargestellt. Mit m wird natürlich der Algorithmus merge bezeichnet. Die schematische Darstellung ist analog zu den Ausführungen in Abschnitt 4.5 zu verstehen.

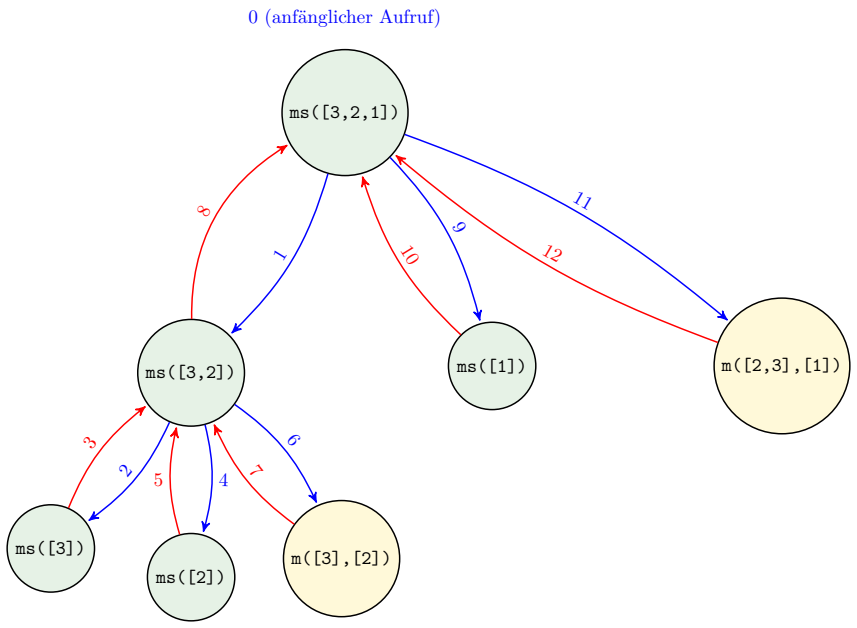
[picture p69: figure]
0 (anfänglicher Aufruf)

Abbildung 6.3: schematische Darstellung der Arbeitsschritte von merge sort

## 6.2 Analyse der Laufzeit von merge sort

Beachten Sie, dass der in Listing 6.2 gegebene Algorithmus durchaus in der Lage ist, Listen beliebiger Längen n ∈ N zu sortieren. Für die nachfolgenden Untersuchungen wollen wir aber annehmen, dass die Problemgrösse n stets eine Zweierpotenz ist, also n = 2k

für ein k ∈ N. Ohne diese Vereinfachungen werden in den Untersuchungen diverse Auf- und Abrundeoperationen notwendig sein und die Darstellung wird technischer und weniger instruktiv. Zusätzlich möchten wir den trivialen Fall n = 0 als Problemgrösse ausschliessen. Die folgenden Betrachtungen sind inspiriert durch die entsprechenden Abschnitte in dem herausragenden Buch [9].
Die Laufzeit des merge sort Algorithmus setzt sich aus drei einzelnen Teilen zusammen:
Divide: Dieser Teil berechnet lediglich die Mitte der zu sortierenden Liste. Dazu ist offensichtlich nur eine konstante Zeit Θ(1) notwendig.
Conquer: Beim Aufruf des merge sort Algorithmus mit Problemgrösse n werden rekursiv zwei Teilprobleme (derselben Art) mit jeweils halber Grösse n/2 aufgerufen. Dies trägt 2T(n/2) zur Laufzeit bei.
Combine: Wie wir in Aufgabe 6.2 bereits festgestellt haben, benötigt merge sort die lineare Zeit Θ(n) für die Vereinigung zweier Listen mit summierter Länge n = len(L) + len(R). Zusammengefasst ist die Laufzeit T(n) von merge sort im schlimmsten Fall also gegeben durch

T(n) = (

Θ(1), | falls n = 1,
2T(n/2) + Θ(n), falls n ≥ 2.

(6.1)

Gleichung (6.1) lässt sich natürlich schreiben als

T(n) = (

c0, | falls n = 1,
2T(n/2) + c1n, falls n ≥ 2.

(6.2)

Diesen Ausdruck können wir mit der Definition c := max {c0, c1} sogar nochmals vereinfachen zu

T(n) = (

c, | falls n = 1,
2T(n/2) + cn, falls n ≥ 2,

(6.3)

da wir uns im Moment lediglich für eine obere Schranke für die Laufzeit T(n) interessieren. Beachten Sie, dass Gleichung (6.3) die Funktion T (Laufzeit) rekursiv definiert.
Wir wollen nun die eindeutige Lösung von Gleichung (6.3) durch intuitive Überlegungen finden. Betrachten Sie Abbildung 6.4.
- In der obersten „Etage“ fallen die Kosten cn für den merge zu einer Liste der Länge n an.
- In der zweitobersten „Etage“ fallen die Kosten cn/2 + cn/2 = cn für zwei merges zu Listen der Längen n/2 an.
- Dies geht rekursiv so weiter.
- In der untersten „Etage“ wird überall der Rekursionsanfang erreicht und wir haben n-mal die Kosten T(1) = c, also cn.
Diese Überlegung zeigt, dass jede „Etage“ genau cn zu den Gesamtkosten von merge sort beiträgt. Nun stellt sich lediglich noch die Frage, wie viele „Etagen“ der Baum in Abbildung 6.4 hat. Diese Frage ist aber mit der Frage verwandt, wie häufig eine Zweierpotenz 2

k halbiert werden muss, bis das

Resultat der Division durch 2 identisch zu 1 ist. Dies ist aber genau das, was uns der Logarithmus zur Basis zwei beantwortet. Der Faktor 2 ist
log2
(n) = log2
2

k

= k
Male in n enthalten. Das ist die Anzahl Teilungen. Der Baum hat somit log2
(n) + 1 viele „Etagen“.
Die Laufzeit von merge sort ist also

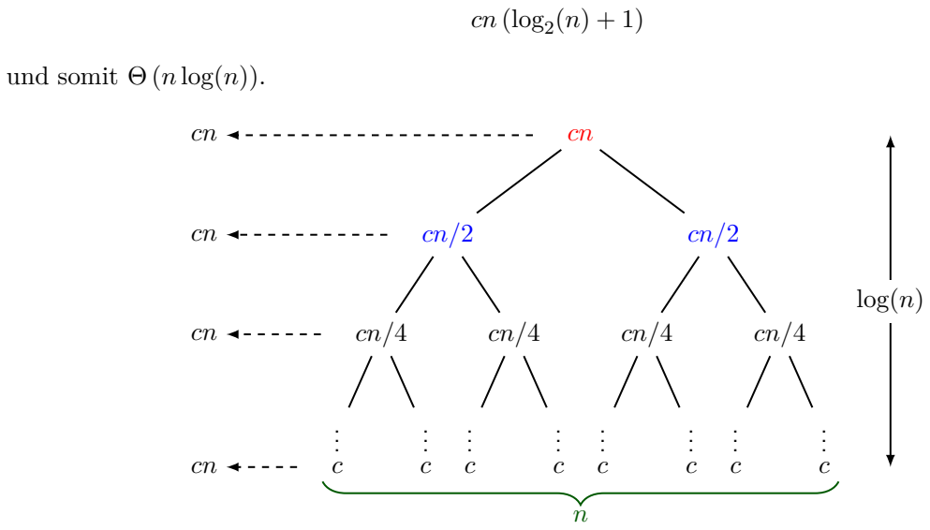
[picture p70: figure]
cn (log2; und somit Θ (n log(n)).; log(n)

Abbildung 6.4: Laufzeitanalyse von merge sort

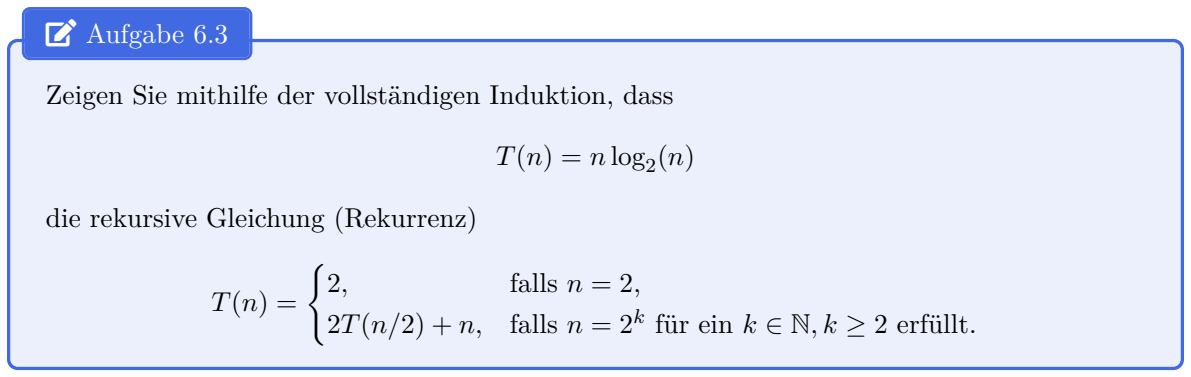
[picture p71: figure]
EDIT Aufgabe 6.3; T(n) = n log2; die rekursive Gleichung (Rekurrenz); falls n = 2,; 2T(n/2) + n, falls n = 2k; für ein k ∈ N, k ≥ 2 erfüllt.

Zeigen Sie mithilfe der vollständigen Induktion, dass

## 6.3 Lösungen der Aufgaben

Lösungsvorschlag zu Aufgabe 6.1

1 def merge(L,R):
# L und R sind jeweils bereits sortierte Listen.

# M wird am Ende len(L) + len(R) viele Elemente haben # und eine sortierte Liste sein.

M = [] # M ist zu Beginn eine leere Liste.

l = 0 # Laufindex innerhalb der Liste L
r = 0 # Laufindex innerhalb der Liste R

# solange weder L noch R vollständig durchlaufen wurden while (l < len(L)) and (r < len(R)):

if L[l] <= R[r]:
M.append(L[l])
l = l + 1
else:
M.append(R[r])
r = r + 1

while l < len(L):
M.append(L[l])
l = l + 1
while r < len(R):
M.append(R[r])
r = r + 1
return M
Programm 6.3: Implementation der Funktion merge

Lösungsvorschlag zu Aufgabe 6.2 Wir beziehen uns hier auf den Algorithmus in der Musterlösung zu Aufgabe 6.1. Der Algorithmus besteht im Wesentlichen in einer Schleife über die summierte Länge
n = len(L) + len(R)
der beiden gegebenen Listen. Somit ist die Laufzeit gegeben durch Θ(n).
Lösungsvorschlag zu Aufgabe 6.3 Sei also T(n) := n log2

(n). Es ist zu zeigen, dass diese Wahl von T die Rekurrenz in der Aufgabenstellung erfüllt. Wir untersuchen den Fall T(2) = T
2

1

separat. Wegen 2 log2

(2) = 2 ist die
Behauptung für T
2

1

korrekt. Nun zeigen wir durch Induktion, dass für alle k ∈ N mit k ≥ 2 die Aussage

A(k) : ⇐⇒ T

2

k

= 2T
2

k−1

+ 2k
korrekt ist. Mit den Logarithmengesetzen finden wir

T

2

2

= 2²

log2
2

2

= 2²

(log2

(2) + log2

(2)) = 2 · 2 log2
(2) + 2² = 2T
2

1

+ 2² und damit ist A(2) gezeigt. Sei A(n) nun für ein n ∈ N mit n ≥ 2 wahr, dann finden wir

T

2

k+1
=

2

k+1 log2

2

k+1
=

2

k+1
log2
2

k

+ log2

(2)
=

2 · 2

k

log2

2

k

+ 2k+1 =

2T

2

k

+ 2k+1
Dies zeigt den Induktionsschritt.

# Kapitel 7

# Sudoku und Backtracking (*)

Sudokus sind Rätsel, welche sich seit den frühen 2000er Jahren international grosser Beliebtheit erfreuen. Seit vielen Jahren gibt es Sudoku-Apps und man findet Sudokus auch oft abgedruckt in Zeitschriften und Gratiszeitungen. Eines der zentralen Ziele dieses Kapitels wird sein, einen rekursiven Lösungsalgorithmus für Sudokus zu entwickeln. Zuerst müssen wir kurz erklären, was Sudokus überhaupt sind und wie die Spielregeln aussehen.

## 7.1 Spielregeln

Die Spielregeln für Sudokus lassen sich ganz einfach erklären. Wir illustrieren sie anhand eines konkreten (sehr schwierigen) Sudokus. Ein Sudoku besteht immer aus einem 9 × 9-Gitter. In Abbildung 7.1 ist links das noch ungelöste Sudoku gezeigt und rechts das gelöste (ausgefüllte). Bei einem Sudoku sind zu Beginn einige Zahlen (Felder) vorgegeben. Diese, zu Beginn vorgegebenen Zahlen, dürfen nicht geändert werden. Das Sudoku ist gelöst, wenn jedes der 81 Felder genau eine der 9 Ziffern 1, 2, . . . , 9 enthält und zusätzlich die folgenden zwei Bedingungen erfüllt sind:
1. In jeder Zeile und jeder Spalte muss jede der 9 Ziffern 1, 2, . . . , 9 genau einmal vorkommen.
2. Beachten Sie, dass das 9×9-Gitter (siehe die fetten Linien) wiederum in 9 verschiedene 3×3-Blöcke aufgeteilt ist. In jedem dieser 3 × 3-Blöcke müssen ebenfalls alle 9 Ziffern 1, 2, . . . , 9 genau einmal vorkommen.
7 | 3 | 9 | 2
8
9 | 4 | 3 | 7
6 | 9
3 | 5 | 2 | 7
8 | 4
4 | 8
2 | 6
1 | 2 | 9
ungelöstes Sudoku Nr. 0
7 | 3 | 9 | 2
8
9 | 4 | 3 | 7
6 | 9
3 | 5 | 2 | 7
8 | 4
4 | 8
2 | 6
1 | 2 | 9
gelöstes Sudoku Nr. 0
8 | 1 | 4 | 5 | 6
5 | 2 | 6 | 7 | 9 | 3 | 1 | 4
1 | 6 | 2 | 5 | 8
1 | 3 | 8 | 4 | 2 | 7 | 5
| 8 | 4 | | | 6 | 9 | 1
7 | 5 | 2 | 9 | 1 | 6 | 3
1 | 3 | 9 | 2 | 7 | 5 | 6
5 | 7 | 9 | 1 | 4 | 3 | 8
4 | 7 | 8 | 6 | 3 | 5

Abbildung 7.1: Sudoku Nr. 0

Normale 9 × 9-Sudokus sind mit ihren 81 Feldern recht gross und für didaktische Betrachtungen eher unhandlich. Wir werden deshalb zuerst kleinere Sudokus der Grösse 4 × 4 untersuchen. Lassen

Sie uns zunächst die Regeln für Sudokus für allgemeine Dimensionen festhalten.

Bemerkung 7.1 (Spielregeln des (verallgemeinerten) Sudokus): myremark:Regeln Ein (verallgemeinertes) Sudoku ist ein n
2 × n

2

-Gitter, wobei n eine natürliche Zahl ist. Bei einem Sudoku sind zu Beginn einige Zahlen (Felder) vorgegeben. Diese zu Beginn vorgegebenen Zahlen dürfen nicht geändert werden. Das Sudoku ist gelöst, wenn jedes der n
2
- n

2 = n

4 Felder genau eine der Ziffern 1, 2, . . . , n⁴

enthält und zusätzlich die folgenden zwei Bedingungen erfüllt sind:
1. In jeder Zeile und in jeder Spalte muss jede der n

2 Ziffern 1, 2, . . . , n² genau einmal vorkommen.
2. Beachten Sie, dass das n
2 ×n

2

-Gitter (siehe die fetten Linien) wiederum in n

2 verschiedene n × n-Blöcke aufgeteilt ist. In jedem dieser n × n-Blöcke müssen ebenfalls alle n
2
Ziffern 1, 2, . . . , n² genau einmal vorkommen.

Das übliche Sudoku (mit 81 Feldern) erhalten wir für n = 3. Wir werden zunächst kleine Sudokus mit n = 2, also mit nur 2

4 = 16 Feldern anschauen.
EDIT Aufgabe 7.1
Finden Sie die (eindeutige) Lösung des Sudokus in Abbildung 7.2. Dieses Sudoku wird als einfach eingestuft.
| 9 | 5 | | | | | 7
| 7 | | 1 | 2 | | 8
| 2 | 4 | 6 | 7 | | 3 | 9 | 1
| | | | | 1 | 2 | 5 | 3
| 1 | | 3 | | 4 | | | 9
7 | 3 | 9 | 8 | | | | | 4
| | | 9 | 8 | 6
| | | | 4 | | | 1 | 6
2 | 4
ungelöstes Sudoku Nr. 2
Abbildung 7.2: Sudoku Nr. 2

## 7.2 Sudokus können mehr als eine Lösung haben!

Betrachten Sie nochmals Abbildung 7.1 und vergewissern Sie sich, dass die Lösung auf der rechten Seite tatsächlich alle geforderten Bedingungen erfüllt. Sudoku Nr. 0 erlaubt übrigens nur diese eine Lösung. Die in Zeitschriften und Sudoku-Apps aufgeführten Sudokus sind meist absichtlich so konstruiert, dass sie eine eindeutige Lösung besitzen. Entfernen wir aber beispielsweise die 9 in der rechten unteren Ecke von Sudoku Nr. 0, so erhalten wir ein neues Rätsel:

7 | 3 | 9 | 2
8
9 | 4 | 3 | 7
6 | 9
3 | 5 | 2 | 7
8 | 4
4 | 8
2 | 6
1 | 2
ungelöstes Sudoku Nr. 1
7 | 3 | 9 | 2
8
9 | 4 | 3 | 7
6 | 9
3 | 5 | 2 | 7
8 | 4
4 | 8
2 | 6
1 | 2
gelöstes Sudoku Nr. 1
8 | 1 | 4 | 5 | 6
5 | 2 | 6 | 7 | 9 | 4 | 3 | 1
6 | 1 | 2 | 5 | 8
1 | 3 | 8 | 4 | 2 | 7 | 5
| 8 | 4 | | | 6 | 1 | 9
7 | 5 | 2 | 1 | 9 | 6 | 3
1 | 7 | 5 | 2 | 3 | 9 | 6
8 | 9 | 3 | 1 | 7 | 5 | 4
4 | 3 | 9 | 7 | 6 | 5 | 8

Abbildung 7.3: Sudoku Nr. 1

Sudoku Nr. 1 besitzt ebenfalls die Lösung, welche bereits Lösung von Sudoku Nr. 0 war (siehe Abbildung 7.1). Neben dieser Lösung besitzt Sudoku Nr. 1 aber noch weitere Lösungen. Eine davon ist rechts in Abbildung 7.3 gezeigt.
In Abbildung 7.4 ist ein Beispiel eines 4 × 4-Sudokus („Mini-Sudoku“) gegeben. Dieses besitzt übrigens 4 verschiedene Lösungen.
1

3 2
3
ungelöstes Mini-Sudoku Nr. 0

1

3 | 2
| | | 3
eine Lösung des Mini-Sudokus Nr. 0
| | 2 | 4 | 3
3 | 4 | 2 | 1
| | 4 | 1
1 | 2 | 4

Abbildung 7.4: Mini-Sudoku Nr. 0

Finden Sie die drei weiteren Lösungen des Sudokus in Abbildung 7.4.

## 7.3 Darstellung von Sudokus in Python

In Python können wir ein Sudoku durch eine „zweidimensionale“ Liste (oder Array) angeben. Beispielsweise kann Sudoku Nr. 2 aus Aufgabe 7.1 in der folgenden Form in Python gespeichert werden:

sudokuNo2 = [
[0,9,5,0,0,0,0,7,0],
[0,7,0,1,2,0,8,0,0],
[0,2,4,6,7,0,3,9,1],
[0,0,0,0,0,1,2,5,3],
[0,1,0,3,0,4,0,0,9],
[7,3,9,8,0,0,0,0,4],
[0,0,0,9,8,6,0,0,0],
[0,0,0,0,4,0,0,1,6],
[2,4,0,0,0,0,0,0,0]
]
Programm 7.1: Abspeichern von Sudoku-Gittern in Python

Das Mini-Sudoku in Abbildung 7.4 kann folgendermassen in Python abgespeichert werden:

mini_sudokuNo0 = [
[0,1,0,0],
[0,0,0,0],
[0,3,0,2],
[0,0,3,0]
]
Programm 7.2: Abspeichern von Mini-Sudoku-Gittern in Python

Um ein n
2×n

2

-Gitter ansehnlich in Python auszugeben („pretty-print“), empfehlen wir, am Anfang des Programms die Bibliothek numpy durch den Befehl import numpy as np einzubinden. Danach kann das Gitter durch print(np.array(gitter)) übersichtlich ausgegeben werden.

## 7.4 Erlaubte Felder

In Abbildung 7.5 ist nochmals das Sudoku vom Anfang des Kapitels gezeigt. Betrachten Sie das mit einem blauen Fragezeichen ? markierte Feld. Wir wissen (aufgrund der Eindeutigkeit der Lösung dieses konkreten Sudokus), dass in das markierte Feld die Ziffer 8 gesetzt werden muss. Nach den Spielregeln von Sudoku würde jedoch im Moment nichts dagegen sprechen, eine 1 in dieses Feld zu schreiben — auch wenn sich diese Wahl im Verlauf des Spiels als falsch herausstellen wird. Wir sagen, dass die Wahl der Ziffer 1 für das blau markierte Feld (bei dem aktuellen Spielstand) erlaubt ist. Die Wahl der Ziffer 6 ist beispielsweise nicht erlaubt, da diese Ziffer in der entsprechenden Zeile bereits vorkommt. Ebenso wäre die Wahl der Ziffer 5 nicht erlaubt, da diese Ziffer bereits im entsprechenden 3 × 3-Block enthalten ist.
Es sei also ein konkretes Gitter gegeben. Wir sagen, dass das Setzen einer Ziffer Z auf ein leeres (unbesetztes) Feld F des Gitters erlaubt ist, falls diese Ziffer Z weder in der entsprechenden Zeile noch der Spalte noch dem entsprechenden n × n-Block von F in dem gegebenen Gitter vorkommt.
7 | 3 | 9 | 2
8
9 | 4 | 3 | 7
6 | 9 | ?
3 | 5 | 2 | 7
8 | 4
4 | 8
2 | 6
1 | 2 | 9
ungelöstes Sudoku Nr. 0
7 | 3 | 9 | 2
8
9 | 4 | 3 | 7
6 | 9
3 | 5 | 2 | 7
8 | 4
4 | 8
2 | 6
1 | 2 | 9
gelöstes Sudoku Nr. 0
8 | 1 | 4 | 5 | 6
5 | 2 | 6 | 7 | 9 | 3 | 1 | 4
1 | 6 | 2 | 5 | 8
1 | 3 | 8 | 4 | 2 | 7 | 5
| 8 | 4 | | | 6 | 9 | 1
7 | 5 | 2 | 9 | 1 | 6 | 3
1 | 3 | 9 | 2 | 7 | 5 | 6
5 | 7 | 9 | 1 | 4 | 3 | 8
4 | 7 | 8 | 6 | 3 | 5

Abbildung 7.5: nochmals Sudoku Nr. 2

EDIT Aufgabe 7.3
Wir befassen uns in dieser Aufgabe nur mit 4 × 4-Gittern. Entwickeln Sie eine Python-Funktion
def erlaubt(zeile, spalte, ziffer, gitter), welche für ein gegebenes noch leeres (markiert durch die Zahl 0) Feld mit Zeilenindex zeile (von 0 bis 3) und Spaltenindex spalte (von 0 bis 3) prüft, ob das Platzieren einer gegebenen Ziffer ziffer (von 1 bis 4) in einem gegebenen Gitter erlaubt ist. Hier sind einige Testfälle:

print(erlaubt(0,3,4,mini_sudokuNo0)) # True

print(erlaubt(1,0,1,mini_sudokuNo0)) # False
# (bereits eine 1 in dem ersten 4x4 Block)

print(erlaubt(1,1,3,mini_sudokuNo0)) # False
# (bereits eine 3 in der entsprechenden Spalte)

Programm 7.3: erlaubt oder nicht

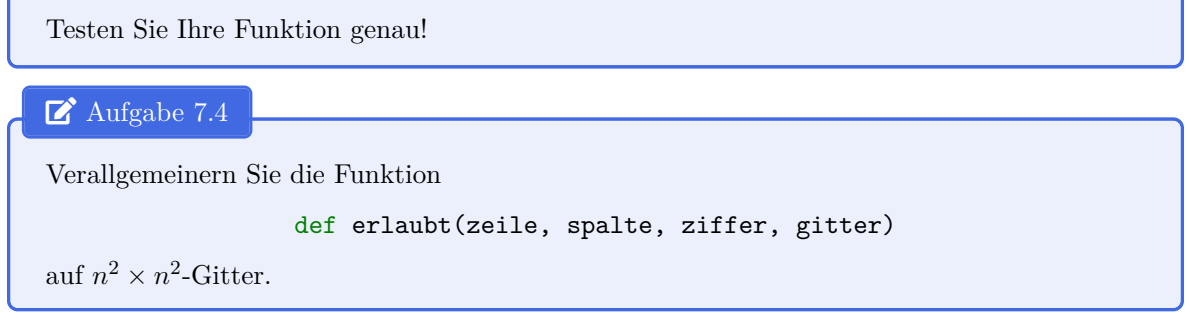
[picture p72: figure]
Testen Sie Ihre Funktion genau!; EDIT Aufgabe 7.4; Verallgemeinern Sie die Funktion def erlaubt(zeile, spalte, ziffer, gitter); auf n; -Gitter.

## 7.5 Backtracking

Wir wollen uns nun an die Entwicklung eines rekursiven Algorithmus zum Lösen von Sudokus herantasten. Dazu beginnen wir mit der einführenden Aufgabe 7.5, in der Sie einige gedankliche Vorarbeiten leisten.
EDIT Aufgabe 7.5
Betrachten Sie das folgende Sudoku.
| 3
| 1 | | 4
3 | | 1
(a) Füllen Sie die noch leeren Felder Zeile für Zeile von links nach rechts und von oben nach unten aus. Beginnen Sie also mit dem Feld mit den Koordinaten (0, 0) (oben links) und beenden Sie Ihre Arbeit mit dem Feld (3, 3) (unten rechts). Zeichnen Sie dabei die einzelnen „Stationen“ (Gitter) auf, indem Sie das Diagramm in Abbildung 7.6 systematisch vervollständigen.
(b) Warum ist unser Vorgehen in Teil (a) für das gegebene Sudoku suboptimal? Schlagen Sie eine effizientere Strategie vor.
| 3
| 1 | | 4
3 | | 1
2 | 3
1 | 4
3 | 1
4 | 3
1 | 4
3 | 1
Abbildung 7.6: einzelne Stationen

Nun wollen wir die in Aufgabe 7.5 gemachten Beobachtungen etwas vertiefen. Betrachten Sie dazu das neue Mini-Sudoku in Abbildung 7.7.
4
4 | 1
3 | ?
2
ungelöstes Mini-Sudoku Nr. 1

4
4 1
3
2
Lösung des Mini-Sudoku Nr. 1
1 | 3 | 2
2 | 3
1 | 2 | 4
4 | 1 | 3

Abbildung 7.7: Mini-Sudoku Nr. 1

Beim Lösen eines Sudokus dürfen wir die Reihenfolge, in der wir die (noch) leeren Felder auffüllen, beliebig wählen. Um ganz konkret ein mögliches Vorgehen zu untersuchen, nehmen wir an, dass wir die 11 leeren Felder des Sudokus in Abbildung 7.7 in der Reihenfolge

(2, 3) → (3, 3) → (0, 3) → (1, 2) → (1, 0) → (2, 2) → (3, 2) → (2, 1) → (3, 0) → (0, 0) → (0, 1)
auszufüllen versuchen.
Wir betrachten also zuerst das leere Feld mit den Koordinaten (2, 3), welches mit einem blauen Fragezeichen ? markiert ist. Sie werden schnell erkennen, dass in diesem leeren Feld genau das Setzen der beiden Ziffern 2 und 4 erlaubt ist. Wir stehen hier also vor einer Wahl. Die Situation ist in Abbildung 7.8 dargestellt. Die Wahl der Ziffer 2 führt uns zu Station (1). Hier haben wir für das Feld (3, 3) ebenfalls eine Wahl, und zwar zwischen den Ziffern 3 und 4. Die Wahl der Ziffer 3 führt uns zu Station (2). Bei Station (3) stellen wir fest, dass für das leere Feld (0, 3) keine der vier Ziffern gesetzt werden darf. Somit sind wir in eine Sackgasse geraten. Mindestens an einer „Abzweigung“ müssen wir also eine falsche Wahl getroffen haben! Wir gehen deshalb so weit den „Pfad“ entlang zurück, bis wir zur jüngst angetroffenen Abzweigung gelangen. Dies war in diesem Fall die Station (1). Nun folgen wir von Station (1) aus der Wahl der Ziffer 4 zu Station (4). Bei Station (7) erkennen wir, dass auch die zweite Wahl (die der Ziffer 4) bei Station (1) uns nicht weiterbringt. Erst jetzt können wir sicher sein, dass die ursprüngliche Wahl der Ziffer 2 bei Station (0) falsch gewesen war. Dies führt uns zur korrekten Wahl der Ziffer 4 für das Feld (2, 3) und somit zu Station (8).
Der Vorgang des „Zurückgehens“ entlang der gegangenen Wege wird Backtracking genannt. Im nächsten Abschnitt werden wir einen eleganten Algorithmus vorstellen, welcher mithilfe von Backtracking auf rekursive Weise die Lösungen eines Sudokus findet.

(0)
| | 4
| 4 | | 1
3
| 2

(1)
4
4 | 1
3 | 2
2

(8)
4
4 | 1
3 | 4
2

(9)
4
4 | 1
3 | 4
2 | 3

(10)
4 | 2
4 | 1
3 | 4
2 | 3

(11)
4 | 2
4 | 3 | 1
3 | 4
2 | 3

(12)
4 | 2
2 | 4 | 3 | 1
3 | 4
2 | 3

(13)
4 | 2
2 | 4 | 3 | 1
3 | 1 | 4
2 | 3

(15)
4 | 2
2 | 4 | 3 | 1
3 | 2 | 4
2 | 3

(14)
4 | 2
2 | 4 | 3 | 1
3 | 1 | 4
2 | × | 3

(16)
4 | 2
2 | 4 | 3 | 1
3 | 2 | 4
2 | 1 | 3

(2)
4
4 | 1
3 | 2
2 | 3

(3)
4 | ×
4 | 1
3 | 2
2 | 3

(4)
4
| 4 | | 1
3 | | | 2
| 2 | | 4

(5)
| | 4 | 3
| 4 | | 1
3 | | | 2
| 2 | | 4

(6)
| | 4 | 3
| 4 | 2 | 1
3 | | | 2
| 2 | | 4

(7)
| | 4 | 3
× | 4 | 2 | 1
3 | | | 2
| 2 | | 4

(20)
1 | 3 | 4 | 2
2 | 4 | 3 | 1
3 | 1 | 2 | 4
4 | 2 | 1 | 3
Abbildung 7.8: Visualisierung von Backtracking bei Sudoku

Bemerkung 7.2 (Backtracking in einem Labyrinth):
Die Situation beim Backtracking in Sudokus kann vage mit der (rekursiven) Suche eines Ausgangs (oder aller Ausgänge) aus einem Labyrinth verglichen werden. Wir suchen, beginnend bei Start, einen der Ausgänge aus einem Labyrinth. Dazu gehen wir so lange die Gänge entlang, bis wir entweder herausgefunden haben oder in einer Sackgasse angelangt sind. In Abbildung 7.9 ist die Situation veranschaulicht. Der Weg Start → 0 → 1 ist eine Sackgasse. Wir gehen darum einen Gang zurück (also zu 0). Von 0 aus gibt es keine weitere Abzweigung und wir gehen nochmals einen Gang zurück, also zum Start. Nun gehen wir den neuen Weg Start → 2 → 3 → 4. Doch auch 4 ist eine Sackgasse. Deshalb gehen wir einen Gang zurück zu 2. Von 2 aus nehmen wir den neuen Weg 2 → 5 → 6 und haben einen Ausgang gefunden. Diesen gefundenen Weg Start → 2 → 5 → 6 können wir als Lösung ausgeben. Falls wir (wie beim Sudoku) alle Lösungen (Ausgänge) finden wollen, würden wir hier nicht bereits abbrechen, sondern (rekursiv) weitersuchen.
Start

0

1 (S)

2

3

4 (S)

5

6 (A)

7

8

9 (S)

10

11 (A)
Abbildung 7.9: Navigation in einem Labyrinth

## 7.6 Lösungsalgorithmus für Sudoku

Unser Lösungsalgorithmus verwendet die Funktion erlaubt sowie Backtracking in Kombination mit Rekursion. Diese drei Komponenten sind Ihnen inzwischen bekannt. Der vollständige Algorithmus zum Lösen von Sudokus ist in Listing 7.5 gegeben. Mit der Definition

sudokuNo0 = [
[0,0,7,0,0,3,9,0,2],
[0,0,0,8,0,0,0,0,0],
[9,4,3,0,0,0,0,0,7],
[6,9,0,0,0,0,0,0,0],
[3,0,0,5,2,7,0,0,0],
[0,0,0,0,0,0,8,4,0],
[0,0,0,0,4,8,0,0,0],
[2,6,0,0,0,0,0,0,0],
[0,0,0,0,0,0,1,2,9]
]
Programm 7.4: Abspeichern von Sudoku-Gittern in Python

wird Ihnen der Aufruf sudoku(sudokuNo0) alle (es gibt hier nur eine) Lösungen von Sudoku Nr. 0 ausgeben. Die Funktion in Listing 7.5 verwendet die Funktion erlaubt, welche Sie in Aufgabe 7.4 geschrieben haben.
1 def sudoku(gitter):
# Gehe durch alle Felder im Gitter.

for zeile in range(9):
for spalte in range(9):
# Schaue, ob das Feld noch leer ist. if gitter[zeile][spalte] == 0:

# leeres Feld gefunden

# Gehe durch alle 10 Ziffern 1 bis 9.

for ziffer in range(1,10):
# Prüfe, ob die Ziffer für dieses Feld erlaubt ist. if erlaubt(zeile,spalte,ziffer,gitter):

# Die betrachtete Ziffer ist erlaubt.

# Schreibe diese Ziffer in das Feld. gitter[zeile][spalte] = ziffer

# Die Ziffer wurde ins Gitter geschrieben. # Arbeite nun rekrusiv mit dem

# neuen Gitter weiter.

sudoku(gitter)

# Entferne die gesetzte Ziffer wieder. gitter[zeile][spalte] = 0

# leeres Feld, für welches keine Ziffer passt # => Sackgasse gefunden => Backtracking return

# gültige Lösung gefunden

print(np.array(gitter))

31 return
Programm 7.5: Implementation der Funktion sudoku

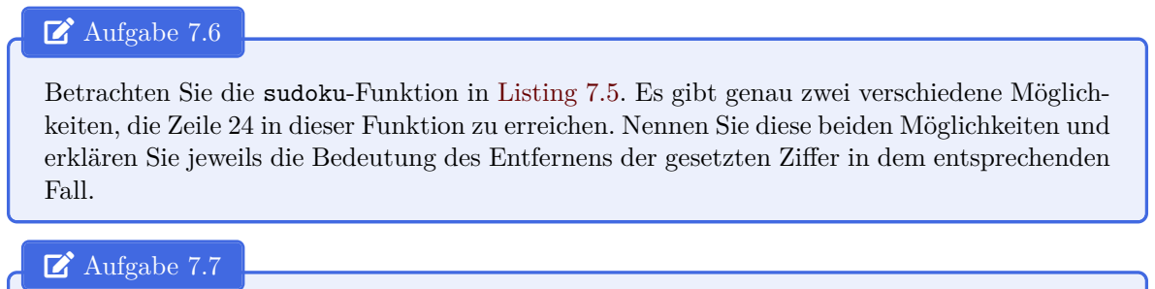
[picture p73: figure]
EDIT Aufgabe 7.6; Fall.; EDIT Aufgabe 7.7

Betrachten Sie die sudoku-Funktion in Listing 7.5. Es gibt genau zwei verschiedene Möglichkeiten, die Zeile 24 in dieser Funktion zu erreichen. Nennen Sie diese beiden Möglichkeiten und erklären Sie jeweils die Bedeutung des Entfernens der gesetzten Ziffer in dem entsprechenden

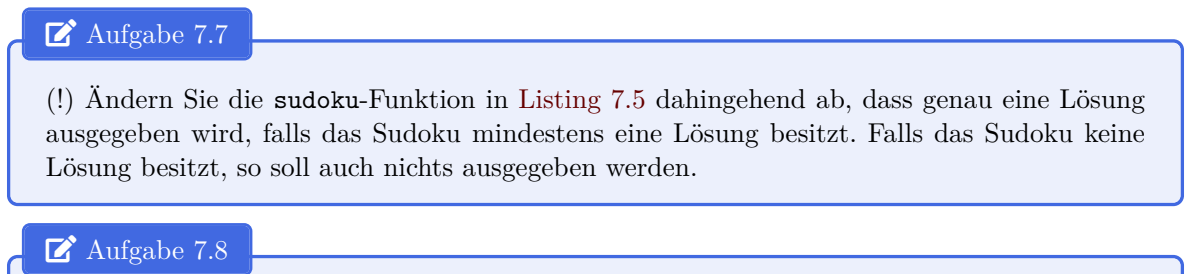
[picture p74: figure]
EDIT Aufgabe 7.8

(!) Ändern Sie die sudoku-Funktion in Listing 7.5 dahingehend ab, dass genau eine Lösung ausgegeben wird, falls das Sudoku mindestens eine Lösung besitzt. Falls das Sudoku keine Lösung besitzt, so soll auch nichts ausgegeben werden.

(!) Dies ist eine besonders schwierige Aufgabe. Wir betrachten das bekannte Damenproblem. Das Problem besteht darin, 8 Damen auf einem 8 × 8-Schachbrett so zu platzieren, dass sich keine zwei Damen gegenseitig bedrohen. Finden Sie Inspiration an unserem Sudoku-Löser und schreiben Sie ein rekursives Programm, welches alle Lösungen des Damenproblems ausgibt. Es gibt genau 92 unterschiedliche Lösungen für den 8 × 8-Fall. Betrachten Sie auch https://en.wikipedia.org/wiki/Eight_queens_puzzle#Counting_solutions_for_other_sizes_n. (https://en.wikipedia.org/wiki/Eight_queens_puzzle#Counting_solutions_for_other_sizes_n) Gelingt es Ihnen, das allgemeine n × n-Problem für n ∈ N zu lösen? Lösungsvorschlag zu Aufgabe 7.1
9 | 5 | | | | 7
7 | | 1 | 2 | 8
2 | 4 | 6 | 7 | 3 | 9 | 1
1 | 2 | 5 | 3
1 | 3 | 4 | 9
7 | 3 | 9 | 8 | 4
9 | 8 | 6
| | | 4 | | 1 | 6
2 | 4
ungelöstes Sudoku Nr. 2
9 | 5 | | | | 7
7 | | 1 | 2 | 8
2 | 4 | 6 | 7 | 3 | 9 | 1
1 | 2 | 5 | 3
1 | 3 | 4 | 9
7 | 3 | 9 | 8 | 4
9 | 8 | 6
| | | 4 | | 1 | 6
2 | 4
gelöstes Sudoku Nr.2
1 | 4 | 3 | 8 | 6 | 2
6 | 3 | 9 | 4 | 5
8 | 5
4 | 6 | 8 | 7 | 9
5 | 2 | 6 | 7 | 8
| | 5 | 2 | 1 | 6
3 | 5 | 1 | 4 | 2 | 7
9 | 8 | 7 | 2 | 3 | 5
6 | 5 | 1 | 7 | 9 | 3 | 8

Abbildung 7.10: Sudoku Nr. 2 (mit Lösungen)

Lösungsvorschlag zu Aufgabe 7.2

2 | 1 | 4 | 3
3 | 4 | 2 | 1
4 | 3 | 1 | 2
1 | 2 | 3 | 4
3 | 1 | 2 | 4
2 | 4 | 1 | 3
1 | 3 | 4 | 2
4 | 2 | 3 | 1
3 | 1 | 2 | 4
4 | 2 | 1 | 3
1 | 3 | 4 | 2
2 | 4 | 3 | 1
4 | 1 | 2 | 3
3 | 2 | 1 | 4
1 | 3 | 4 | 2
2 | 4 | 3 | 1
Abbildung 7.11: alle Lösungen des Sudokus in Abbildung 7.4

Lösungsvorschlag zu Aufgabe 7.3
1 def erlaubt(zeile, spalte, ziffer, gitter):
2 | # Prüfe, ob 'ziffer' bereits in der gegeben Zeile vorkommt.
3 | # (Fixiere die Zeile und gehe durch alle Spalten.)
4 | for j in range(4):
5 | if gitter[zeile][j] == ziffer:
6 | return False
7
8 | # Prüfe, ob 'ziffer' bereits in der gegeben Spalte vorkommt.
9 | # (Fixiere die Spalte und gehe durch alle Zeilen.)
10 | for i in range(4):
11 | if gitter[i][spalte] == ziffer:
12 | return False
13
14 | # Berechne Indizes der "linken oberen Ecke" des relevanten 2x2-Blocks.
15 | zeile_block = zeile - (zeile % 2)
16 | spalte_block = spalte - (spalte % 2)
17 | # Prüfe, ob 'ziffer' bereits in dem relevanten 2x2-Block vorkommt.
18 | for i_block in range(2):
19 | for j_block in range(2):
20 | if gitter[zeile_block+i_block][spalte_block+j_block] == ziffer:
21 | return False
22 | return True
Programm 7.6: Implementation der Funktion erlaubt Lösungsvorschlag zu Aufgabe 7.4
1 def erlaubt(zeile, spalte, ziffer, gitter): 2 n = int(np.sqrt(len(gitter[0])))

for j in range(n**2):
if gitter[zeile][j] == ziffer: return False

for i in range(n**2):
if gitter[i][spalte] == ziffer: return False

zeile_block = zeile - (zeile % n) spalte_block = spalte - (spalte % n)
for i_block in range(n):
for j_block in range(n):
if gitter[zeile_block+i_block][spalte_block+j_block] == ziffer: return False
return True
Programm 7.7: Funktion erlaubt für allgemeine Sudokus

Lösungsvorschlag zu Aufgabe 7.5
(a) Die Stationen sind in Abbildung 7.12 gegeben.
(b) Beim Zeichnen des Diagramms in Teilaufgabe (a) werden Sie festgestellt haben, dass die Arbeit mit Feldern, die das Setzen von mehr als einer Ziffer erlauben, den Aufwand erheblich erhöht. Es ist deshalb intuitiv klar, dass man zuerst alle Felder besetzen möchte, die nur eine Ziffer erlauben. Danach sollte man die Felder besetzen, welche nur zwei Ziffern erlauben und so weiter. Unser Vorgehen in Teilaufgabe (a) ist suboptimal, da wir beispielsweise als Erstes ein Feld zu füllen versuchen, welches zwei Ziffern erlaubt.

(0)
| 3
| 1 | | 4
3 | | 1

(1)
2 | 3
1 | 4
3 | | 1
| | (2)
2 | 3 | ×
1 | 4
3 | | 1

(3)
4 | 3
1 | 4
3 | | 1
| | (4)
4 | 3 | 2
1 | 4
3 | | 1
| | (5)
4 | 3 | 2 | 1
| 1 | | 4
3 | | 1

(6)
4 | 3 | 2 | 1
2 | 1 | | 4
3 | | 1

(7)
4 | 3 | 2 | 1
2 | 1 | 3 | 4
3 | | 1

(8)
4 | 3 | 2 | 1
2 | 1 | 3 | 4
3 | 2 | 1

(9)
4 | 3 | 2 | 1
2 | 1 | 3 | 4
3 | 2 | 1 | ×

(10)
4 | 3 | 2 | 1
2 | 1 | 3 | 4
3 | 4 | 1
(15)
4 | 3 | 2 | 1
2 | 1 | 3 | 4
3 | 4 | 1 | 2
1 | 2 | 4 | 3
Abbildung 7.12: alle Stationen

Lösungsvorschlag zu Aufgabe 7.6 Zeile 24 wird genau dann erreicht, wenn der rekursive Aufruf auf Zeile 21 abgeschlossen werden konnte. Dies ist genau dann der Fall, wenn der rekursive Aufruf einen return lieferte. Dazu gibt es exakt zwei Möglichkeiten:
return auf Zeile 28: Der return auf Zeile 28 wird genau dann ausgelöst, wenn der rekursive Aufruf auf Zeile 21 in eine „Sackgasse“ gelangt ist. Dies geschieht genau dann, wenn dieser Aufruf ein noch leeres Feld gefunden hat, in welches keine der 10 Ziffern gesetzt werden darf (Widerspruch). Die gesetzte Ziffer muss also wieder entfernt werden und wir versuchen es mit einer anderen Ziffer.
return auf Zeile 31: Der return auf Zeile 31 wird genau dann ausgelöst, wenn der rekursive Aufruf auf Zeile 21 in kein leeres Feld gefunden hat. Das bedeutet aber, dass dieser Aufruf eine gültige Lösung gefunden (und ausgegeben) hat. Durch das Entfernen der gesetzten Ziffer können rekursiv (falls vorhanden) weitere Lösungen gefunden werden (siehe auch Bemerkung 7.2). Lösungsvorschlag zu Aufgabe 7.7 Diese Funktion bricht ihre Berechnung ab, sobald eine Lösung gefunden wurde.
1 def sudoku(gitter):
2 | for zeile in range(9):
3 | for spalte in range(9):
4 | if (gitter[zeile][spalte] == 0):
5 | for ziffer in range(1,10):
6 | if erlaubt(zeile,spalte,ziffer,gitter):
7 | gitter[zeile][spalte] = ziffer
8 | solution_found = sudoku(gitter)
9 | if solution_found:
10 | return True
11 | gitter[zeile][spalte] = 0
12 | return
13 | print(np.array(gitter))
14 | return True
| Programm 7.8: Implementation der Funktion sudoku
| Lösungsvorschlag zu Aufgabe 7.8
Wir geben eine Lösung in Python und eine alternative Lösung in C++ an. Das Python-Programm verwendet eine globale Variable, was sehr unschön ist. Diese könnte man beispielsweise durch Python-Klassen vermeiden. Wir wollen an dieser Stelle aber nicht auf diese eingehen.

Lösung in Python

1 import numpy as np
2
3 def check_square(row, column, board, n):
4 | # check if column is already occupied by a queen in one of the rows above
5 | i = row - 1
6 | while (i >= 0):
7 | if board[i][column] == 1:
8 | return False
9 | i -= 1
10

# check north-western diagonal i = row - 1

j = column - 1
while ((i >= 0) and (j >= 0)): if board[i][j] == 1:
return False
i -= 1
j -= 1

# check north-eastern diagonal i = row - 1

j = column + 1
while ((i >= 0) and (j < n)): if board[i][j] == 1:
return False
i -= 1
j += 1

return True

31 number_of_solutions = 0
32 def solve_queen_problem(board, n, row = 0):
global number_of_solutions # can be done way prettier! for example with classes if (row == n):
number_of_solutions += 1
print(board)
return

for j in range(n):
if (check_square(row, j, board, n)): board[row][j] = 1
solve_queen_problem(board, n, row + 1) board[row][j] = 0

45 def run():
n = 8
board = np.zeros((n,n), dtype = int)
solve_queen_problem(board, n)
print("for n = {0:>2}".format(n), ", there are exactly", "{0:>15}".format(number_of_solutions ), " solutions", sep = '')

51 run()
Lösung in C++
1 #include "n_queen_problem.h"
2 #include <iostream>
3 int main() {
Queen_Problem Q = Queen_Problem(8); Q.solve_queen_problem();
std::cout << Q.get_number_of_solutions() << std::endl; return 0;
8 }

1 // n_queen_problem.h

3 class Queen_Problem
4 {
public:
Queen_Problem(const unsigned int); ~Queen_Problem(void)
{

9 | for (unsigned int i = 0; i < n; ++i)
10 | {
11 | delete[] board[i];
12 | }
13 | delete[] board;
14 | }
15 | void print_solution(void) const;
16 | bool check_square(const unsigned int, const unsigned int) const;
17 | void solve_queen_problem(const unsigned int = 0);
18 | unsigned long long get_number_of_solutions(void) const
19 | {
20 | return number_of_solutions;
21 | }
22
23 | private:
24 | unsigned long long number_of_solutions;
25 | unsigned int n;
26 | bool** board;
27 };

1 // n_queen_problem.cpp
2
3 #include <iostream>
4 #include <cstring>
5 #include "n_queen_problem.h"
6
7 Queen_Problem::Queen_Problem(const unsigned int board_size) : number_of_solutions{0}, n{
| board_size}
8 {
9 | board = new bool*[n];
10 | for (unsigned int i = 0; i < n; ++i)
11 | {
12 | board[i] = new bool[n];
13 | memset(board[i], false, n * sizeof(bool));
14 | }
15 }
16
17 void Queen_Problem::print_solution(void) const
18 {
19 | std::cout << "\n";
20 | for (unsigned int i = 0; i < n; ++i)
21 | {
22 | for (unsigned int j = 0; j < n; ++j)
23 | {
24 | std::cout << board[i][j] << " ";
25 | }
26 | std::cout << "\n";
27 | }
28 | std::cout << "\n";
29 }
30
31 bool Queen_Problem::check_square(const unsigned int row, const unsigned int column) const
32 {
33 | int i;
34 | int j;
35
36 | // check if column is already occupied by a queen in one of the rows above
37 | for (i = row - 1; i >= 0; --i)
38 | {
39 | if (board[i][column] == 1)
40 | {
41 | return false;

}
}

// check north-western diagonal
for (i = row - 1, j = column - 1; (i >= 0) and (j >= 0); --i, --j)
{
if (board[i][j] == 1)
{
return false;
}
}

// check north-eastern diagonal
for (i = row - 1, j = column + 1; (i >= 0) and (j < static_cast<int>(n)); --i, ++j)
{
if (board[i][j] == 1)
{
return false;
}
}
return true;
63 }

65 void Queen_Problem::solve_queen_problem(const unsigned int row)
66 {
if (row == n)
{
print_solution();
++number_of_solutions;
return;
}

for (unsigned int j = 0; j < n; ++j)
{
if ( check_square(row, j) )
{
board[row][j] = 1;
solve_queen_problem(row + 1); board[row][j] = 0;
}
}
83 }

# Literatur

[1] Armin P. Barth. Mathematik fürs Gymnasium (Band 1, 1. Auflage). Mathematik fürs Gymnasium (Band 1 von 4). hep, 2021. isbn: 978-3-0355-1786-6.
[2] Terence Tao. Analysis I (Third Edition). Texts and Readings in Mathematics. Springer Singapore, 2016. isbn: 978-981-10-1789-6.
[3] Herbert Amann und Joachim Escher. Analysis I (3. Auflage). Amann-Escher Analysis (Band 1 von 3). Birkhäuser Verlag, 2006. isbn: 3 7643 7755 0.
[4] Edmund Landau. Grundlagen der Analysis (Das Rechnen mit ganzen, rationalen, irrationalen, komplexen Zahlen). Ergänzung zu den Lehrbüchern der Differential- und Integralrechnung. Akademische Verlagsgesellschaft M.B.H. Leipzig, 1992.
[5] Piotr Łukowski. Paradoxes. TRENDS IN LOGIC Studia Logica Library. Dordrecht Heidelberg London New York, 2011. isbn: 978-94-007-1475-5.
[6] Felix Friedrich. Vorlesung: Datenstrukturen und Algorithmen an der ETH Zürich. 2018. url: https://lec.inf.ethz.ch/DA/2018/slides/daLecture1.handout.2x2.pdf (besucht am
04. 12. 2023).
[7] Albert Paul Malvino und Jerald A. Brown. Digital Computer Electronics (Third Edition). McGraw-Hill Inc.,US, 1930.
[8] Markus Sauter. Design eines programmierbaren Rechners. Bildungsportal der ETH Zürich, 2006.
[9] Thomas H. Cormen, Charles E. Leiserson, Ronald L. Rivest und Clifford Stein. Introduction to Algorithms, Third Edition. The MIT Press, 2009.
