pythonnoob9903/MA-project/Random/mapresinotizen.docx

First

What a drone is

Unmanned flying vehicle with remote control

Autonomous planes/helicopters or this work quadcopter

Does anybody of you own a drone or know any brand that manufactures a drone?

DJI→Monopoly(not self-built)

Software preinstalled and proprietary software
→ only what needs to be seen (background progresses???), especially terms and conditions, where data is going

Contrary OS→ code checked

However, outdated→ not integrated into a system, software integration needs to be done

Drone structure
