pythonnoob9903/MA-project/pictures/Battery.png

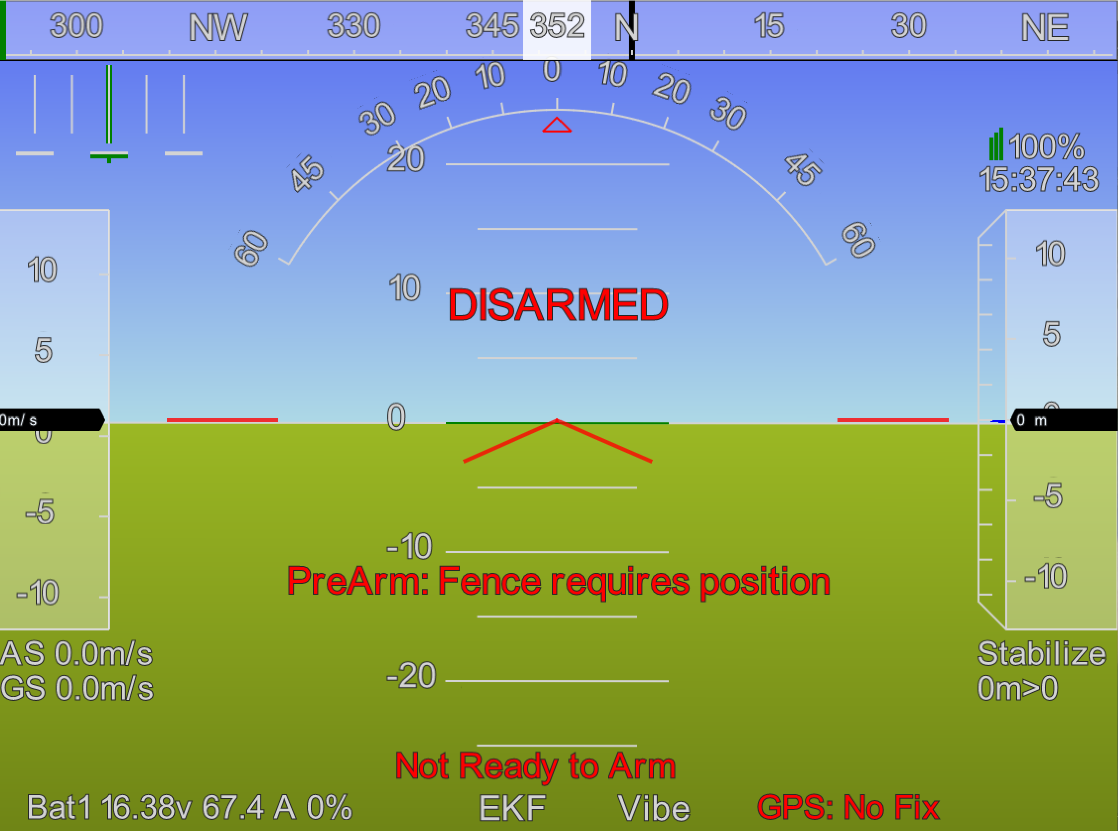
pictures/Battery.png
