pythonnoob9903/MA-project/pictures/forece_arm_rejected.png

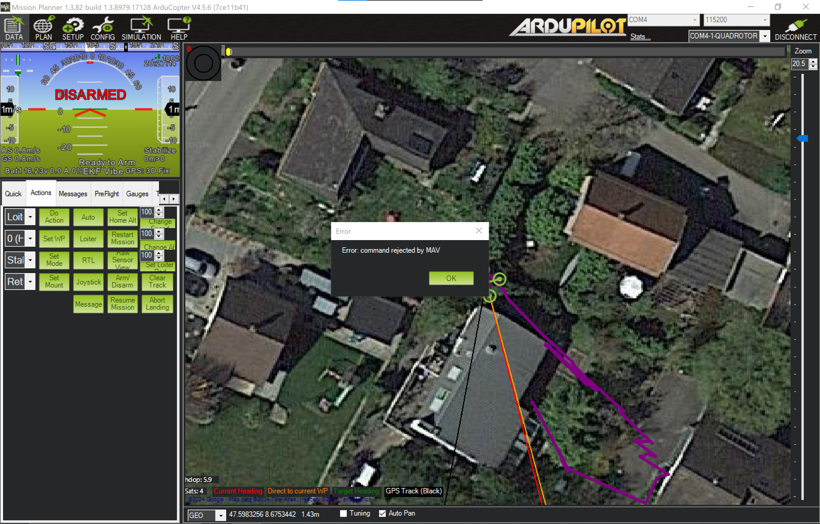
pictures/forece_arm_rejected.png
