pythonnoob9903/MA-project/pictures/GPS_inside1.png

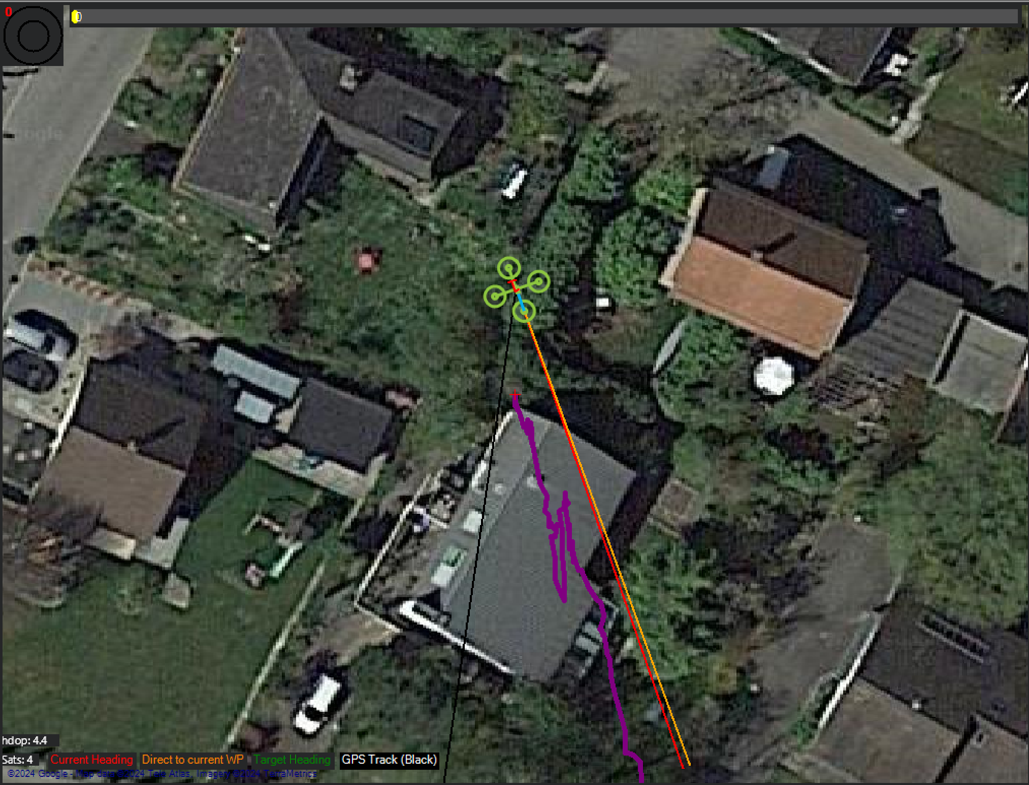
pictures/GPS_inside1.png
