pythonnoob9903/MA-project/pictures/GPS_inside2.png

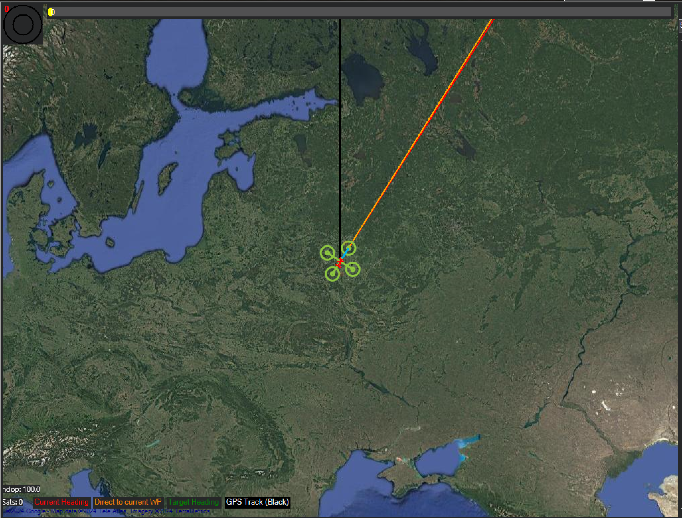
pictures/GPS_inside2.png
