pythonnoob9903/MA-project/pictures/Gyro_pos1.png

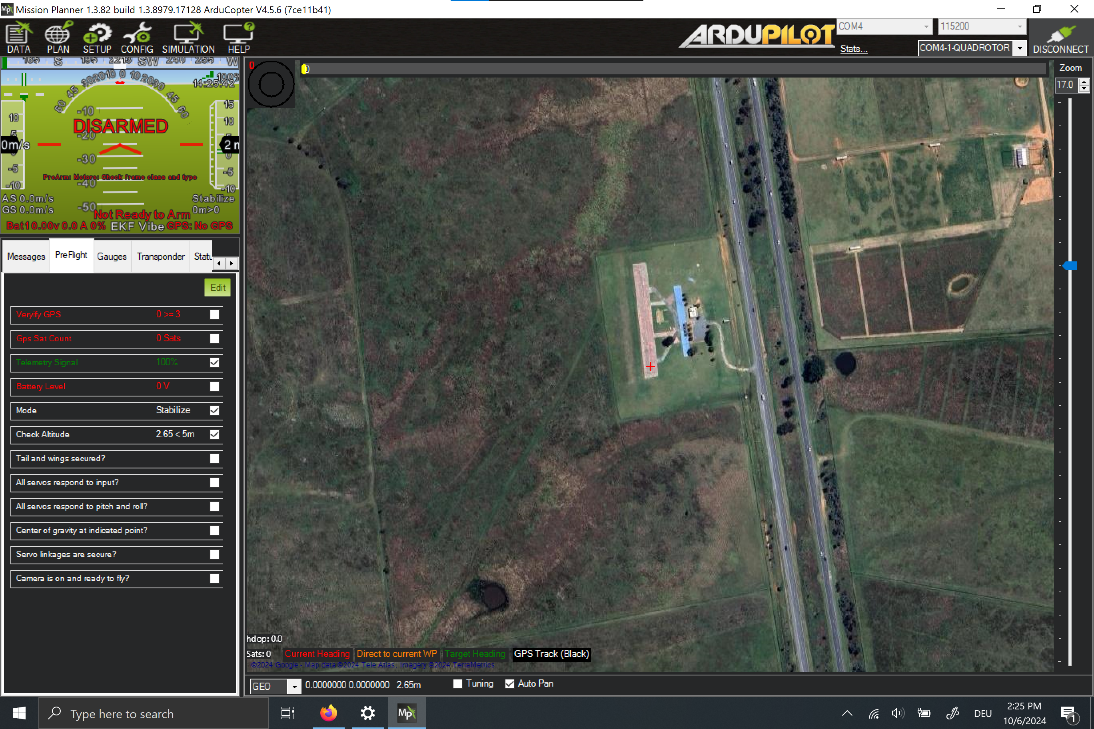
pictures/Gyro_pos1.png
