pythonnoob9903/MA-project/pictures/Gyro_pos1_large.png

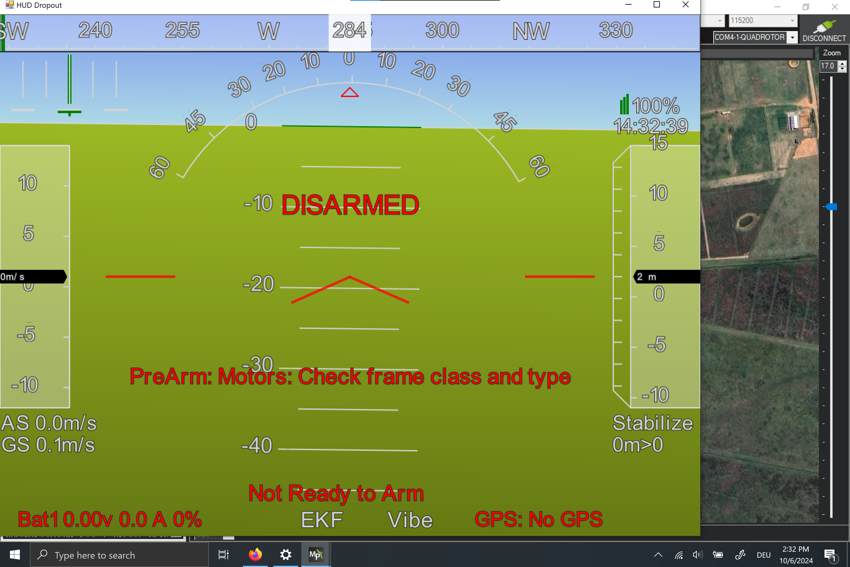
pictures/Gyro_pos1_large.png
