pythonnoob9903/MA-project/pictures/Gyro_pos2_large.png

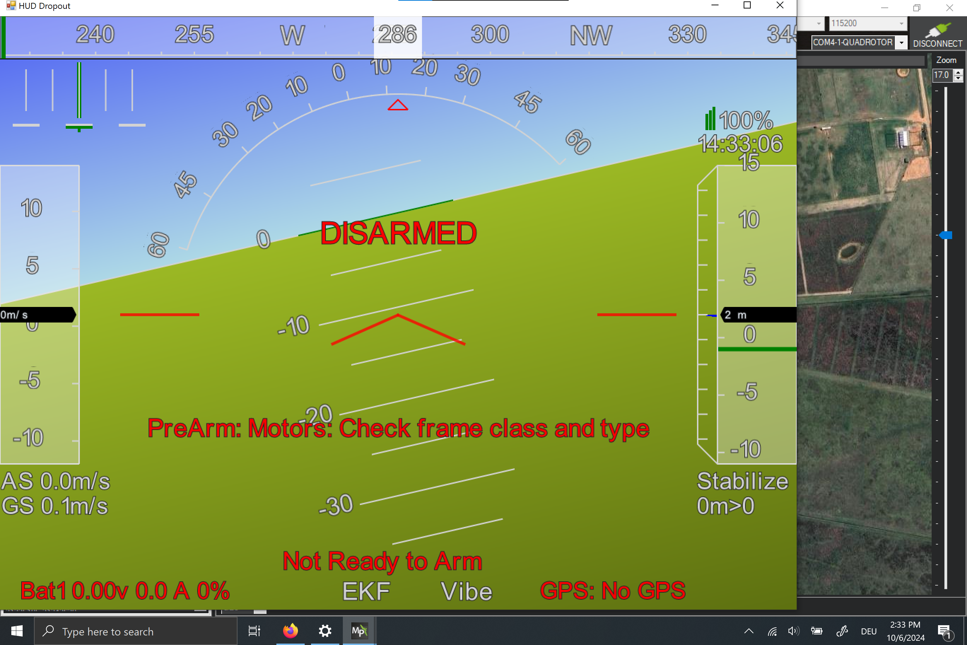
pictures/Gyro_pos2_large.png
