pythonnoob9903/MA-project/pictures/Gyro_pos_neutral_large.png

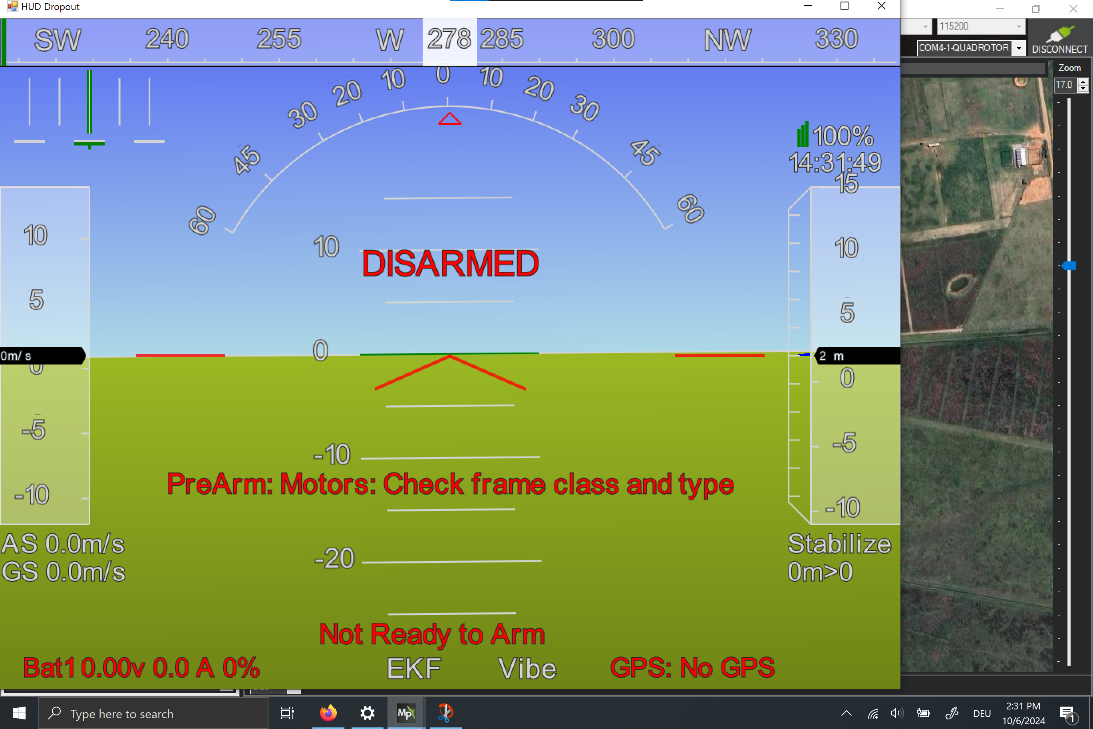
pictures/Gyro_pos_neutral_large.png
