pythonnoob9903/MA-project/pictures/log.png

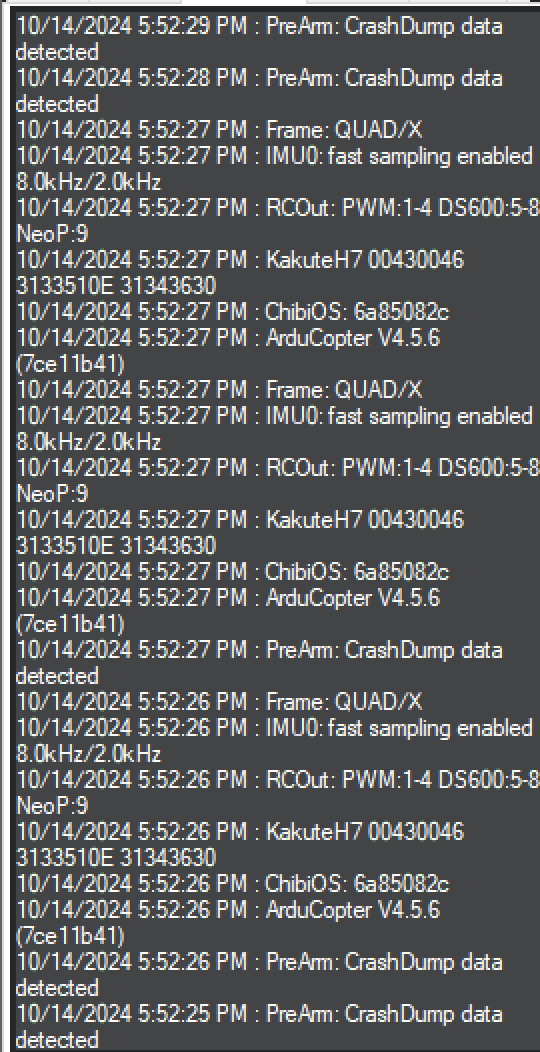
pictures/log.png
