pythonnoob9903/MA-project/pictures/prearmcheck.png

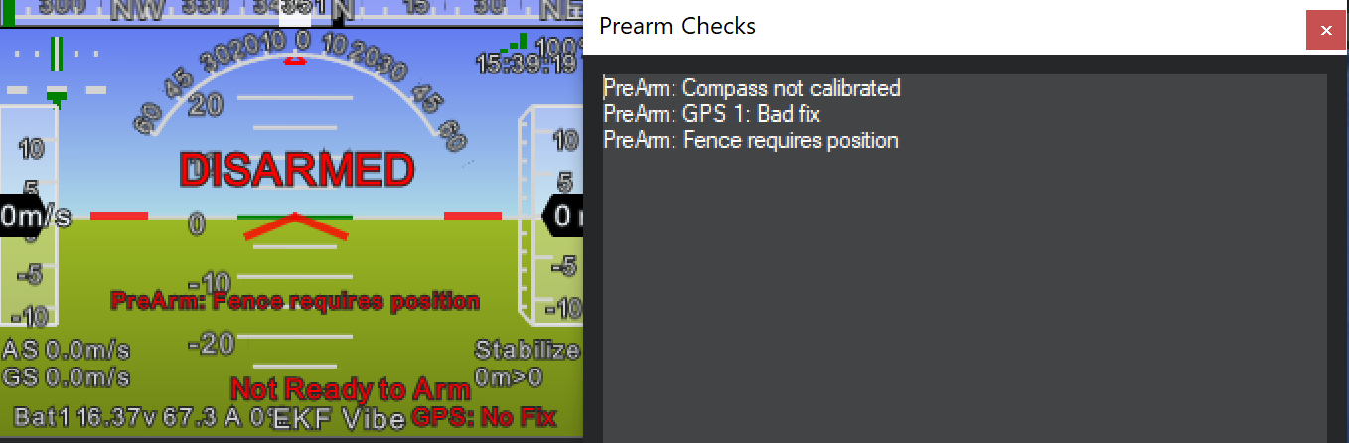
pictures/prearmcheck.png
