pythonnoob9903/MA-project/pictures/Ready_to_Arm.png

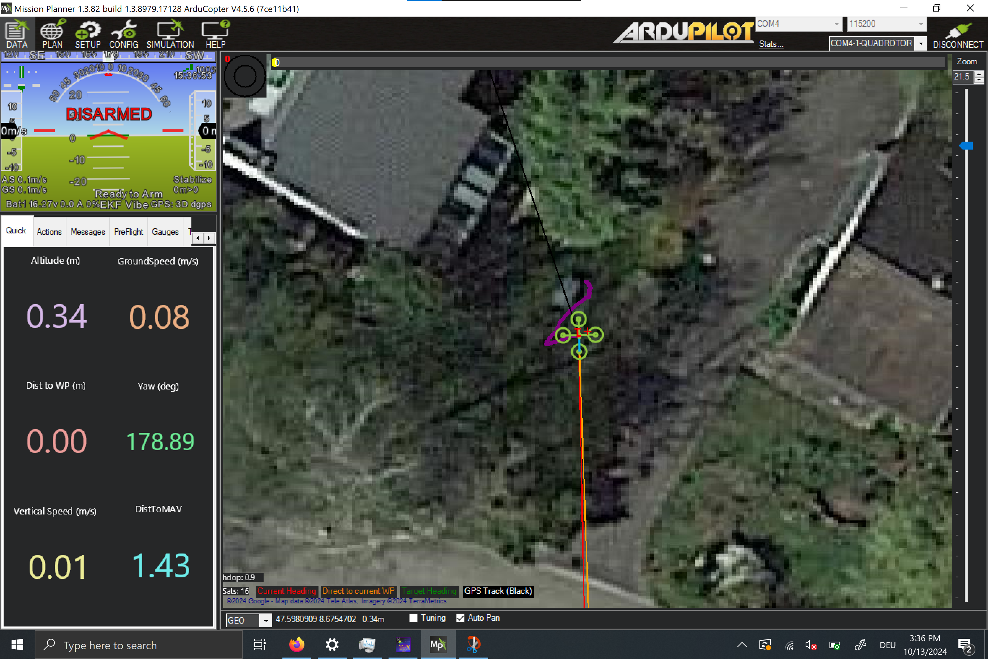
pictures/Ready_to_Arm.png
