pythonnoob9903/MA-project/Random/Untitled Diagram.drawio.png

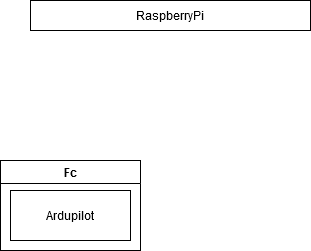
Random/Untitled Diagram.drawio.png
