pythonnoob9903/MA-project/Flight controller list.xlsx

Sheet: flight controller
flight controller | in stock | how expensive | AIO/stack possible | link | frame | cost | weight | link
Aocoda-RC H743 | yes | 45 | no |  | aos v5 inch | 90
Foxeer H7 MPU6000 | yes | 105 | no |  | source on v5 | 35 |  | https://www.pureflight.ch/fr/source-one/3207-tbs-source-one-v5-5.html
Kakute H7 v1.3 (MPU6000) | yes | 60 | no
Holybro Kakute H7 V2 | no |  |  |  | motor | cost
AnyleafH7 | no
AocodaRC H743Dual | yes | 45 | no | https://www.aocoda-rc.com/products/47
Flywoo F745 AIO BL_32/ Nano |  |  | AIO |  | battery | cost
Foxeer H743 MPU600 | yes | 105 | no | https://www.foxeer.com/foxeer-h7-mpu6000-fc-8s-dual-bec-barometer-x8-g-503
Foxeer Reaper F745-AIO V2 |  |  | AIO
Holybro Kakute F7 AIO |  |  | AIO
Holybro Kakute H7 V1 | yes | 60 | no | https://holybro.com/products/kakute-h7
Holybro Kakute H7 V2 | no |  |  |  | telemetry device | cost
iFlight Beast F7 45A AIO |  |  | AIO
iFlight BeastH7 AIO |  |  | AIO
iFlight Blitz F745/F745 Mini | yes | 60(120) | stack possible | https://shop.iflight.com/electronics-cat27/BLITZ-Mini-F745-Stack-Mini-E55-ESC-Pro2154 | esc | cost
iFlight Blitz Whoop F7 AIO |  |  | AIO
Mamba H743 v4 | yes | 75 | possible | https://www.rotorama.com/product/diatone-mamba-mk4-h743-v2
mRo ControlZero F7 |  | 350
mRo ControlZero H7 |  | 350
mRo COntrolZero H7 OEM |  | 350
mRo Pixracer Pro (H7) |  | 350
Omnibus F7V2 | not produced
QioTek Zealot H743 | yes | weird | not
SDMODEL SDH7V1 | weird chinese side
SDMODEL H7 V2 | no?
SkystarsH7HD | not right now | 72
SPRacing H7 Extreme | no
SPRacing H7 RF | yes | 70 | no | https://shop.seriouslypro.com/flight-controllers/sp-racing-h7-rf
YJUAV A6SE H743

Sheet: weight
raspberry pi | 46
pi camera | 3
kakute h7 v1.3 | 8
esc
battery
frame
motors
props
