pythonnoob9903/MA-project/RaspberryPi Mount/LowerPiMount/LowerPiMount.FCStd

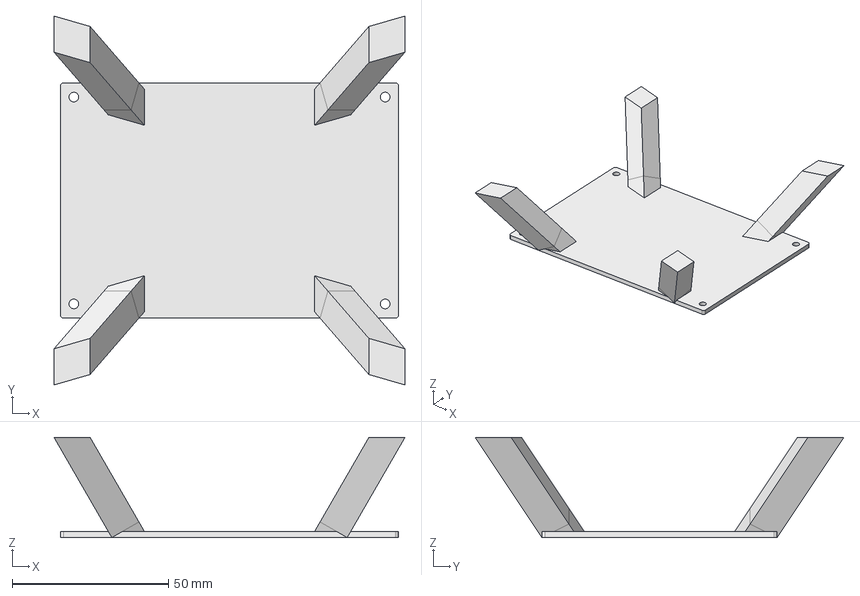
[picture p87: CAD file, 2024-11-17]
RaspberryPi Mount/LowerPiMount/LowerPiMount.FCStd
112.2 x 117.9 x 32.0 mm
