pythonnoob9903/MA-project/RaspberryPi Mount/LowerPiSupport/LowerPiSupport.FCStd

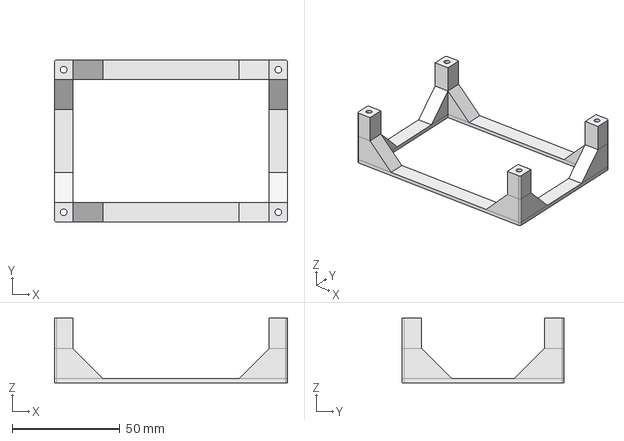
[picture p88: CAD file, 2024-11-17]
RaspberryPi Mount/LowerPiSupport/LowerPiSupport.FCStd
108.0 x 75.2 x 30.0 mm
