pythonnoob9903/MA-project/RaspberryPi Mount/UpperPiMount/UpperPiMount.FCStd

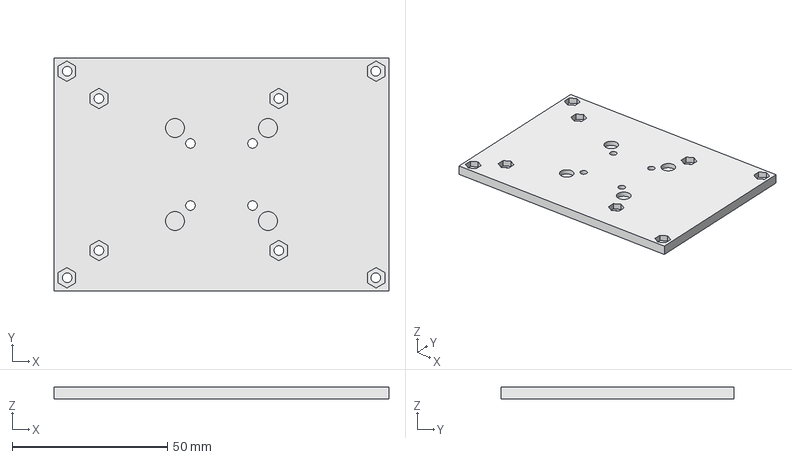
[picture p89: CAD file, 2024-11-05]
RaspberryPi Mount/UpperPiMount/UpperPiMount.FCStd
108.0 x 75.2 x 4.00 mm
