pythonnoob9903/MA-project/(list of files, cad)

Other CAD files:
RaspberryPi Mount/LowerPiMount/LowerPiMount.stl
RaspberryPi Mount/LowerPiSupport/LowerPiSupport.stl
RaspberryPi Mount/UpperPiMount/UpperPiMount.stl
