pythonnoob9903/MA-project/pictures/GNSS_fix.png

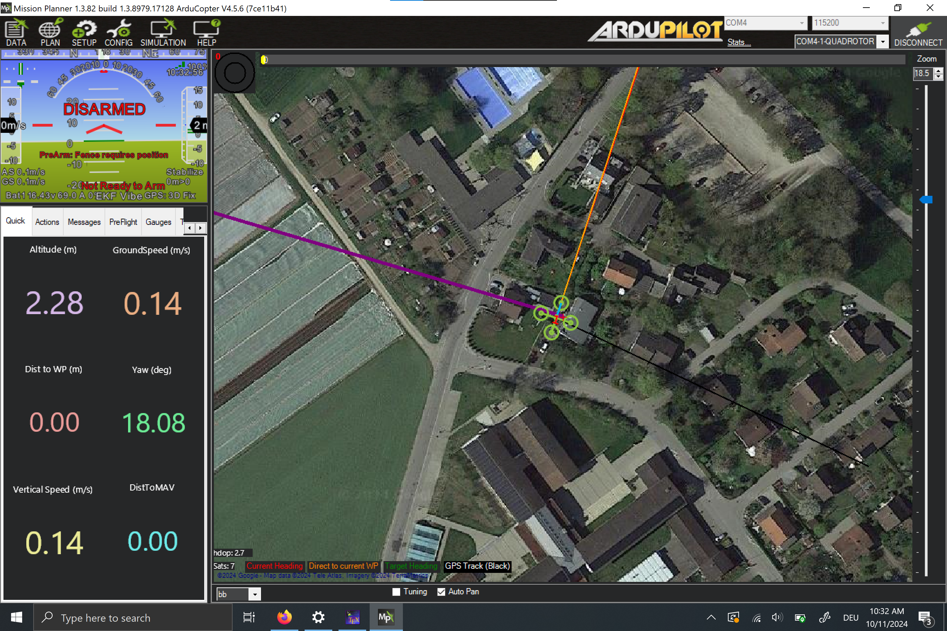
pictures/GNSS_fix.png
