pythonnoob9903/MA-project/Random/Untitled Diagram.drawio.pdf

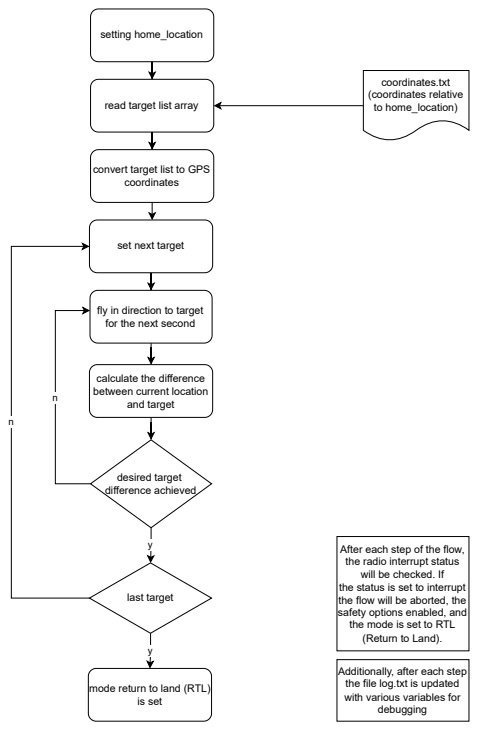
[picture p93: page 1]
setting home_location; coordinates.txt (coordinates relative to home_location); desired target difference achieved; last target; is set

read target list array

convert target list to GPS
coordinates

set next target

fly in direction to target
for the next second

calculate the difference
between current location
and target

After each step of the flow,
the radio interrupt status
will be checked. If
the status is set to interrupt
the flow will be aborted, the
safety options enabled, and
the mode is set to RTL
(Return to Land).

Additionally, after each step
the file log.txt is updated
with various variables for
debugging

mode return to land (RTL)
