pythonnoob9903/MA-project/(commit log)

2024-09-25 changes in file destination
    -moved pictures into folder
    -added excel list for fc
    [Flight controller list.xlsx]
2024-09-29 change Ground Station
    - added different Ground Station with quick explanation
    - added links in .bib for STM32 Cube Programmer and Ardupilot Firmware
2024-10-06 -GPS problems
    -added pictures of Yaw connection to GCS
    - no GPS connection(No idea why)
2024-10-10 GNSS/Receiver/begin of Compass
    -introduction ideas
    -added parts of ESC/Fc
    -began Protocols
    -added smoke stopper
    -GPS and receiver connection
    -compass still fails, but I probably know how to fix it
2024-10-13 getting drone ready to arm
    - prearm checks
    - compass calibration?
    - motor testing
    - bench arming
2024-10-14 start writing, first "flight"
    - began software consideration chapter
    - bench testing with and without props
    - first spinning outside
2024-10-18 drone flies
    - getting drone to fly stable, via BLhelisuite32 and tweaking parameters
    [parameters_before_reflash.param]
2024-10-18 writing
    - added to Fc
    - added ESC
    - added Problems with parts
2024-10-19 writing, filming the working drone
    - added Motor, Battery, Problems with Batteries, GCS, Firmware installation, GPS connection
2024-10-20 writing
    - added/edited GNSS, Radio/Transmitter, Smoke stopper, props/battery charger, reciever/transmitter, battery, motor test, compass callibration
2024-10-20 writing + inserting pictures
    - added the pictures
    - added road to first flight
2024-10-27 raspberry pi ssh connection
    - minor TODOs added
2024-11-05 3D objects
    -UpperPiMount
    -LowerPiSupport(not finished)
    [LowerPiSupport.FCStd, UpperPiMount.FCStd]
2024-11-09 3D designing
    -finishing LowerPiSupport
    -creating LowerPiMount
    -beginning glossary
    [LowerPiMount.FCStd, LowerPiMount.stl, LowerPiSupport.FCStd, LowerPiSupport.stl, UpperPiMount.stl]
2024-11-10 designing/arming script
    - designing and redesigning LowerPiMount
    - arming via python script
    [LowerPiMount.FCStd, LowerPiMount.stl]
2024-11-17 Channels/writing
    - getting channel value in dronekit
    - beginning to write RaspPi Setup
    [LowerPiMount.FCStd, LowerPiSupport.FCStd]
2024-11-24 added python code from RaspberryPi
    [mav.parm]
2024-11-24 adding comments to .py
    - adding comments from flow chart(on paper) to dronekittest.py
2024-12-01 minor code changes due to errors when testing on RaspberryPi
    [coordinatesread.py, dronekittest.py]
2024-12-03 code and documentation update
    - code failsafe updated and added comments
    - documentation updated
    [coordinatesread.py, dronekittest.py]
2024-12-04 Commit Title: improved code Commit Description: - trouble shooted code and got rid of errors
    [coordinatesread.py, dronekittest.py]
2024-12-08 log, Zcord
    - adding a log function
    - changing print() to log()
    - adding a function that changes Zcord
2024-12-08 failed test flight log and error fixing
    [coordinatesread.py, dronekittest.py]
2024-12-15 test flight fail logs/minor code changes
    [coordinatesread.py, dronekittest.py]
2024-12-27 writing/editing
    - finished editing of the written text
    - writing motivation and goal
    - writing data transfer protocol
    - writing better motor description
    - changing radio/transmitter section
2024-12-28 code changes for failed testflight
    [coordinatesread.py, dronekittest.py]
2024-12-29 fixing coordinate problem
    - fixing the undefined Xcord error
    [coordinatesread.py, dronekittest.py, test.py]
2024-12-29 log of weird bugs and problems
    [coordinatesread.py, dronekittest.py]
2024-12-29 minor code fixes
    - probably getting rid of not supscriptable error
    [coordinatesread.py, dronekittest.py]
2025-01-03 log from hdop problems
    [coordinatesread.py, dronekittest.py]
2025-01-04 finalising document.tex
    - adding flowchart, connections between the parts, and assembled drone picture
    - lots of reviewing
    - adding conclusion and renewing the literature review
